Duy-Thanh/DroneShipping/SYM/CR1220/CR1220.step

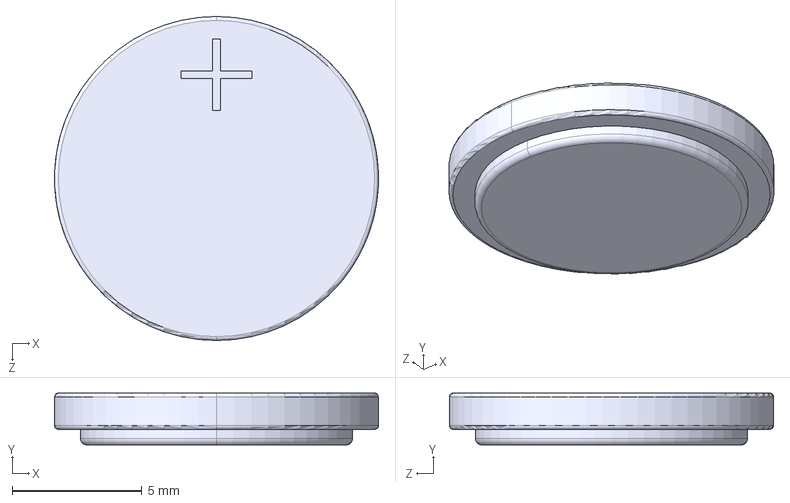
[picture p67: CAD file, 2025-03-07]
SYM/CR1220/CR1220.step
12.5 x 2.00 x 12.5 mm
