Duy-Thanh/DroneShipping/SYM/KiCad_Devices-master/KiCad_Devices-master/WSK1216/Footprint/WSK1216.STEP

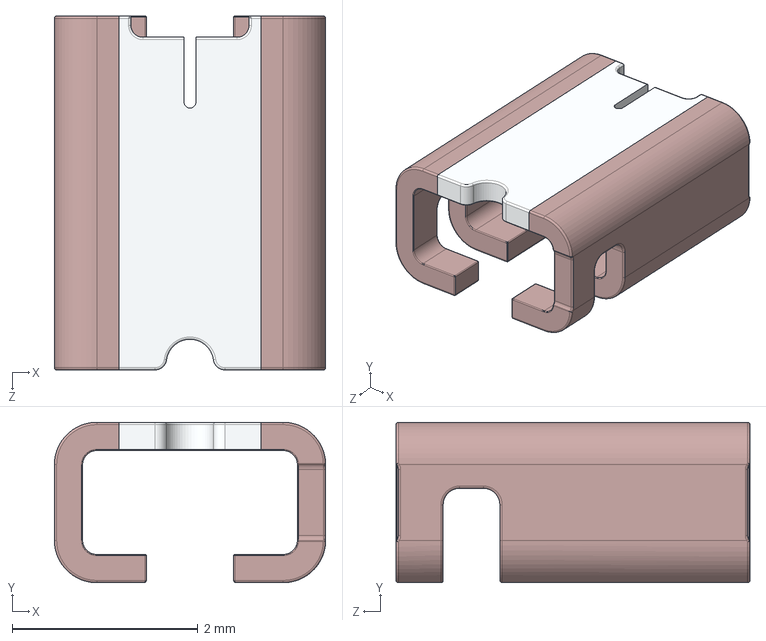
[picture p68: CAD file, 2025-03-07]
SYM/KiCad_Devices-master/KiCad_Devices-master/WSK1216/Footprint/WSK1216.STEP
2.92 x 1.73 x 3.81 mm
WSK1216-L5_element - Copy
WSK1216-L5_terminals - Copy
