Duy-Thanh/DroneShipping/SYM/SparkFun-KiCad-Libraries/Footprints/SparkFun-3D-models/Battery/XH414H-IV01E.STEP

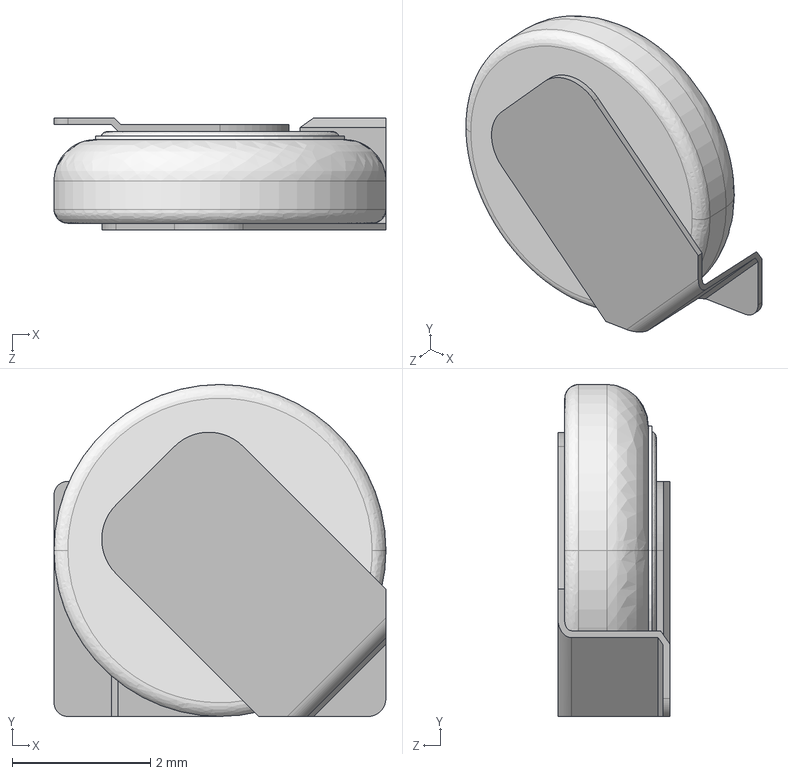
[picture p69: CAD file, 2025-03-07]
SYM/SparkFun-KiCad-Libraries/Footprints/SparkFun-3D-models/Battery/XH414H-IV01E.STEP
4.80 x 4.80 x 1.63 mm
isolator
cleme
Anode
Negative
Positive
