Duy-Thanh/DroneShipping/SYM/SparkFun-KiCad-Libraries/Footprints/SparkFun-3D-models/Capacitor/C_1206_3216Metric.step

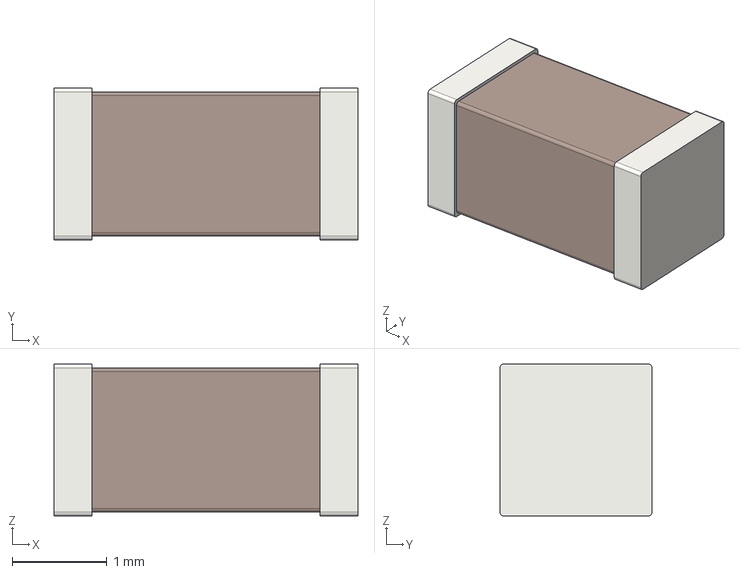
[picture p70: CAD file, 2025-03-07]
SYM/SparkFun-KiCad-Libraries/Footprints/SparkFun-3D-models/Capacitor/C_1206_3216Metric.step
3.20 x 1.60 x 1.60 mm
