Duy-Thanh/DroneShipping/SYM/SparkFun-KiCad-Libraries/Footprints/SparkFun-3D-models/Clock/Crystal_SMD_3.2x2.5mm.STEP

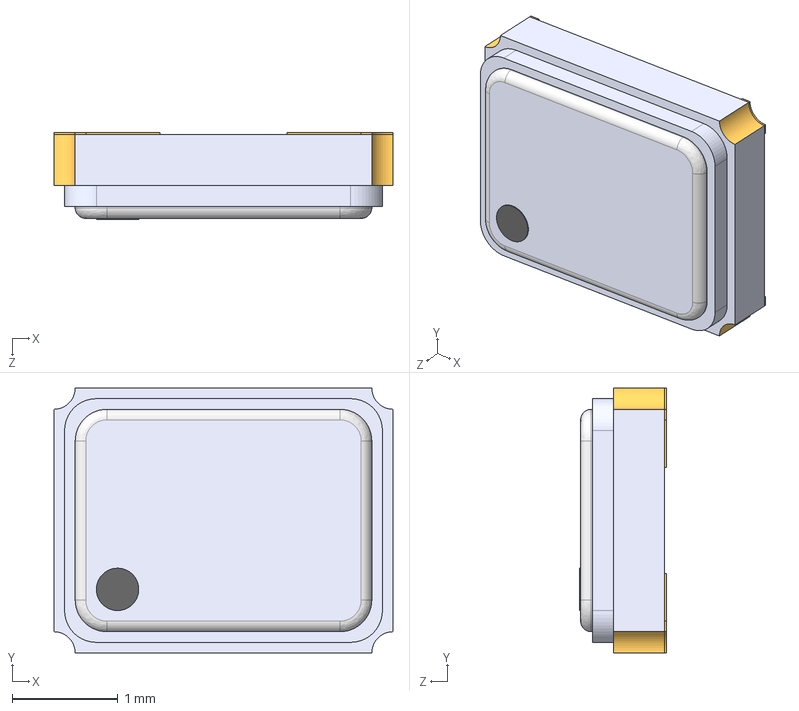
[picture p71: CAD file, 2025-03-07]
SYM/SparkFun-KiCad-Libraries/Footprints/SparkFun-3D-models/Clock/Crystal_SMD_3.2x2.5mm.STEP
3.20 x 2.50 x 0.82 mm
MetalFrame
Pin1Marker
Pin3
Pin1
Lid
Pin4
Pin2
Ceramic
