Duy-Thanh/DroneShipping/SYM/SparkFun-KiCad-Libraries/Footprints/SparkFun-3D-models/Coil/Inductor_7.3x6.6mm.stp

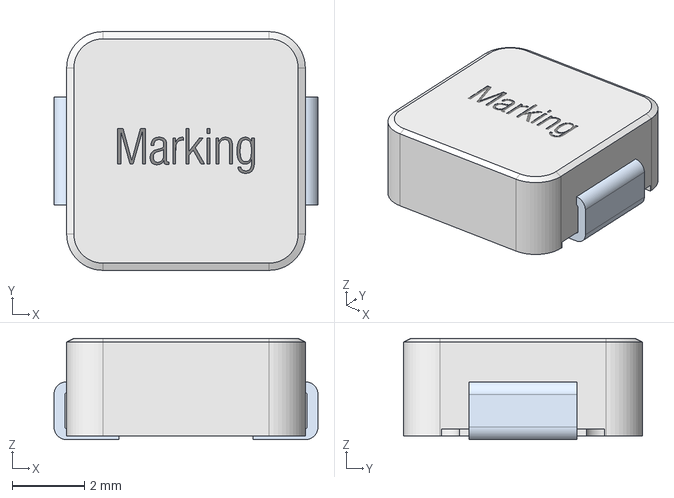
[picture p72: CAD file, 2025-03-07]
SYM/SparkFun-KiCad-Libraries/Footprints/SparkFun-3D-models/Coil/Inductor_7.3x6.6mm.stp
7.30 x 6.60 x 2.80 mm
