Duy-Thanh/DroneShipping/SYM/SparkFun-KiCad-Libraries/Footprints/SparkFun-3D-models/Connector/JST_SMD_1.25mm-6_Locking.step

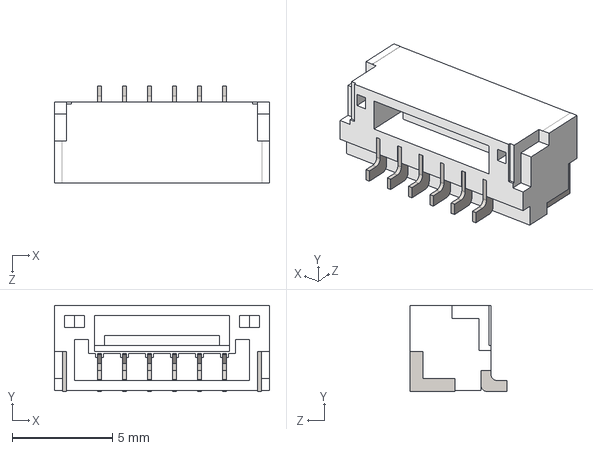
[picture p73: CAD file, 2025-03-07]
SYM/SparkFun-KiCad-Libraries/Footprints/SparkFun-3D-models/Connector/JST_SMD_1.25mm-6_Locking.step
10.8 x 4.30 x 4.85 mm
