Duy-Thanh/DroneShipping/SYM/SparkFun-KiCad-Libraries/Footprints/SparkFun-3D-models/Display/UG-2864KSWLG01.step

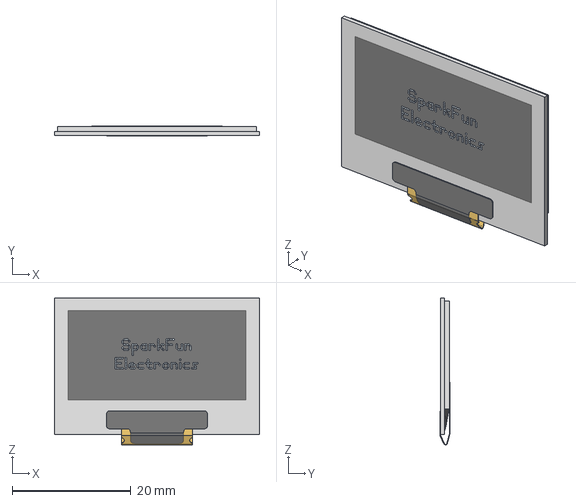
[picture p74: CAD file, 2025-03-07]
SYM/SparkFun-KiCad-Libraries/Footprints/SparkFun-3D-models/Display/UG-2864KSWLG01.step
34.5 x 1.75 x 24.7 mm
