Duy-Thanh/DroneShipping/SYM/SparkFun-KiCad-Libraries/Footprints/SparkFun-3D-models/Electromechanical/Buzzer_9mm_SMD.step

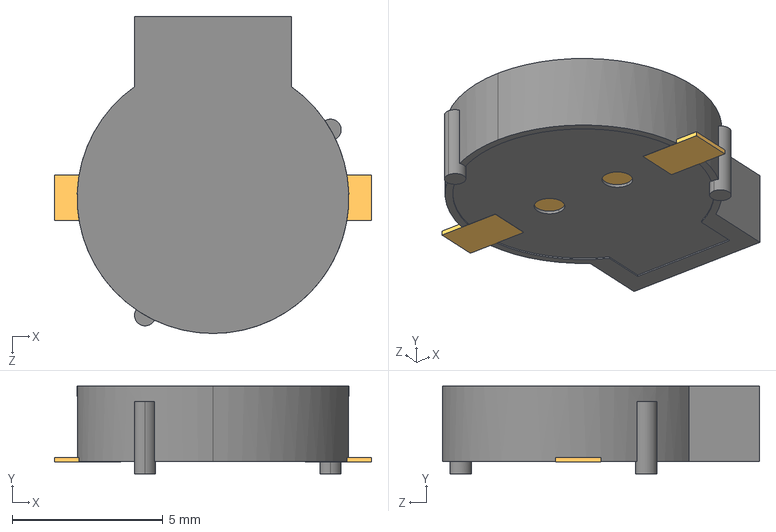
[picture p75: CAD file, 2025-03-07]
SYM/SparkFun-KiCad-Libraries/Footprints/SparkFun-3D-models/Electromechanical/Buzzer_9mm_SMD.step
10.5 x 2.90 x 10.5 mm
