Duy-Thanh/DroneShipping/SYM/SparkFun-KiCad-Libraries/Footprints/SparkFun-3D-models/Fuse/Fuse_1812_4532Metric.step

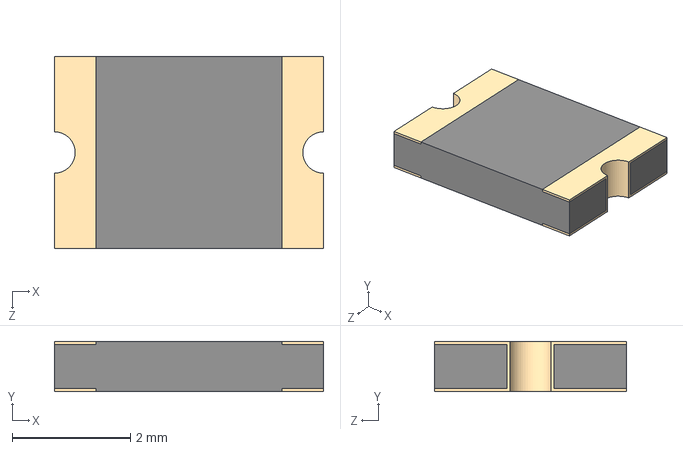
[picture p76: CAD file, 2025-03-07]
SYM/SparkFun-KiCad-Libraries/Footprints/SparkFun-3D-models/Fuse/Fuse_1812_4532Metric.step
4.55 x 0.85 x 3.24 mm
