Duy-Thanh/DroneShipping/SYM/SparkFun-KiCad-Libraries/Footprints/SparkFun-3D-models/GPS/NEO.STEP

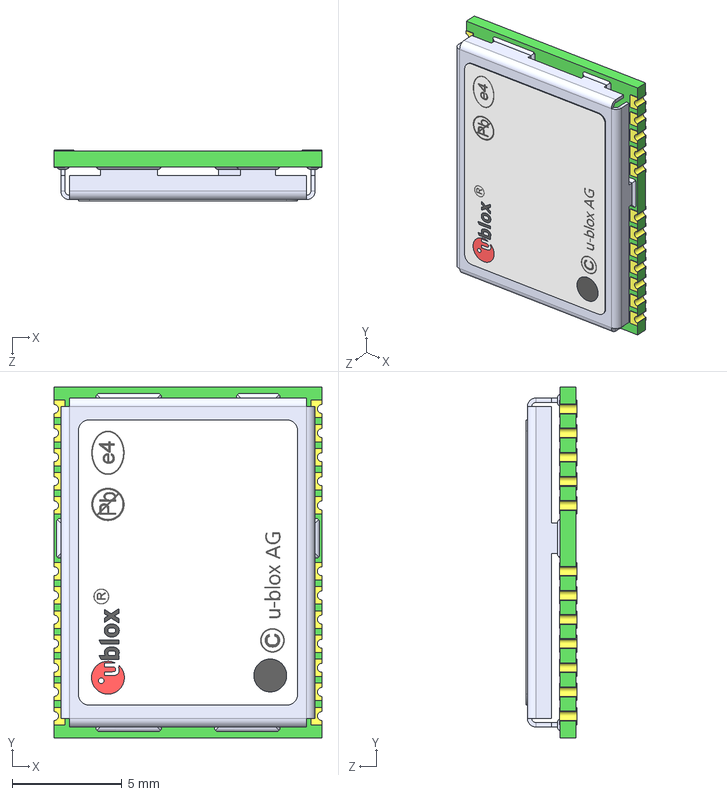
[picture p77: CAD file, 2025-03-07]
SYM/SparkFun-KiCad-Libraries/Footprints/SparkFun-3D-models/GPS/NEO.STEP
12.2 x 16.0 x 2.33 mm
NEO_PCB
Shield_NEO
u-blox_NEO_label
