Duy-Thanh/DroneShipping/SYM/SparkFun-KiCad-Libraries/Footprints/SparkFun-3D-models/LED/LED_1206_3216Metric_Castellated_White.step

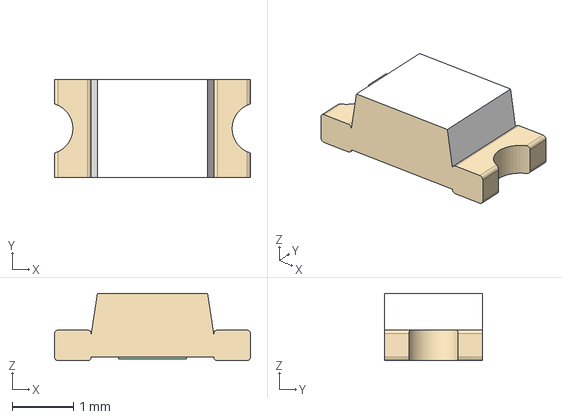
[picture p78: CAD file, 2025-03-07]
SYM/SparkFun-KiCad-Libraries/Footprints/SparkFun-3D-models/LED/LED_1206_3216Metric_Castellated_White.step
3.20 x 1.60 x 1.10 mm
