Duy-Thanh/DroneShipping/SYM/SparkFun-KiCad-Libraries/Footprints/SparkFun-3D-models/Resistor/R_0805_2012Metric.step

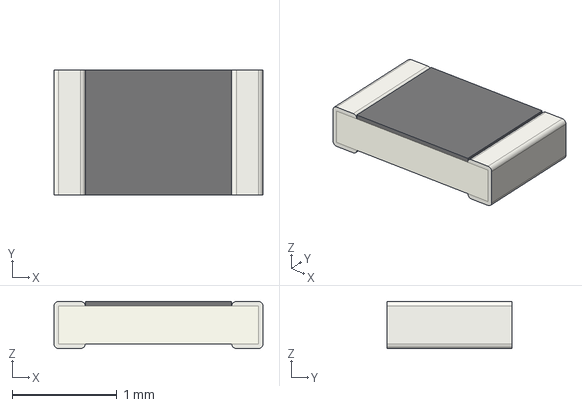
[picture p79: CAD file, 2025-03-07]
SYM/SparkFun-KiCad-Libraries/Footprints/SparkFun-3D-models/Resistor/R_0805_2012Metric.step
2.00 x 1.20 x 0.45 mm
