Duy-Thanh/DroneShipping/SYM/SparkFun-KiCad-Libraries/Footprints/SparkFun-3D-models/RF/ESP32-S3-MINI.step

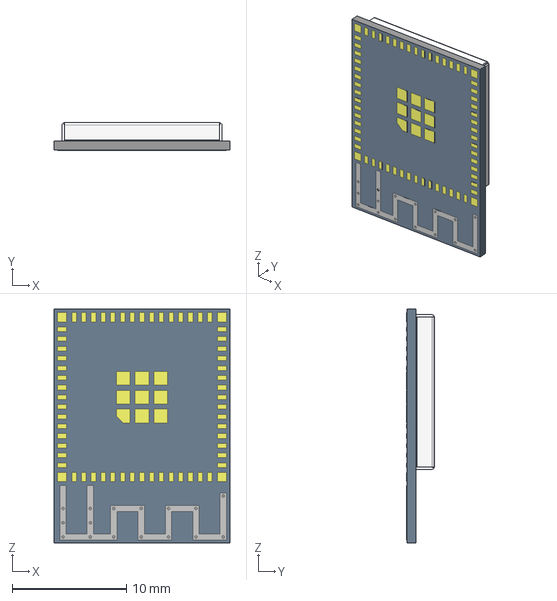
[picture p80: CAD file, 2025-03-07]
SYM/SparkFun-KiCad-Libraries/Footprints/SparkFun-3D-models/RF/ESP32-S3-MINI.step
15.4 x 2.42 x 20.5 mm
