Duy-Thanh/DroneShipping/SYM/SparkFun-KiCad-Libraries/Footprints/SparkFun-3D-models/Semiconductor-Nonstandard/Ag9200.step

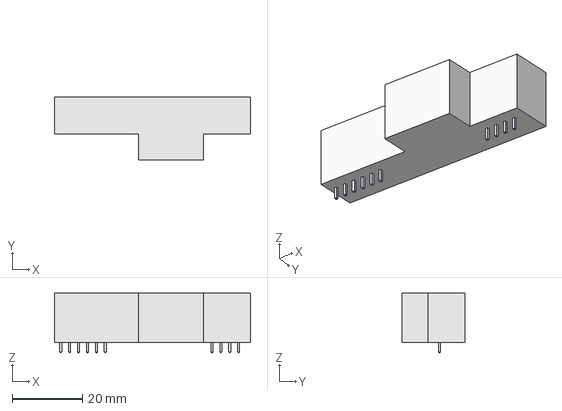
[picture p81: CAD file, 2025-03-07]
SYM/SparkFun-KiCad-Libraries/Footprints/SparkFun-3D-models/Semiconductor-Nonstandard/Ag9200.step
56.0 x 18.0 x 17.0 mm
