Duy-Thanh/DroneShipping/SYM/SparkFun-KiCad-Libraries/Footprints/SparkFun-3D-models/Sensor/SCD4x.step

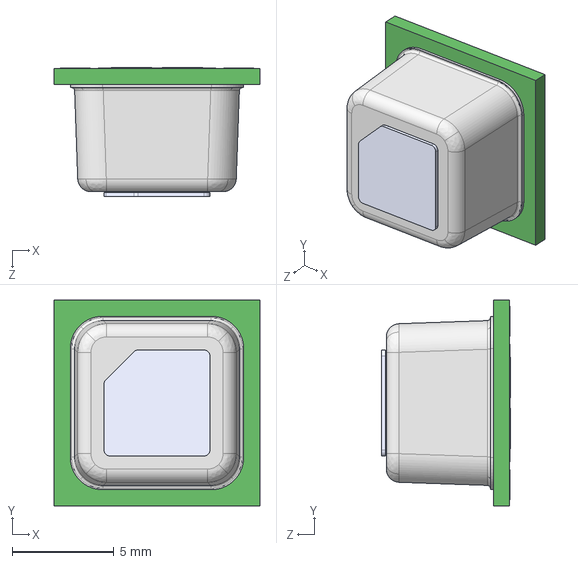
[picture p83: CAD file, 2025-03-07]
SYM/SparkFun-KiCad-Libraries/Footprints/SparkFun-3D-models/Sensor/SCD4x.step
10.1 x 10.1 x 6.31 mm
