Duy-Thanh/DroneShipping/SYM/SparkFun-KiCad-Libraries/Footprints/SparkFun-3D-models/Switch/Push_SMD_4.6x2.8mm_h2.5mm.step

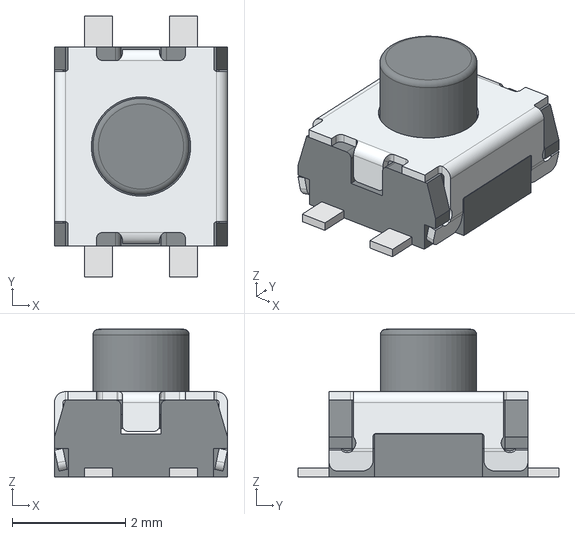
[picture p84: CAD file, 2025-03-07]
SYM/SparkFun-KiCad-Libraries/Footprints/SparkFun-3D-models/Switch/Push_SMD_4.6x2.8mm_h2.5mm.step
3.05 x 4.60 x 2.60 mm
