Duy-Thanh/DroneShipping/SYM/SparkFun-KiCad-Libraries/Footprints/SparkFun-3D-models/Capacitor/C_1210_3225Metric.step

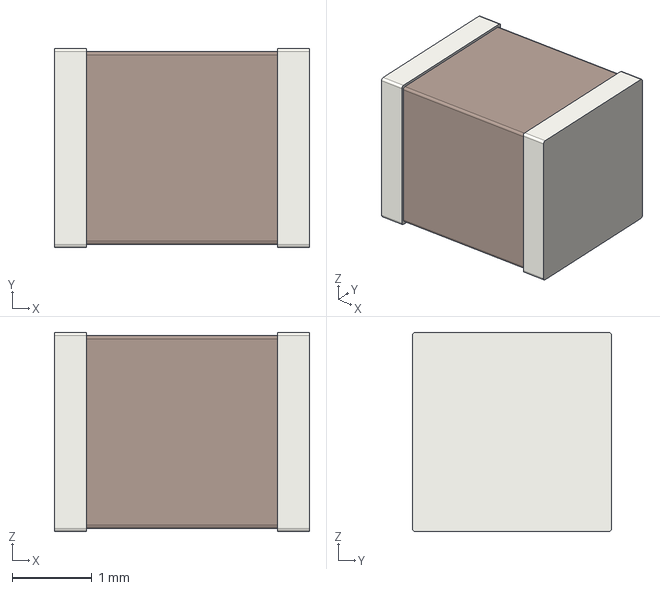
[picture p85: CAD file, 2025-03-07]
SYM/SparkFun-KiCad-Libraries/Footprints/SparkFun-3D-models/Capacitor/C_1210_3225Metric.step
3.20 x 2.50 x 2.50 mm
