Duy-Thanh/DroneShipping/SYM/SparkFun-KiCad-Libraries/Footprints/SparkFun-3D-models/Clock/Crystal_SMD_3.2x1.5mm.step

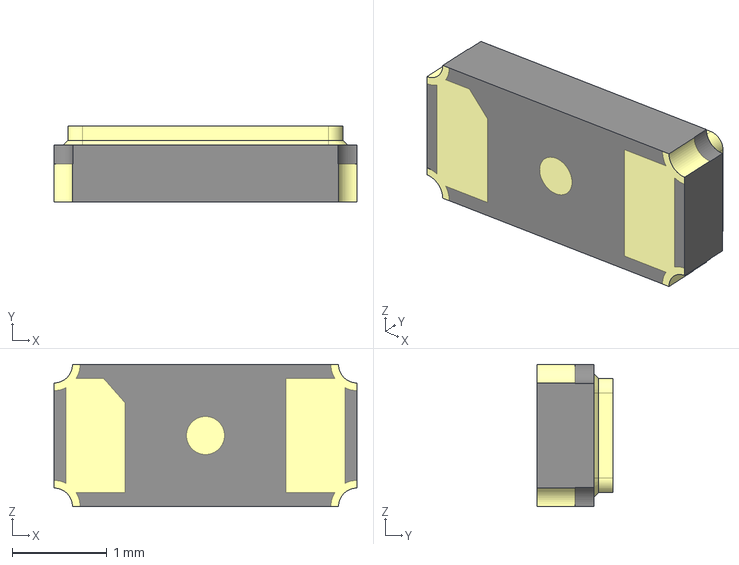
[picture p86: CAD file, 2025-03-07]
SYM/SparkFun-KiCad-Libraries/Footprints/SparkFun-3D-models/Clock/Crystal_SMD_3.2x1.5mm.step
3.20 x 0.801 x 1.50 mm
