Duy-Thanh/DroneShipping/SYM/SparkFun-KiCad-Libraries/Footprints/SparkFun-3D-models/Coil/Inductor_0806.step

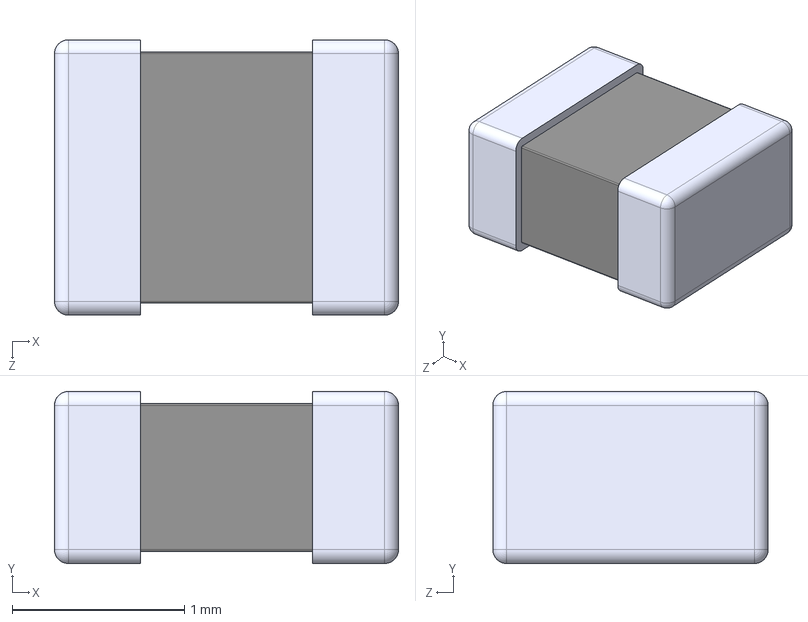
[picture p87: CAD file, 2025-03-07]
SYM/SparkFun-KiCad-Libraries/Footprints/SparkFun-3D-models/Coil/Inductor_0806.step
2.00 x 1.00 x 1.60 mm
