Duy-Thanh/DroneShipping/SYM/SparkFun-KiCad-Libraries/Footprints/SparkFun-3D-models/Connector/1x07_2.0mm_SMD_Pin1RightDown.step

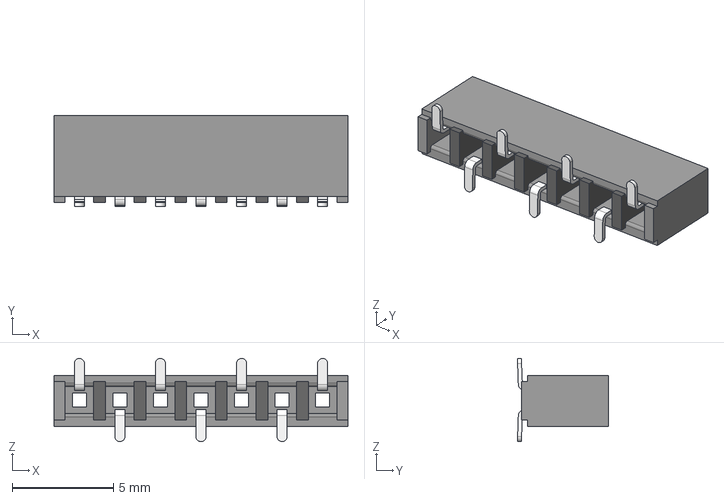
[picture p88: CAD file, 2025-03-07]
SYM/SparkFun-KiCad-Libraries/Footprints/SparkFun-3D-models/Connector/1x07_2.0mm_SMD_Pin1RightDown.step
14.5 x 4.50 x 4.10 mm
