Duy-Thanh/DroneShipping/SYM/SparkFun-KiCad-Libraries/Footprints/SparkFun-3D-models/Electromechanical/Relay_10.2x18.4mm.step

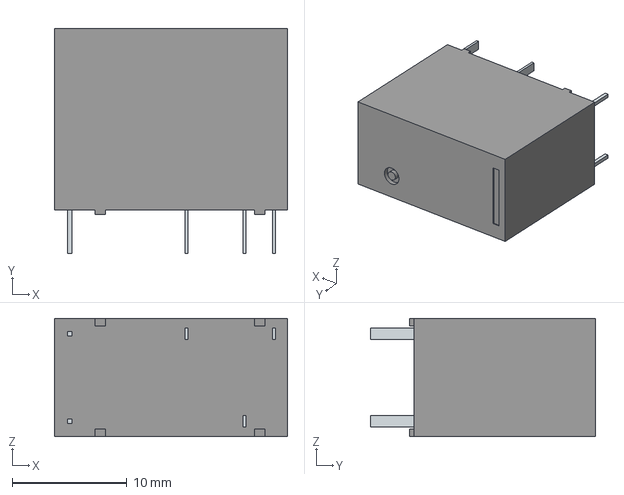
[picture p89: CAD file, 2025-03-07]
SYM/SparkFun-KiCad-Libraries/Footprints/SparkFun-3D-models/Electromechanical/Relay_10.2x18.4mm.step
20.3 x 19.6 x 10.3 mm
