Duy-Thanh/DroneShipping/SYM/SparkFun-KiCad-Libraries/Footprints/SparkFun-3D-models/Fuse/Fuse_1206_3216Metric.step

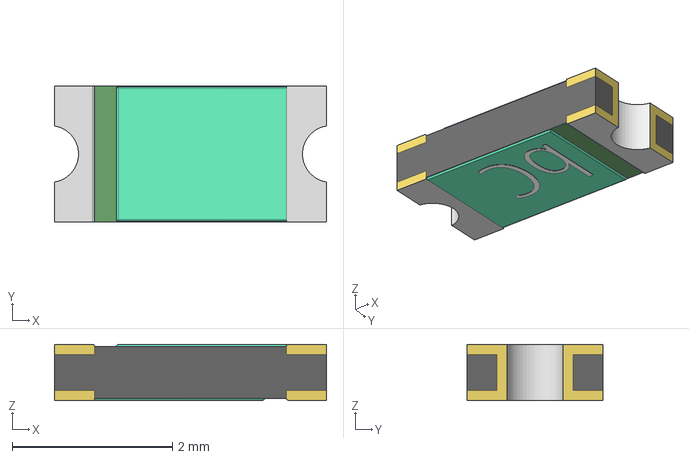
[picture p90: CAD file, 2025-03-07]
SYM/SparkFun-KiCad-Libraries/Footprints/SparkFun-3D-models/Fuse/Fuse_1206_3216Metric.step
3.40 x 1.70 x 0.704 mm
