Duy-Thanh/DroneShipping/SYM/SparkFun-KiCad-Libraries/Footprints/SparkFun-3D-models/GPS/LG290P.step

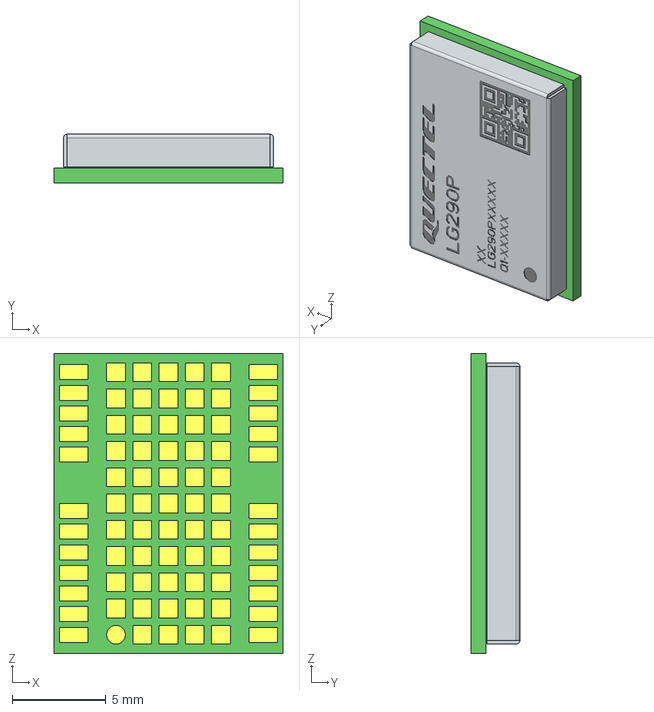
[picture p91: CAD file, 2025-03-07]
SYM/SparkFun-KiCad-Libraries/Footprints/SparkFun-3D-models/GPS/LG290P.step
12.2 x 2.60 x 16.0 mm
