Duy-Thanh/DroneShipping/SYM/SparkFun-KiCad-Libraries/Footprints/SparkFun-3D-models/LED/LED_0603_1608Metric_Yellow.step

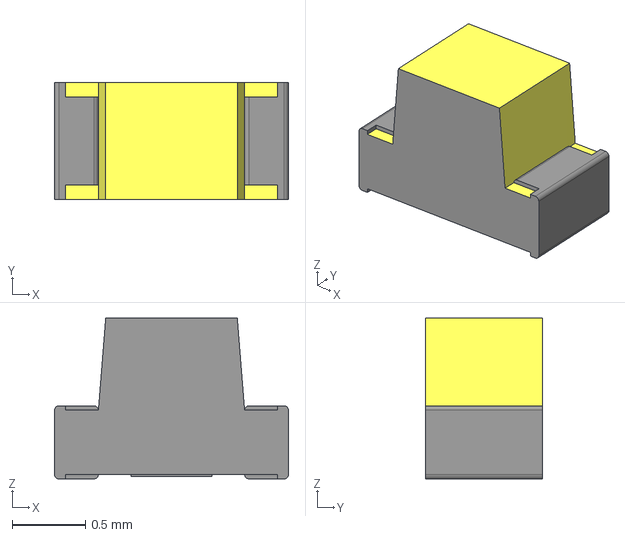
[picture p92: CAD file, 2025-03-07]
SYM/SparkFun-KiCad-Libraries/Footprints/SparkFun-3D-models/LED/LED_0603_1608Metric_Yellow.step
1.60 x 0.8 x 1.10 mm
