Duy-Thanh/DroneShipping/SYM/SparkFun-KiCad-Libraries/Footprints/SparkFun-3D-models/Resistor/R_1206_3216Metric.step

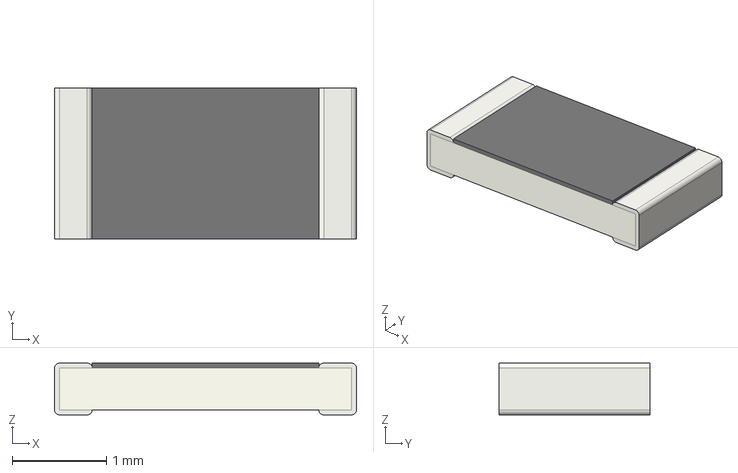
[picture p93: CAD file, 2025-03-07]
SYM/SparkFun-KiCad-Libraries/Footprints/SparkFun-3D-models/Resistor/R_1206_3216Metric.step
3.20 x 1.60 x 0.55 mm
