Duy-Thanh/DroneShipping/SYM/SparkFun-KiCad-Libraries/Footprints/SparkFun-3D-models/Semiconductor-Nonstandard/Ag9900M_MT.stp

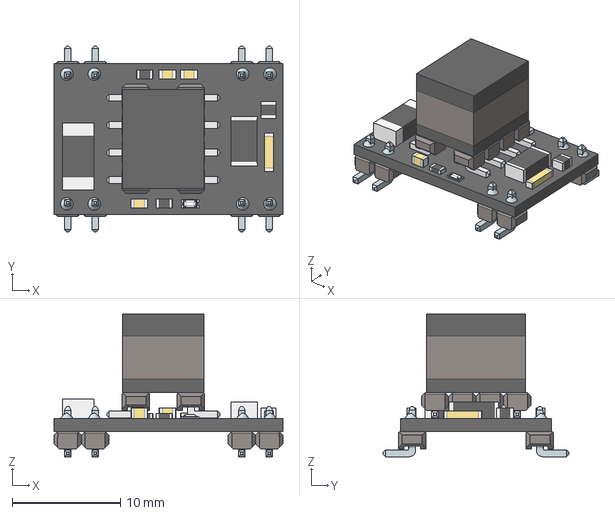
[picture p94: CAD file, 2025-03-07]
SYM/SparkFun-KiCad-Libraries/Footprints/SparkFun-3D-models/Semiconductor-Nonstandard/Ag9900M_MT.stp
21.2 x 17.2 x 13.2 mm
