Duy-Thanh/DroneShipping/SYM/SparkFun-KiCad-Libraries/Footprints/SparkFun-3D-models/Semiconductor-Standard/TSSOP-16_4.4x5mm_P0.65mm.step

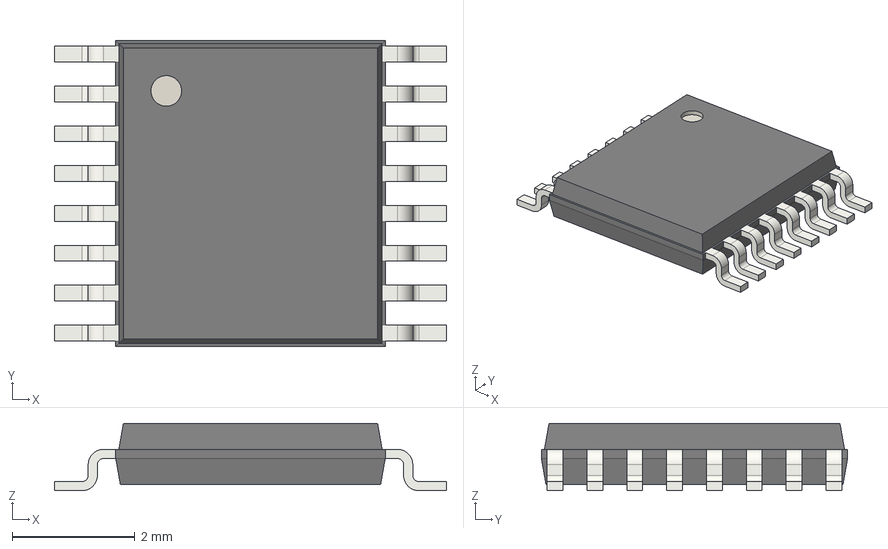
[picture p95: CAD file, 2025-03-07]
SYM/SparkFun-KiCad-Libraries/Footprints/SparkFun-3D-models/Semiconductor-Standard/TSSOP-16_4.4x5mm_P0.65mm.step
6.40 x 5.00 x 1.10 mm
