Duy-Thanh/DroneShipping/SYM/SparkFun-KiCad-Libraries/Footprints/SparkFun-3D-models/Sensor/ST_VL53L1x.step

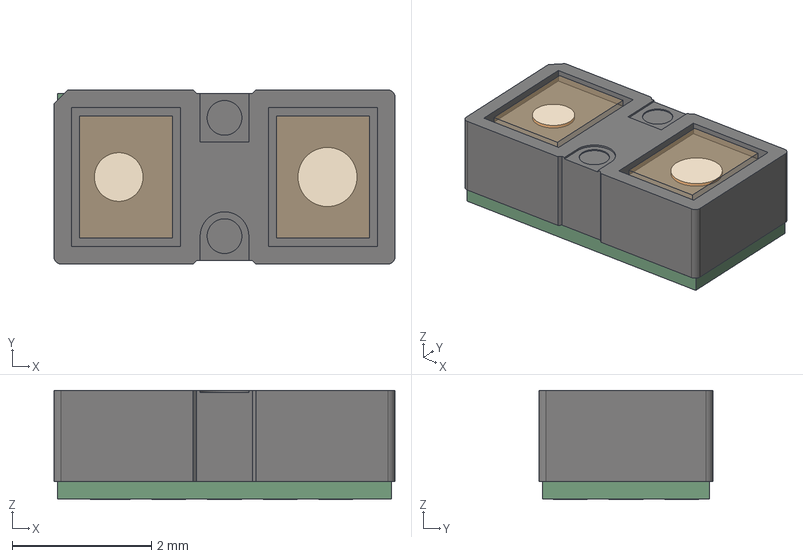
[picture p96: CAD file, 2025-03-07]
SYM/SparkFun-KiCad-Libraries/Footprints/SparkFun-3D-models/Sensor/ST_VL53L1x.step
4.90 x 2.50 x 1.57 mm
