Duy-Thanh/DroneShipping/SYM/SparkFun-KiCad-Libraries/Footprints/SparkFun-3D-models/Switch/Tactal Switch - THRU(12mmx12mm - Illuminated - Red.stp

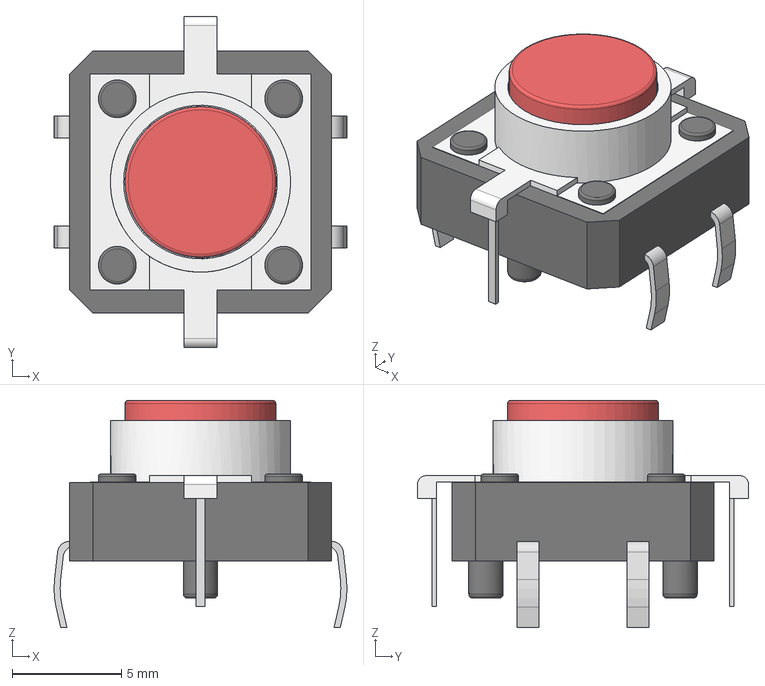
[picture p97: CAD file, 2025-03-07]
SYM/SparkFun-KiCad-Libraries/Footprints/SparkFun-3D-models/Switch/Tactal Switch - THRU(12mmx12mm - Illuminated - Red.stp
13.4 x 15.2 x 10.4 mm
