Duy-Thanh/DroneShipping/SYM/SparkFun-KiCad-Libraries/Footprints/SparkFun-3D-models/Capacitor/C_0402_1005Metric.step

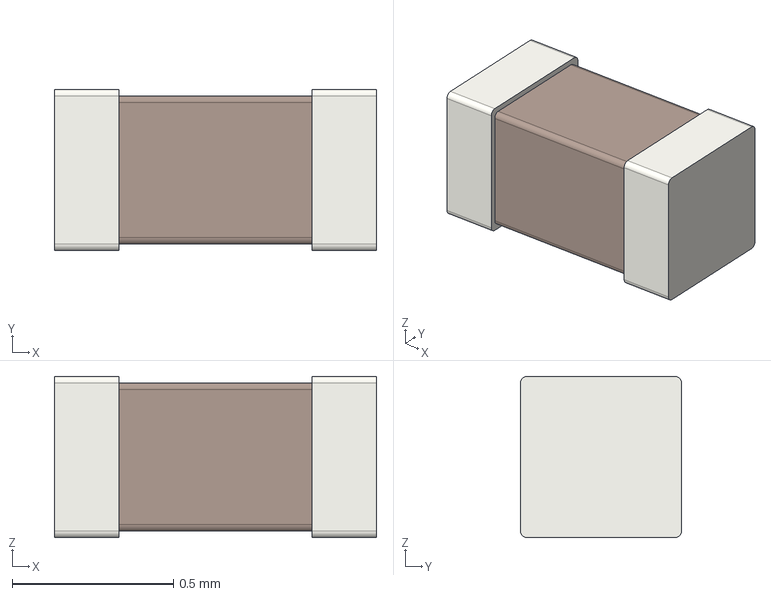
[picture p98: CAD file, 2025-03-07]
SYM/SparkFun-KiCad-Libraries/Footprints/SparkFun-3D-models/Capacitor/C_0402_1005Metric.step
1.00 x 0.5 x 0.5 mm
