Duy-Thanh/DroneShipping/SYM/SparkFun-KiCad-Libraries/Footprints/SparkFun-3D-models/Clock/Ceramic_5032_10pins.STEP

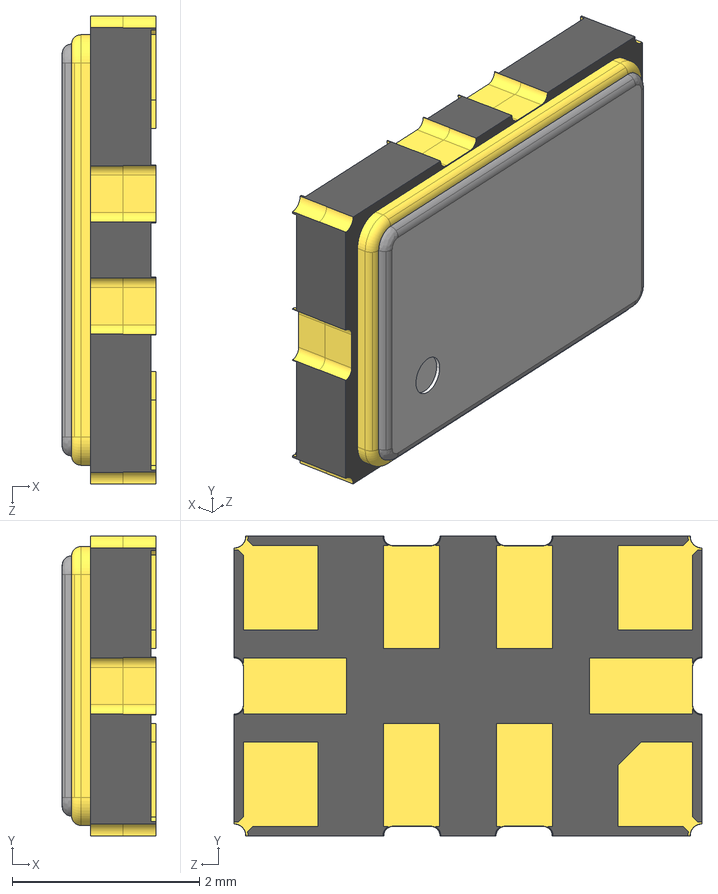
[picture p99: CAD file, 2025-03-07]
SYM/SparkFun-KiCad-Libraries/Footprints/SparkFun-3D-models/Clock/Ceramic_5032_10pins.STEP
1.00 x 3.20 x 5.00 mm
