Duy-Thanh/DroneShipping/SYM/SparkFun-KiCad-Libraries/Footprints/SparkFun-3D-models/Coil/CHIP_100M4T_WAL.step

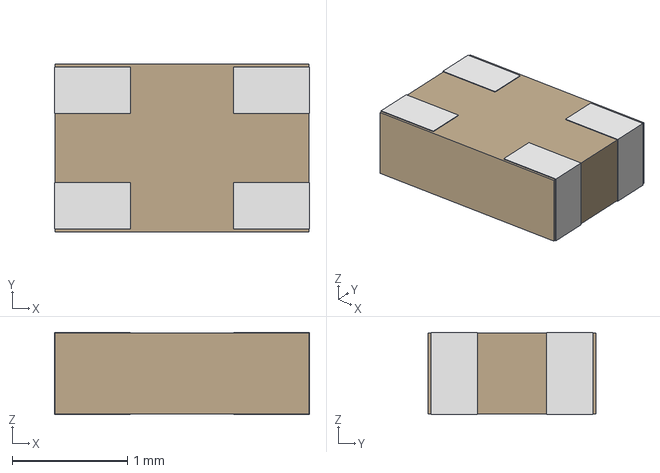
[picture p100: CAD file, 2025-03-07]
SYM/SparkFun-KiCad-Libraries/Footprints/SparkFun-3D-models/Coil/CHIP_100M4T_WAL.step
2.21 x 1.46 x 0.711 mm
