Duy-Thanh/DroneShipping/SYM/SparkFun-KiCad-Libraries/Footprints/SparkFun-3D-models/Connector/JST_SMD_1.0mm-5.STEP

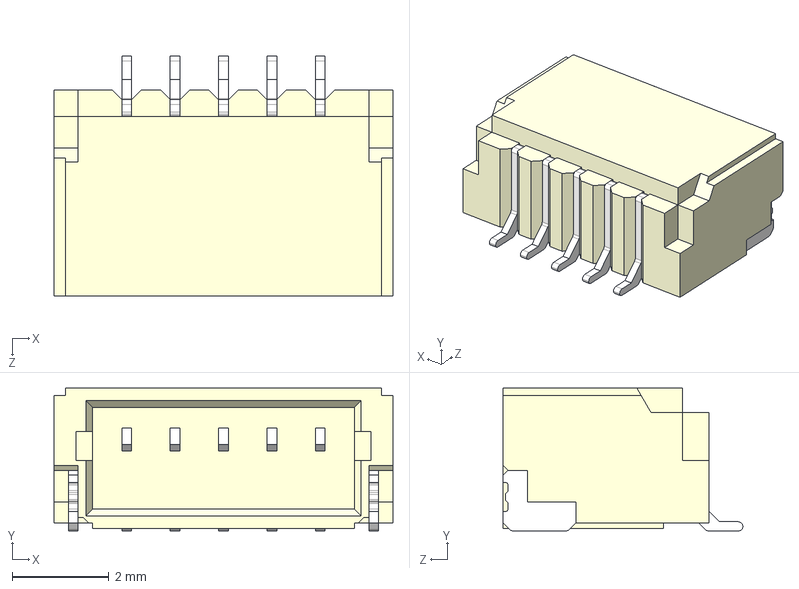
[picture p101: CAD file, 2025-03-07]
SYM/SparkFun-KiCad-Libraries/Footprints/SparkFun-3D-models/Connector/JST_SMD_1.0mm-5.STEP
7.00 x 2.95 x 4.95 mm
