Duy-Thanh/DroneShipping/SYM/SparkFun-KiCad-Libraries/Footprints/SparkFun-3D-models/Electromechanical/Relay_5.0x20.0mm.step

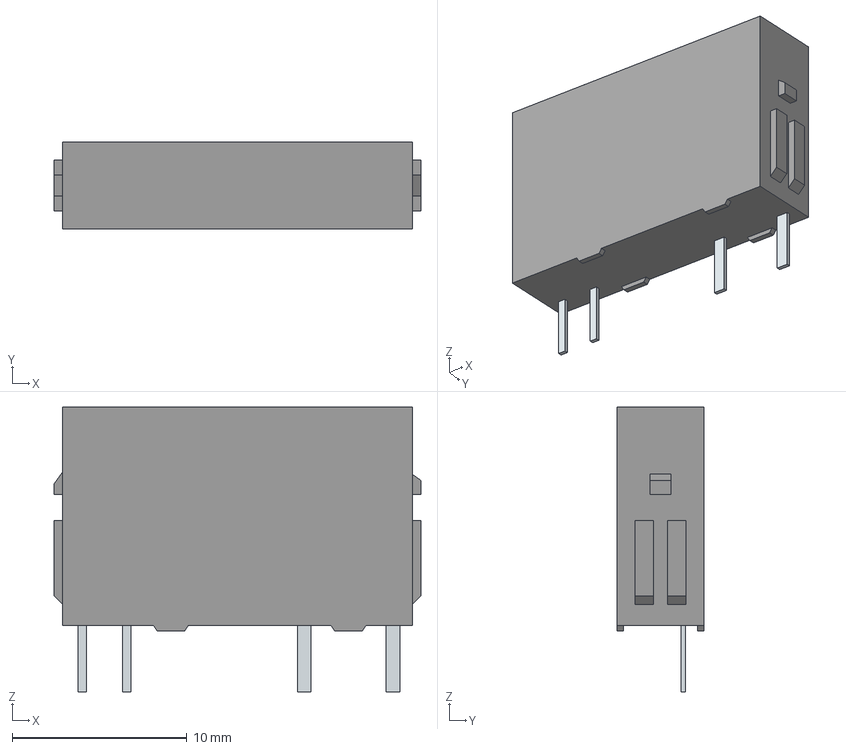
[picture p102: CAD file, 2025-03-07]
SYM/SparkFun-KiCad-Libraries/Footprints/SparkFun-3D-models/Electromechanical/Relay_5.0x20.0mm.step
21.0 x 5.00 x 16.3 mm
