Duy-Thanh/DroneShipping/SYM/SparkFun-KiCad-Libraries/Footprints/SparkFun-3D-models/Fuse/Fuse_0805_2012Metric.step

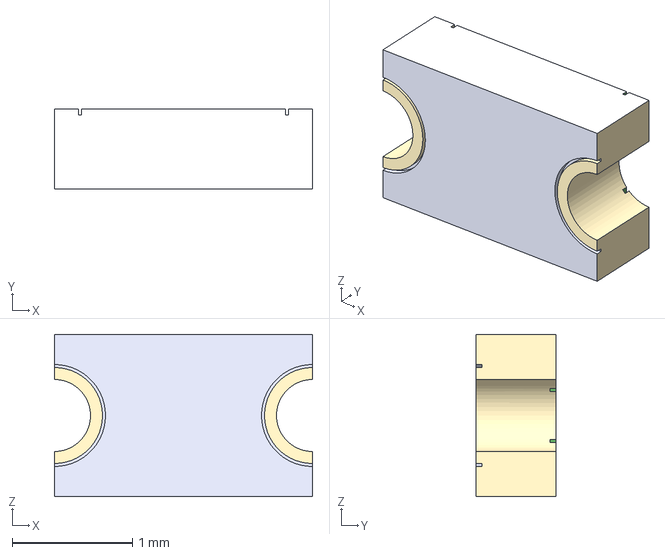
[picture p103: CAD file, 2025-03-07]
SYM/SparkFun-KiCad-Libraries/Footprints/SparkFun-3D-models/Fuse/Fuse_0805_2012Metric.step
2.15 x 0.665 x 1.35 mm
