Duy-Thanh/DroneShipping/SYM/SparkFun-KiCad-Libraries/Footprints/SparkFun-3D-models/GPS/mosaic-X5-Rev5.step

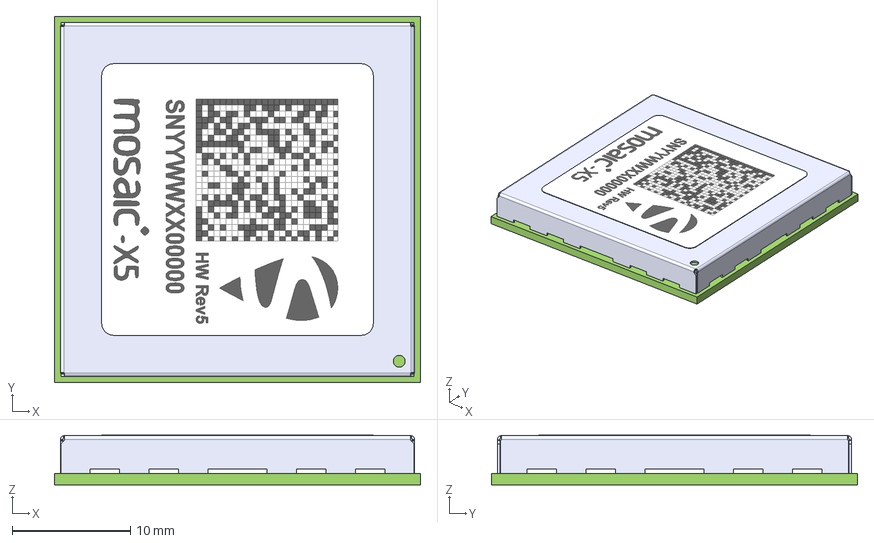
[picture p104: CAD file, 2025-03-07]
SYM/SparkFun-KiCad-Libraries/Footprints/SparkFun-3D-models/GPS/mosaic-X5-Rev5.step
31.0 x 31.0 x 4.21 mm
PAR-00001366
PAR-00000988(Default)
PAR-00001381
