Duy-Thanh/DroneShipping/SYM/SparkFun-KiCad-Libraries/Footprints/SparkFun-3D-models/Resistor/R_1210_3225Metric.step

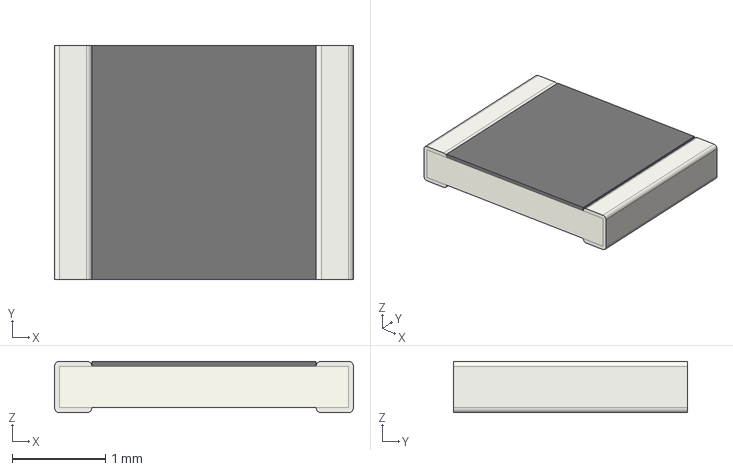
[picture p105: CAD file, 2025-03-07]
SYM/SparkFun-KiCad-Libraries/Footprints/SparkFun-3D-models/Resistor/R_1210_3225Metric.step
3.20 x 2.50 x 0.55 mm
