Duy-Thanh/DroneShipping/SYM/SparkFun-KiCad-Libraries/Footprints/SparkFun-3D-models/Semiconductor-Nonstandard/REC15E-SZ.step

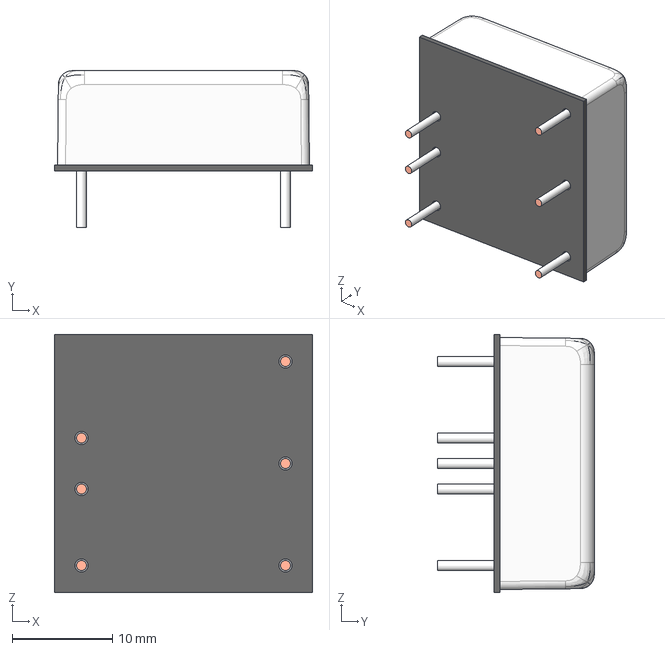
[picture p107: CAD file, 2025-03-07]
SYM/SparkFun-KiCad-Libraries/Footprints/SparkFun-3D-models/Semiconductor-Nonstandard/REC15E-SZ.step
25.7 x 15.6 x 25.7 mm
