Duy-Thanh/DroneShipping/SYM/SparkFun-KiCad-Libraries/Footprints/SparkFun-3D-models/Semiconductor-Standard/SOT-363_SC-70-6.step

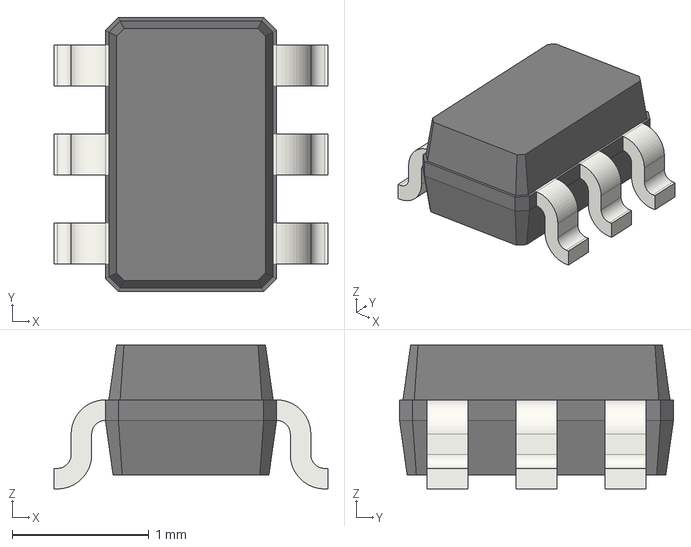
[picture p108: CAD file, 2025-03-07]
SYM/SparkFun-KiCad-Libraries/Footprints/SparkFun-3D-models/Semiconductor-Standard/SOT-363_SC-70-6.step
2.00 x 2.00 x 1.05 mm
