Duy-Thanh/DroneShipping/SYM/SparkFun-KiCad-Libraries/Footprints/SparkFun-3D-models/Switch/Push_SMD_6x3.5mm.step

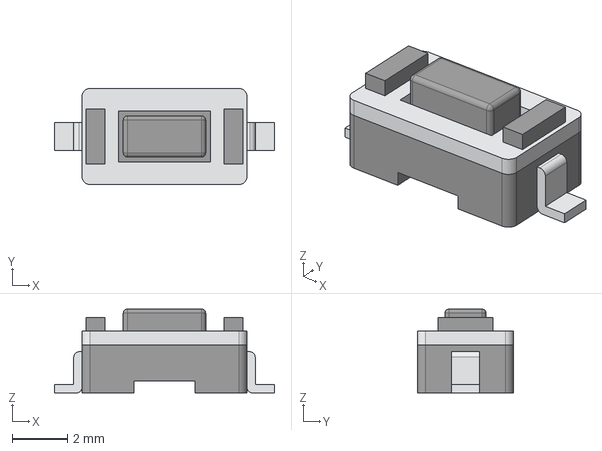
[picture p109: CAD file, 2025-03-07]
SYM/SparkFun-KiCad-Libraries/Footprints/SparkFun-3D-models/Switch/Push_SMD_6x3.5mm.step
8.00 x 3.50 x 3.05 mm
