Duy-Thanh/DroneShipping/SYM/SparkFun-KiCad-Libraries/Footprints/SparkFun-3D-models/Capacitor/C_0603_1608Metric.step

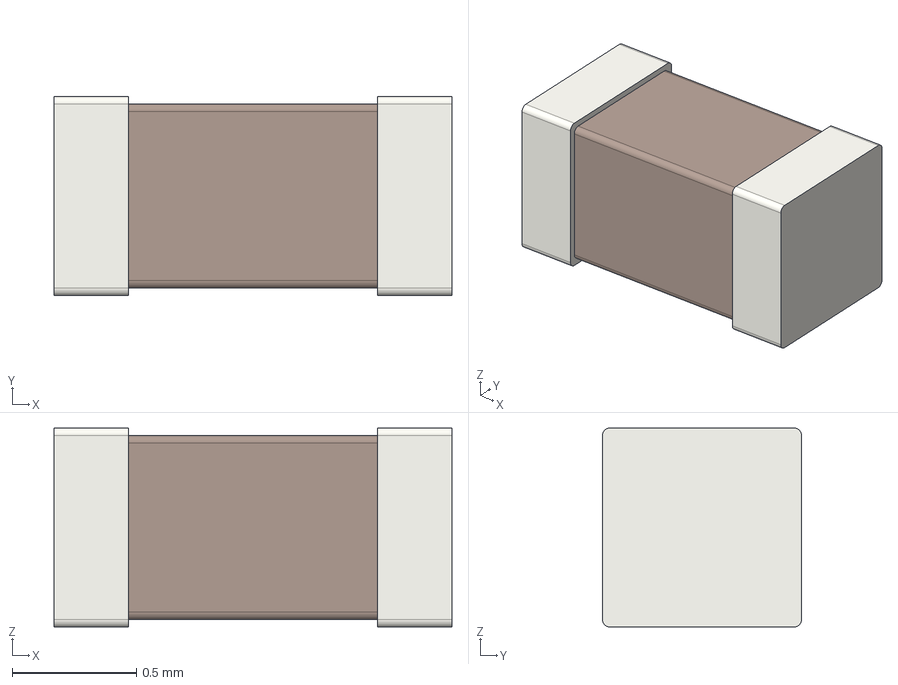
[picture p110: CAD file, 2025-03-07]
SYM/SparkFun-KiCad-Libraries/Footprints/SparkFun-3D-models/Capacitor/C_0603_1608Metric.step
1.60 x 0.8 x 0.8 mm
