Duy-Thanh/DroneShipping/SYM/SparkFun-KiCad-Libraries/Footprints/SparkFun-3D-models/Clock/Crystal_SMD_2.5x2.0mm.step

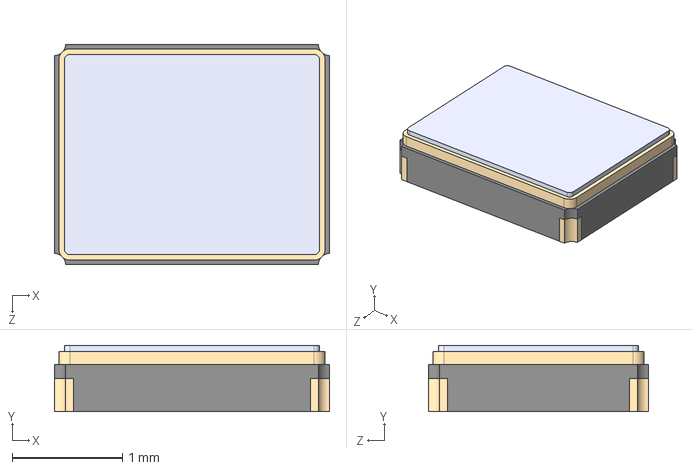
[picture p111: CAD file, 2025-03-07]
SYM/SparkFun-KiCad-Libraries/Footprints/SparkFun-3D-models/Clock/Crystal_SMD_2.5x2.0mm.step
2.50 x 0.6 x 2.00 mm
