Duy-Thanh/DroneShipping/SYM/SparkFun-KiCad-Libraries/Footprints/SparkFun-3D-models/Connector/PinHeader_1x04_P2.54mm_Vertical.step

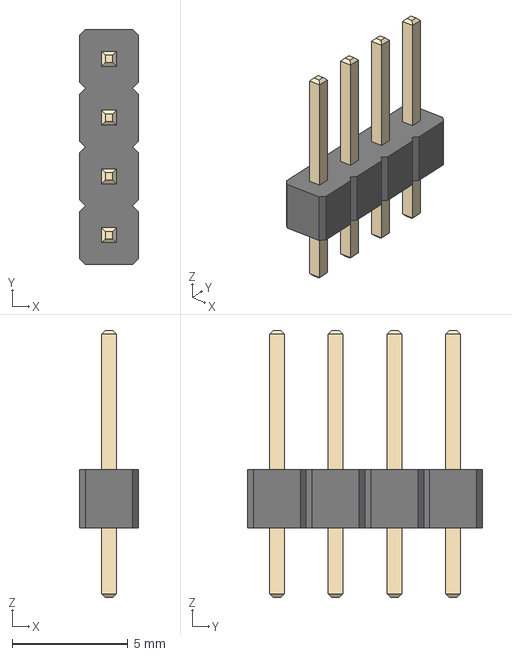
[picture p112: CAD file, 2025-03-07]
SYM/SparkFun-KiCad-Libraries/Footprints/SparkFun-3D-models/Connector/PinHeader_1x04_P2.54mm_Vertical.step
2.54 x 10.2 x 11.5 mm
