Duy-Thanh/DroneShipping/SYM/SparkFun-KiCad-Libraries/Footprints/SparkFun-3D-models/Electromechanical/Roller_Encoder.step

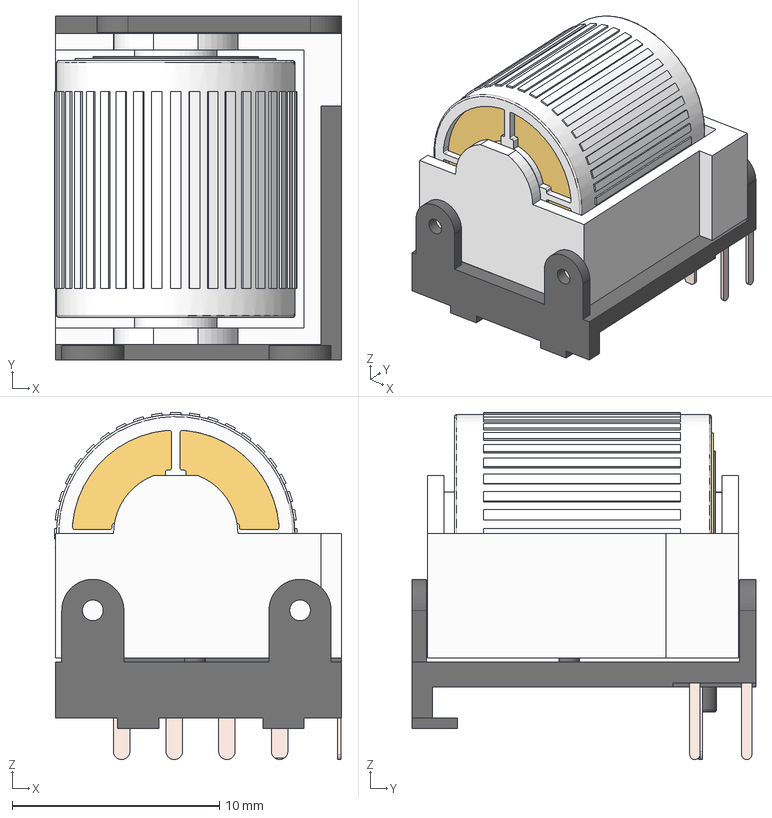
[picture p113: CAD file, 2025-03-07]
SYM/SparkFun-KiCad-Libraries/Footprints/SparkFun-3D-models/Electromechanical/Roller_Encoder.step
13.9 x 16.6 x 16.8 mm
Plastic
Barrel in
Cap
Barrel out
Leg (1)
housing
Leg (2)
Leg (3)
Plastic (1)
Leg
Leg (4)
Leg (5)
