Duy-Thanh/DroneShipping/SYM/SparkFun-KiCad-Libraries/Footprints/SparkFun-3D-models/Fuse/Fuse_1210_3225Metric.step

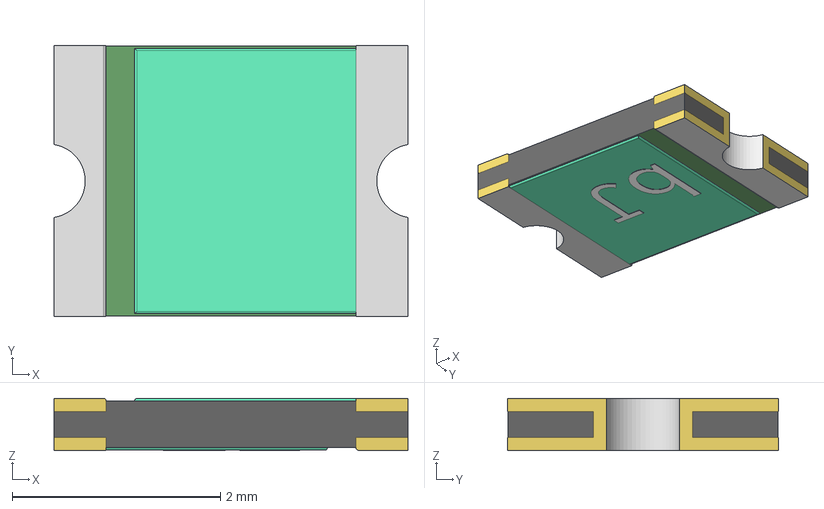
[picture p114: CAD file, 2025-03-07]
SYM/SparkFun-KiCad-Libraries/Footprints/SparkFun-3D-models/Fuse/Fuse_1210_3225Metric.step
3.40 x 2.60 x 0.504 mm
