Duy-Thanh/DroneShipping/SYM/SparkFun-KiCad-Libraries/Footprints/SparkFun-3D-models/GPS/zed-f9p.STEP

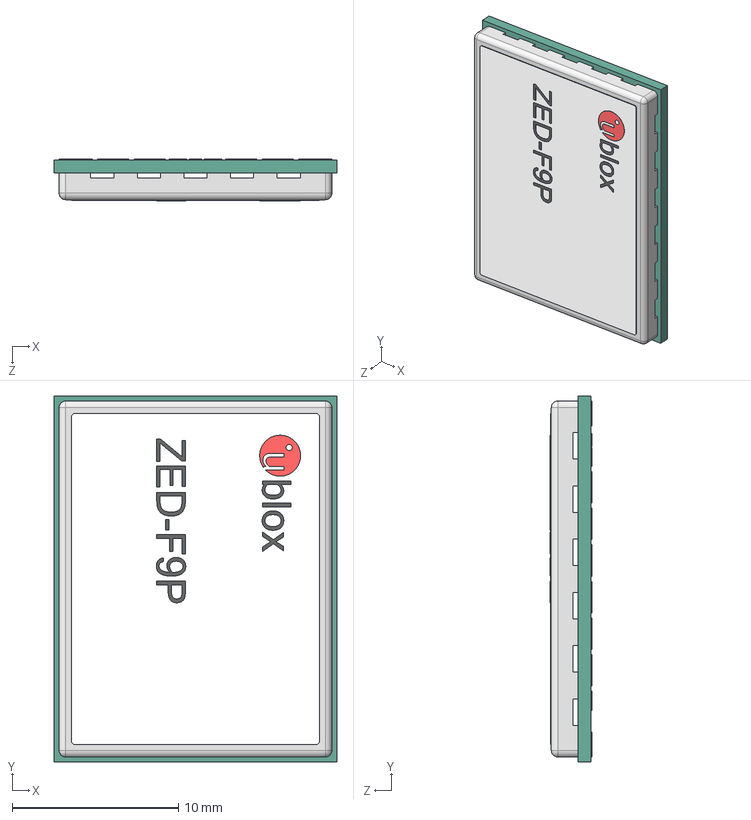
[picture p115: CAD file, 2025-03-07]
SYM/SparkFun-KiCad-Libraries/Footprints/SparkFun-3D-models/GPS/zed-f9p.STEP
17.0 x 22.0 x 2.50 mm
Imported
Imported_2
Imported_3
Imported_4
Imported_5
Imported_6
