Duy-Thanh/DroneShipping/SYM/SparkFun-KiCad-Libraries/Footprints/SparkFun-3D-models/Resistor/R_0603_1608Metric.step

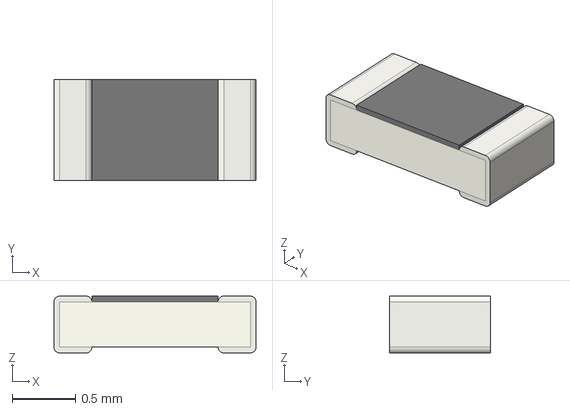
[picture p116: CAD file, 2025-03-07]
SYM/SparkFun-KiCad-Libraries/Footprints/SparkFun-3D-models/Resistor/R_0603_1608Metric.step
1.60 x 0.8 x 0.45 mm
