Duy-Thanh/DroneShipping/SYM/SparkFun-KiCad-Libraries/Footprints/SparkFun-3D-models/RF/RM2.STEP

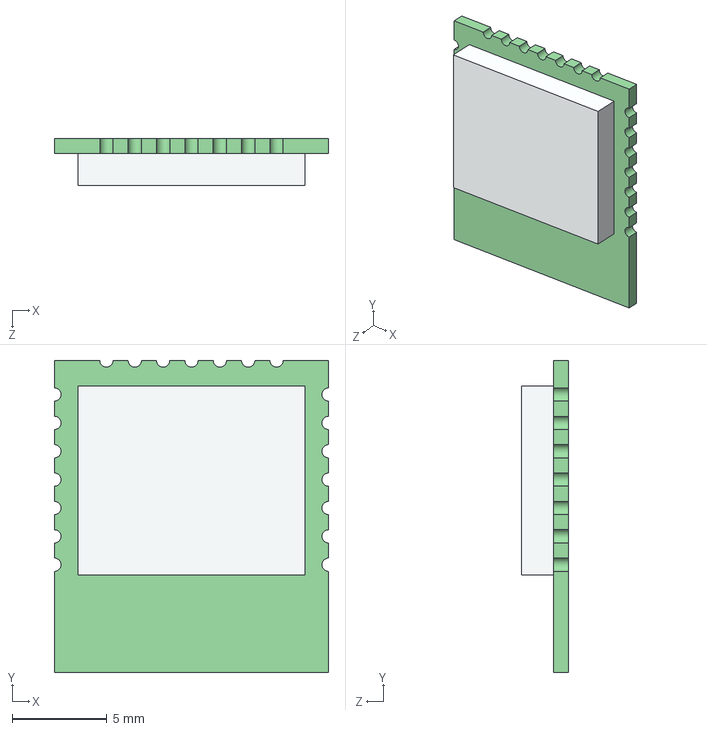
[picture p117: CAD file, 2025-03-07]
SYM/SparkFun-KiCad-Libraries/Footprints/SparkFun-3D-models/RF/RM2.STEP
14.5 x 16.5 x 2.50 mm
