Duy-Thanh/DroneShipping/SYM/SparkFun-KiCad-Libraries/Footprints/SparkFun-3D-models/Switch/Tactile_Switch_5.2x5.2mm_h2.5mm.step

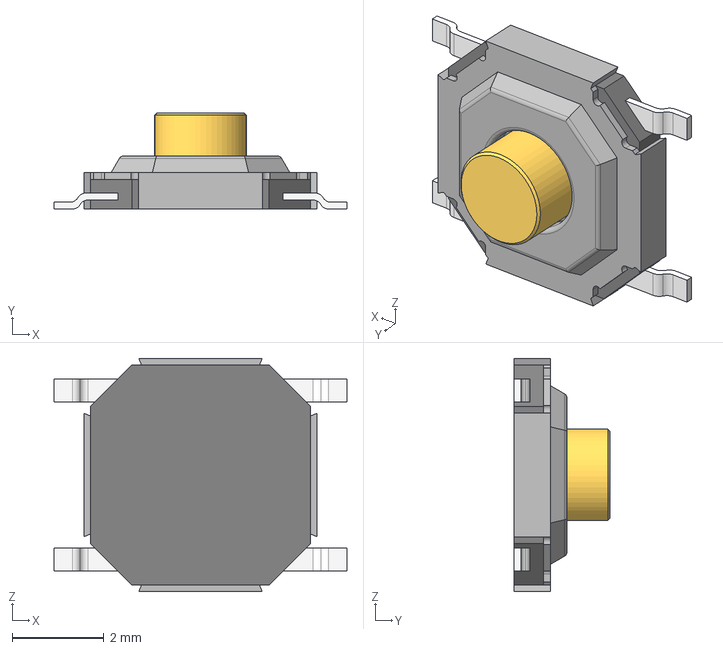
[picture p119: CAD file, 2025-03-07]
SYM/SparkFun-KiCad-Libraries/Footprints/SparkFun-3D-models/Switch/Tactile_Switch_5.2x5.2mm_h2.5mm.step
6.40 x 2.10 x 5.10 mm
