Duy-Thanh/DroneShipping/SYM/SparkFun-KiCad-Libraries/Footprints/SparkFun-3D-models/Capacitor/C_0805_2012Metric.step

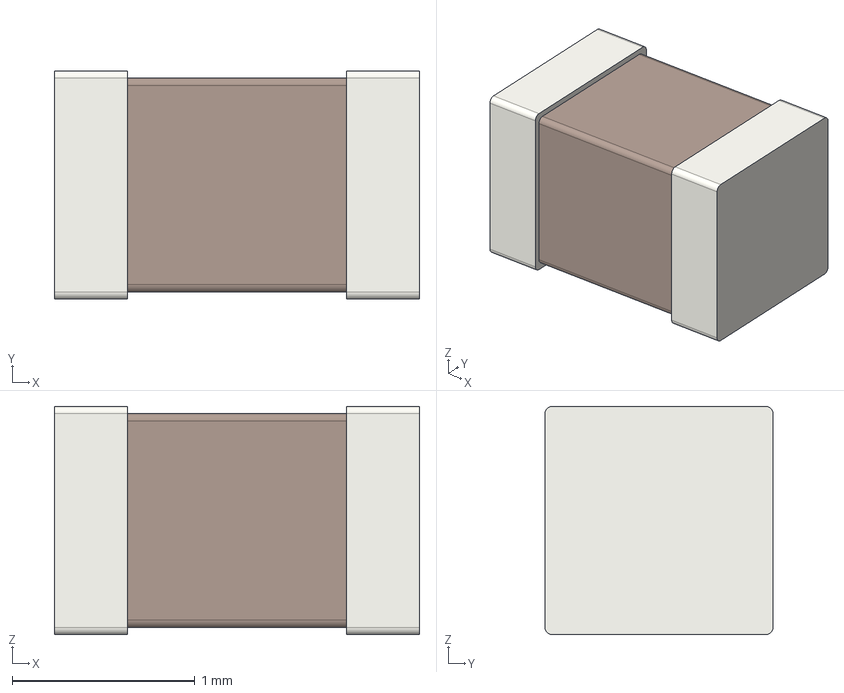
[picture p120: CAD file, 2025-03-07]
SYM/SparkFun-KiCad-Libraries/Footprints/SparkFun-3D-models/Capacitor/C_0805_2012Metric.step
2.00 x 1.25 x 1.25 mm
