Duy-Thanh/DroneShipping/SYM/SparkFun-KiCad-Libraries/Footprints/SparkFun-3D-models/Clock/Crystal_SMD_2.0x1.6mm.STEP

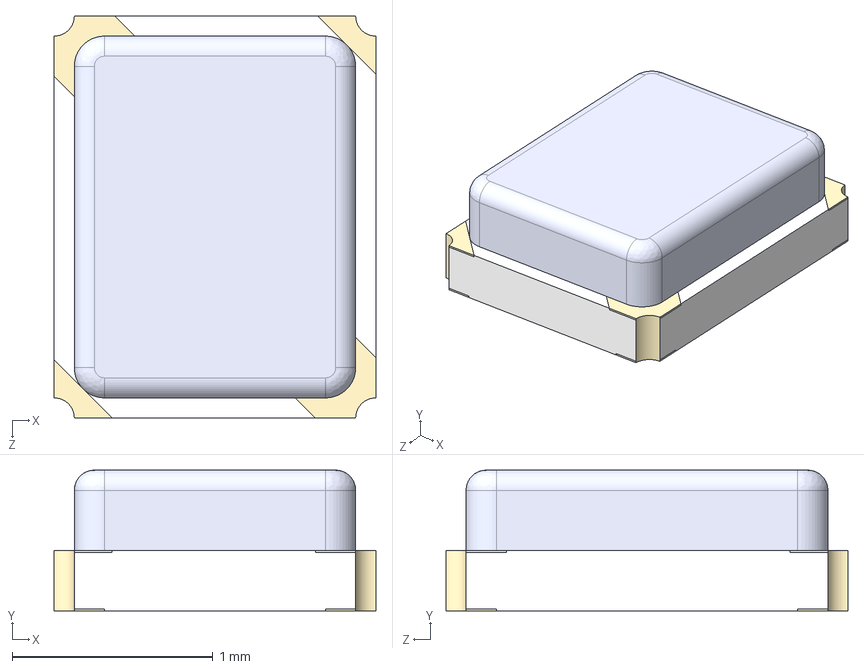
[picture p121: CAD file, 2025-03-07]
SYM/SparkFun-KiCad-Libraries/Footprints/SparkFun-3D-models/Clock/Crystal_SMD_2.0x1.6mm.STEP
1.60 x 0.7 x 2.00 mm
