Duy-Thanh/DroneShipping/SYM/SparkFun-KiCad-Libraries/Footprints/SparkFun-3D-models/Connector/2x10_2.0mm_Socket_SMD_Peg-1.1x0.8mm.stp

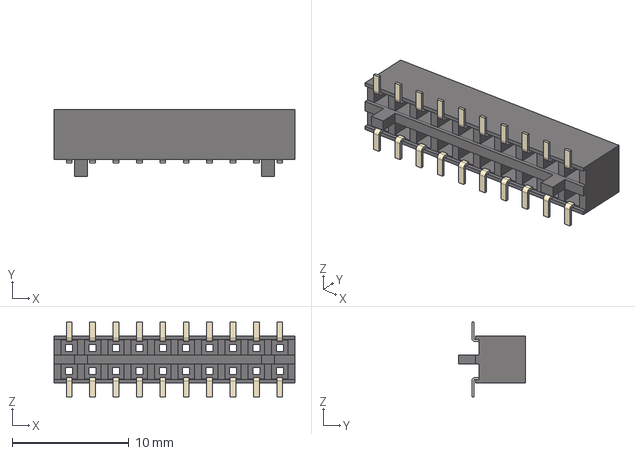
[picture p122: CAD file, 2025-03-07]
SYM/SparkFun-KiCad-Libraries/Footprints/SparkFun-3D-models/Connector/2x10_2.0mm_Socket_SMD_Peg-1.1x0.8mm.stp
20.6 x 5.75 x 6.40 mm
PIN x 20
