Duy-Thanh/DroneShipping/SYM/SparkFun-KiCad-Libraries/Footprints/SparkFun-3D-models/Electromechanical/Relay_7.5x12.5mm.step

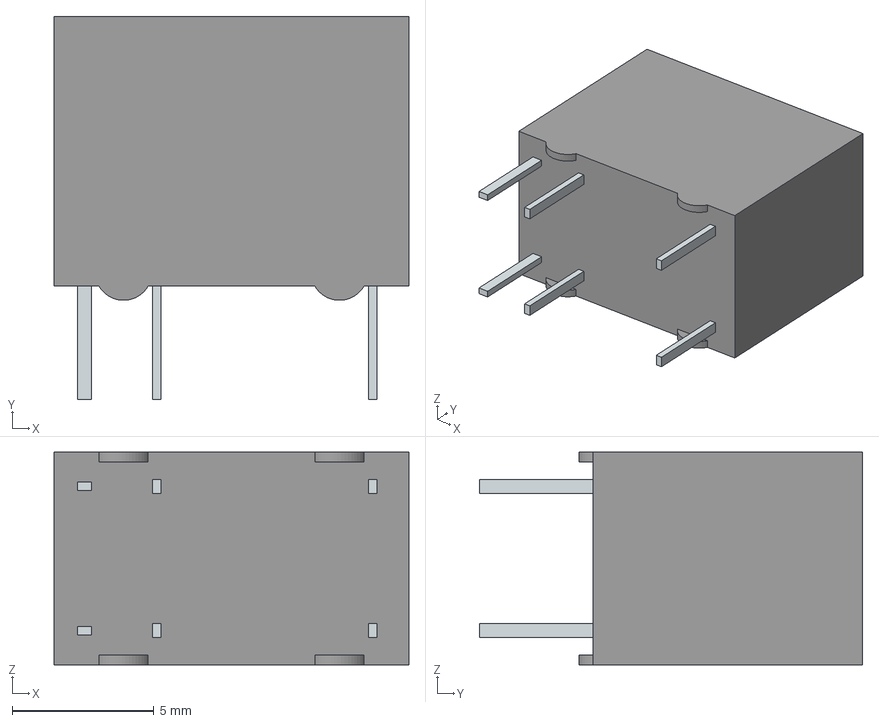
[picture p123: CAD file, 2025-03-07]
SYM/SparkFun-KiCad-Libraries/Footprints/SparkFun-3D-models/Electromechanical/Relay_7.5x12.5mm.step
12.5 x 13.5 x 7.50 mm
