Duy-Thanh/DroneShipping/SYM/SparkFun-KiCad-Libraries/Footprints/SparkFun-3D-models/GPS/UM980.stp

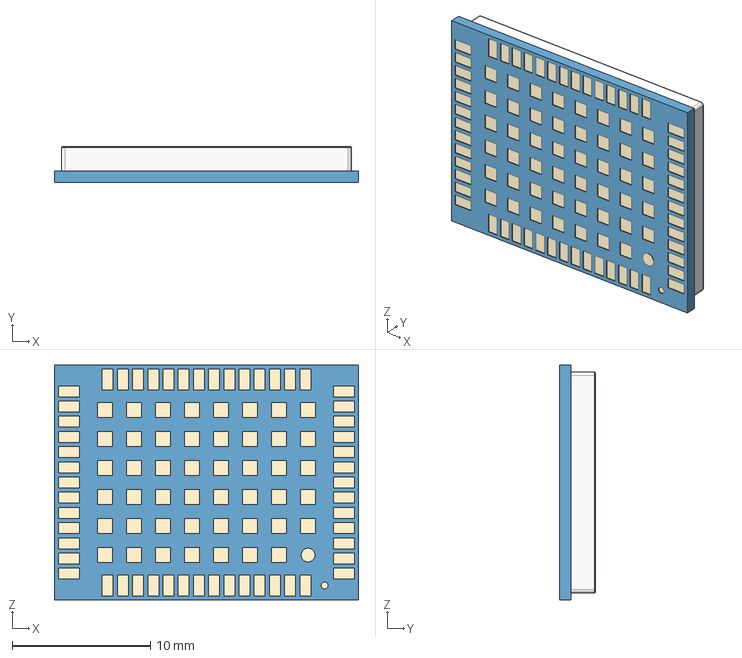
[picture p124: CAD file, 2025-03-07]
SYM/SparkFun-KiCad-Libraries/Footprints/SparkFun-3D-models/GPS/UM980.stp
22.0 x 2.62 x 17.0 mm
