Duy-Thanh/DroneShipping/SYM/SparkFun-KiCad-Libraries/Footprints/SparkFun-3D-models/Resistor/R_0201_0603Metric.step

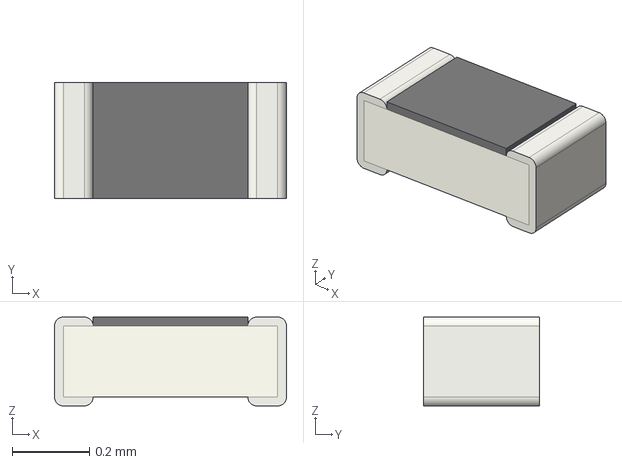
[picture p125: CAD file, 2025-03-07]
SYM/SparkFun-KiCad-Libraries/Footprints/SparkFun-3D-models/Resistor/R_0201_0603Metric.step
0.6 x 0.3 x 0.23 mm
