Duy-Thanh/DroneShipping/SYM/SparkFun-KiCad-Libraries/Footprints/SparkFun-3D-models/RF/ESP32-S3-WROOM-1.step

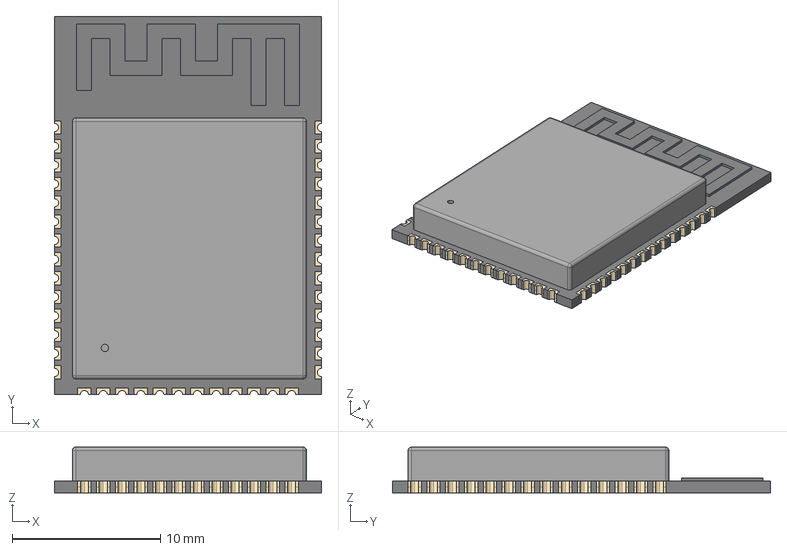
[picture p126: CAD file, 2025-03-07]
SYM/SparkFun-KiCad-Libraries/Footprints/SparkFun-3D-models/RF/ESP32-S3-WROOM-1.step
18.0 x 25.5 x 3.10 mm
