Duy-Thanh/DroneShipping/SYM/SparkFun-KiCad-Libraries/Footprints/SparkFun-3D-models/Switch/Slide_SPDT_PTH_11.6x4.0mm.step

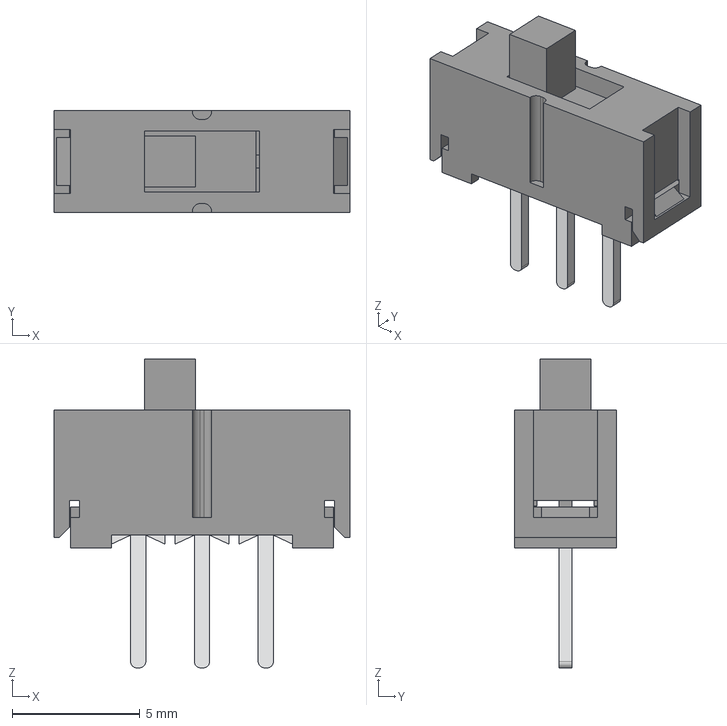
[picture p128: CAD file, 2025-03-07]
SYM/SparkFun-KiCad-Libraries/Footprints/SparkFun-3D-models/Switch/Slide_SPDT_PTH_11.6x4.0mm.step
11.6 x 4.00 x 12.1 mm
