Duy-Thanh/DroneShipping/SYM/SparkFun-KiCad-Libraries/Footprints/SparkFun-3D-models/Capacitor/CP_Elec_6.3x7.7.step

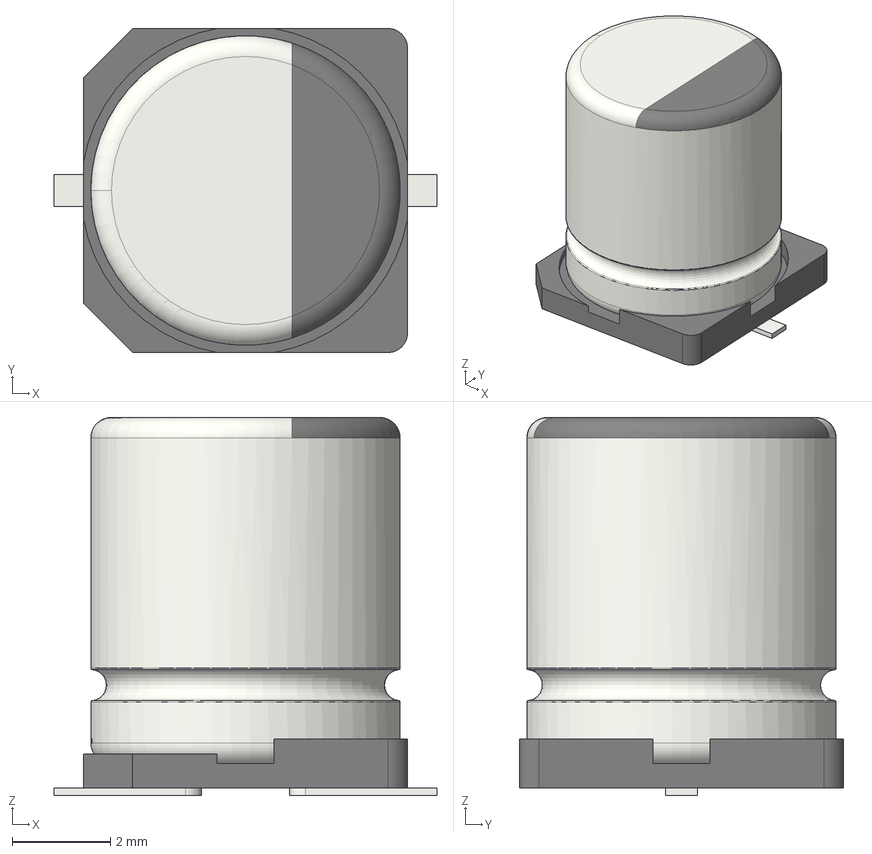
[picture p129: CAD file, 2025-03-07]
SYM/SparkFun-KiCad-Libraries/Footprints/SparkFun-3D-models/Capacitor/CP_Elec_6.3x7.7.step
7.80 x 6.60 x 7.70 mm
