Duy-Thanh/DroneShipping/SYM/SparkFun-KiCad-Libraries/Footprints/SparkFun-3D-models/Clock/STP3593_PTH_52x42mm.stp

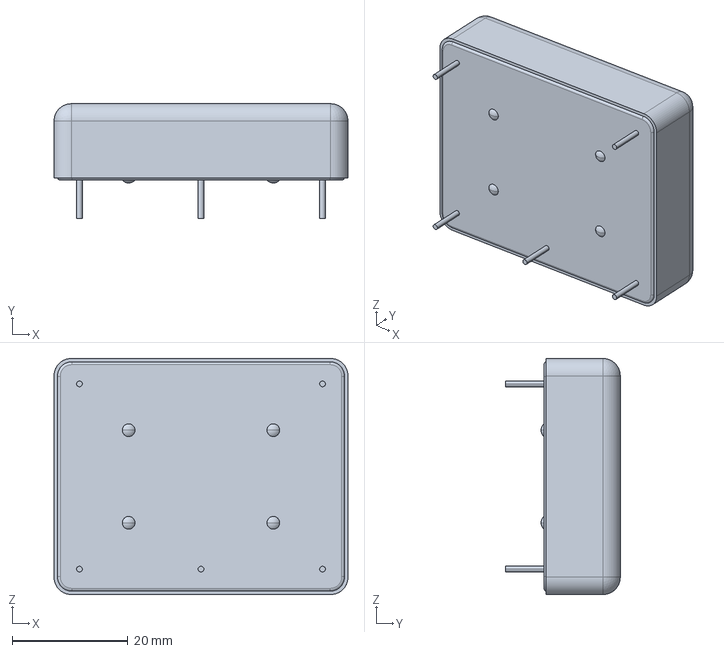
[picture p130: CAD file, 2025-03-07]
SYM/SparkFun-KiCad-Libraries/Footprints/SparkFun-3D-models/Clock/STP3593_PTH_52x42mm.stp
50.8 x 19.8 x 40.8 mm
