Duy-Thanh/DroneShipping/SYM/SparkFun-KiCad-Libraries/Footprints/SparkFun-3D-models/Connector/1x07_2.0mm.step

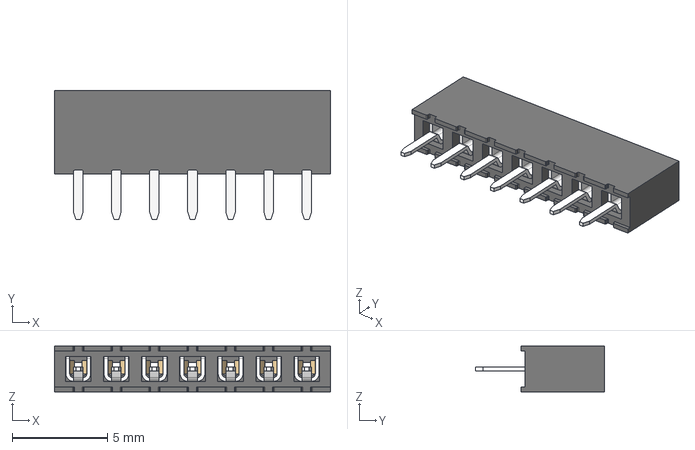
[picture p131: CAD file, 2025-03-07]
SYM/SparkFun-KiCad-Libraries/Footprints/SparkFun-3D-models/Connector/1x07_2.0mm.step
14.5 x 6.80 x 2.40 mm
M22-713_CONTACT x 7
M22-71310_MOULD
