Duy-Thanh/DroneShipping/SYM/SparkFun-KiCad-Libraries/Footprints/SparkFun-3D-models/Electromechanical/Relay_15.2x19.0mm.step

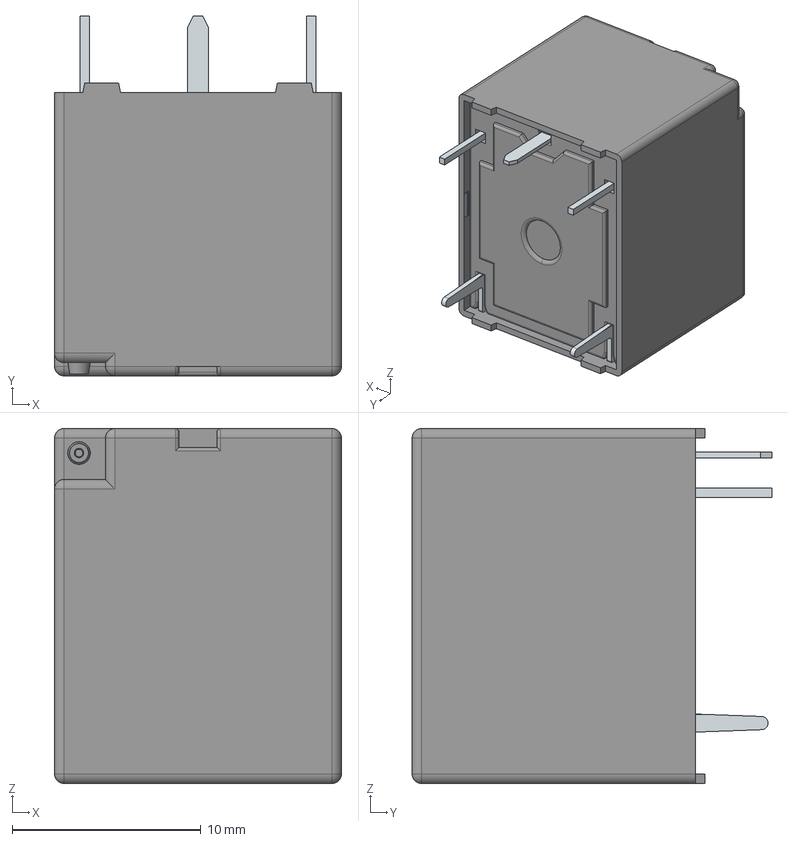
[picture p132: CAD file, 2025-03-07]
SYM/SparkFun-KiCad-Libraries/Footprints/SparkFun-3D-models/Electromechanical/Relay_15.2x19.0mm.step
15.2 x 19.1 x 18.8 mm
