Duy-Thanh/DroneShipping/SYM/SparkFun-KiCad-Libraries/Footprints/SparkFun-3D-models/LED/CBI_LED_Triple_3mm_PTH.step

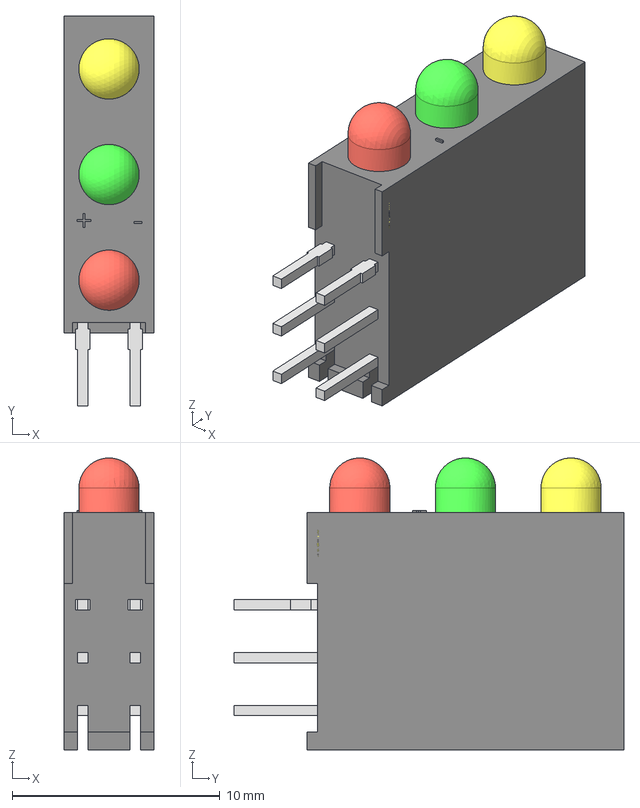
[picture p133: CAD file, 2025-03-07]
SYM/SparkFun-KiCad-Libraries/Footprints/SparkFun-3D-models/LED/CBI_LED_Triple_3mm_PTH.step
4.32 x 18.7 x 14.0 mm
