Duy-Thanh/DroneShipping/SYM/SparkFun-KiCad-Libraries/Footprints/SparkFun-3D-models/Semiconductor-Standard/QFN-16-1EP_3x3mm_P0.5mm_EP1.8x1.8mm.step

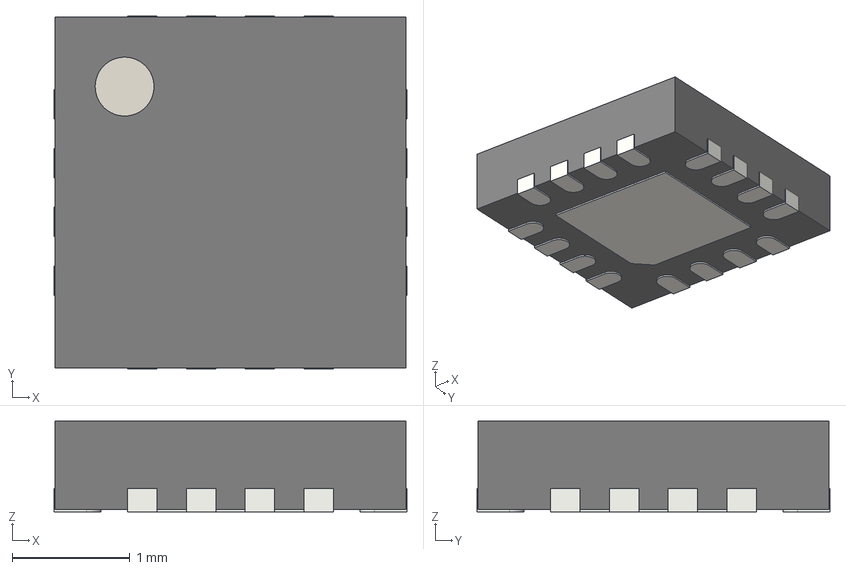
[picture p135: CAD file, 2025-03-07]
SYM/SparkFun-KiCad-Libraries/Footprints/SparkFun-3D-models/Semiconductor-Standard/QFN-16-1EP_3x3mm_P0.5mm_EP1.8x1.8mm.step
3.00 x 3.00 x 0.77 mm
