Duy-Thanh/DroneShipping/SYM/SparkFun-KiCad-Libraries/Footprints/SparkFun-3D-models/Electromechanical/Relay_15.2x19.0mm_2.step

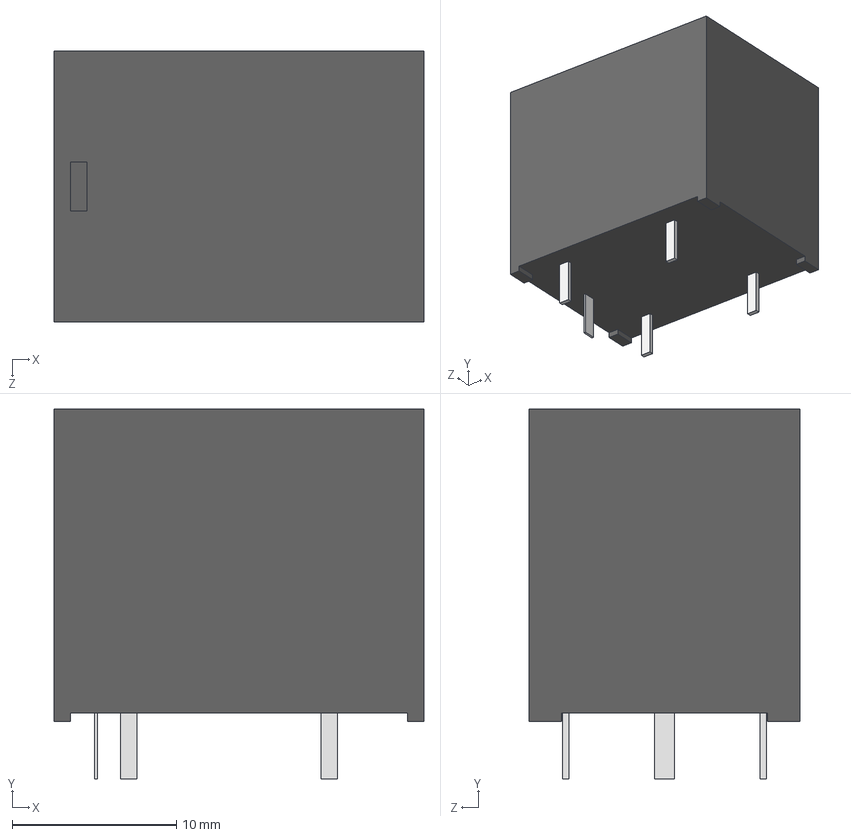
[picture p138: CAD file, 2025-03-07]
SYM/SparkFun-KiCad-Libraries/Footprints/SparkFun-3D-models/Electromechanical/Relay_15.2x19.0mm_2.step
22.5 x 22.5 x 16.5 mm
