Duy-Thanh/DroneShipping/SYM/SparkFun-KiCad-Libraries/Footprints/SparkFun-3D-models/Resistor/Trimpot_SMD_3.0x3.0mm.step

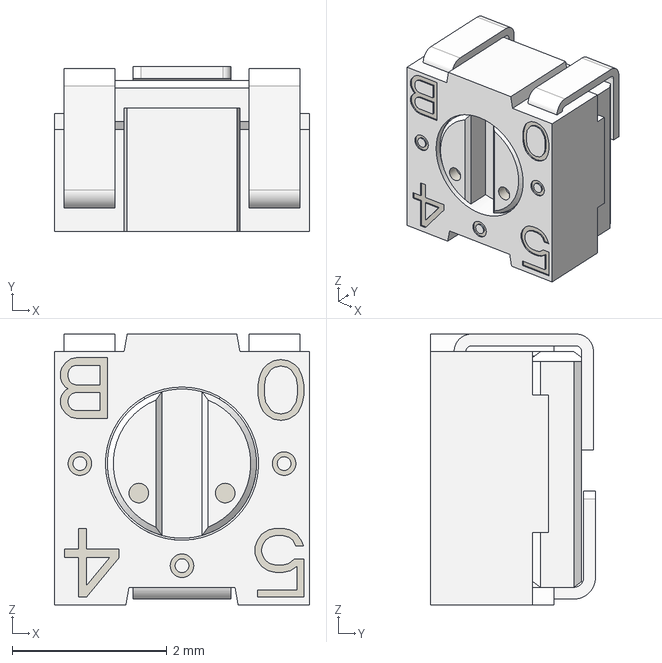
[picture p139: CAD file, 2025-03-07]
SYM/SparkFun-KiCad-Libraries/Footprints/SparkFun-3D-models/Resistor/Trimpot_SMD_3.0x3.0mm.step
3.30 x 2.13 x 3.51 mm
