Duy-Thanh/DroneShipping/SYM/SparkFun-KiCad-Libraries/Footprints/SparkFun-3D-models/Switch/Tactal Switch - SMD (12mmx12mmx8.5mm).step

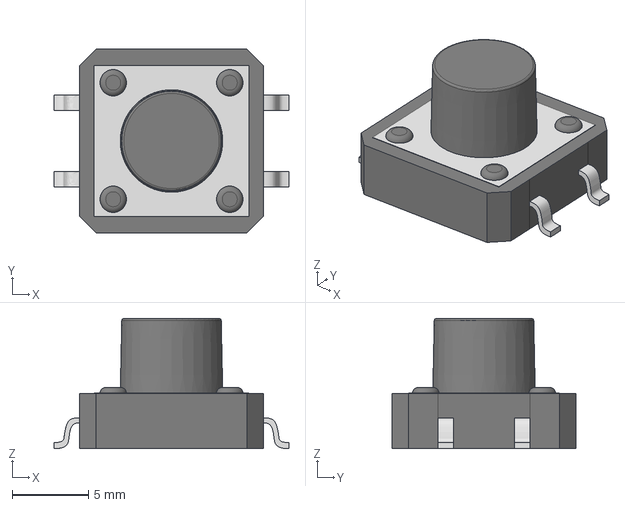
[picture p141: CAD file, 2025-03-07]
SYM/SparkFun-KiCad-Libraries/Footprints/SparkFun-3D-models/Switch/Tactal Switch - SMD (12mmx12mmx8.5mm).step
15.4 x 12.0 x 8.50 mm
