Duy-Thanh/DroneShipping/SYM/SparkFun-KiCad-Libraries/Footprints/SparkFun-3D-models/Capacitor/CP_EIA-3528-21_Kemet-B.step

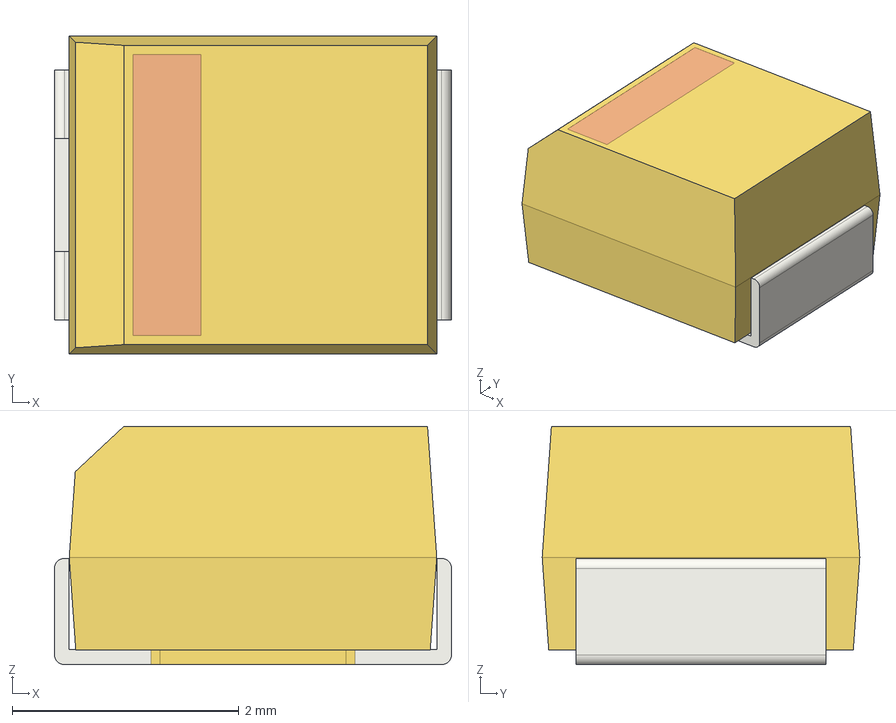
[picture p142: CAD file, 2025-03-07]
SYM/SparkFun-KiCad-Libraries/Footprints/SparkFun-3D-models/Capacitor/CP_EIA-3528-21_Kemet-B.step
3.50 x 2.80 x 2.10 mm
