Duy-Thanh/DroneShipping/SYM/SparkFun-KiCad-Libraries/Footprints/SparkFun-3D-models/LED/WS2812-2020.STEP

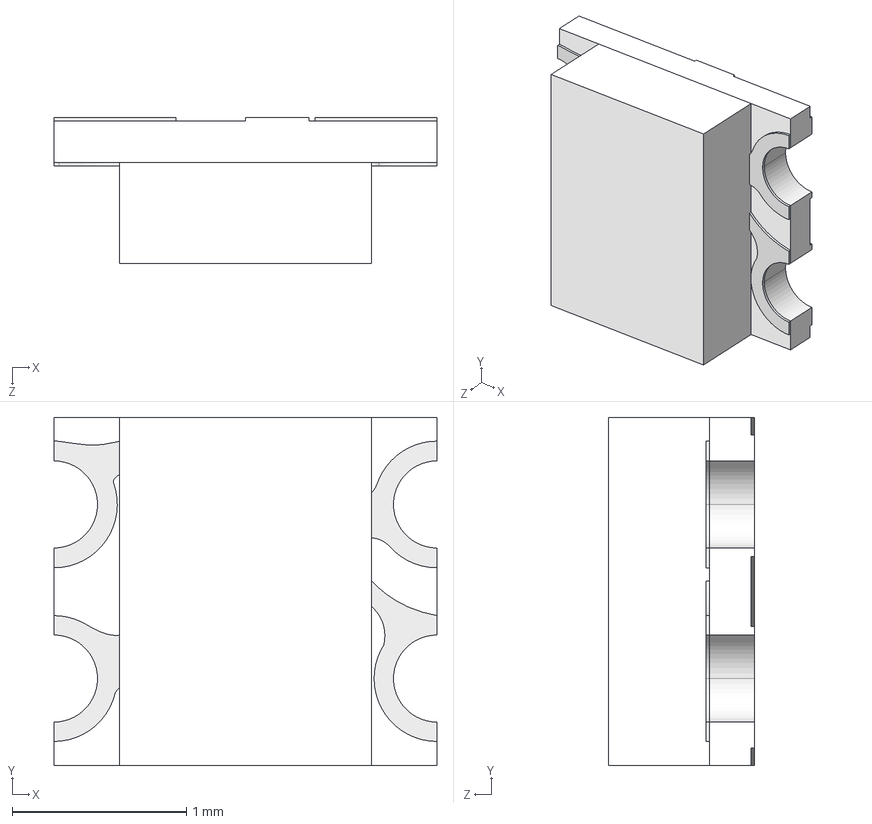
[picture p144: CAD file, 2025-03-07]
SYM/SparkFun-KiCad-Libraries/Footprints/SparkFun-3D-models/LED/WS2812-2020.STEP
2.20 x 2.00 x 0.84 mm
