Duy-Thanh/DroneShipping/SYM/SparkFun-KiCad-Libraries/Footprints/SparkFun-3D-models/Semiconductor-Standard/SOT-353_SC-70-5.step

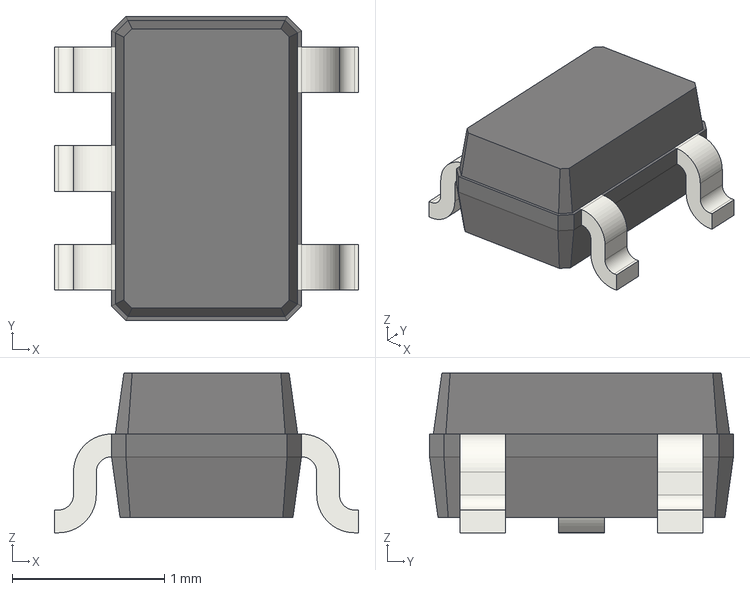
[picture p145: CAD file, 2025-03-07]
SYM/SparkFun-KiCad-Libraries/Footprints/SparkFun-3D-models/Semiconductor-Standard/SOT-353_SC-70-5.step
2.00 x 2.00 x 1.05 mm
