Duy-Thanh/DroneShipping/SYM/SparkFun-KiCad-Libraries/Footprints/SparkFun-3D-models/Switch/Navigation_SMD_9.9x9.9mm.step

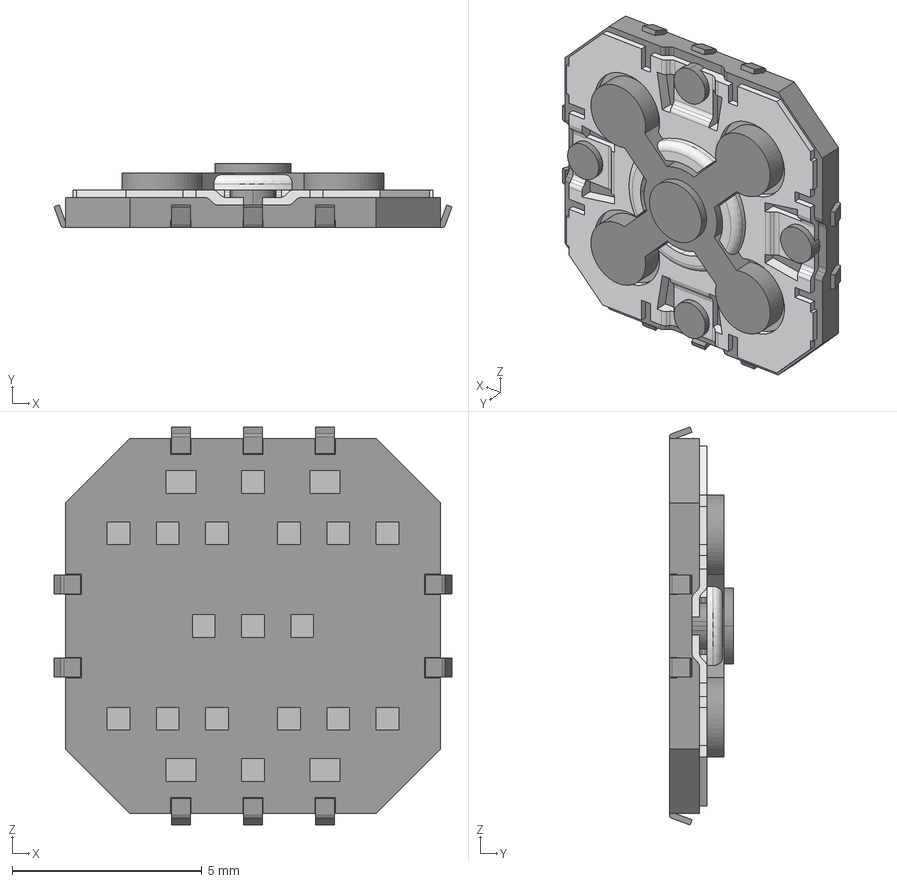
[picture p146: CAD file, 2025-03-07]
SYM/SparkFun-KiCad-Libraries/Footprints/SparkFun-3D-models/Switch/Navigation_SMD_9.9x9.9mm.step
10.5 x 1.70 x 10.5 mm
