Duy-Thanh/DroneShipping/SYM/SparkFun-KiCad-Libraries/Footprints/SparkFun-3D-models/Connector/JST_SMD_1.0mm-9.STEP

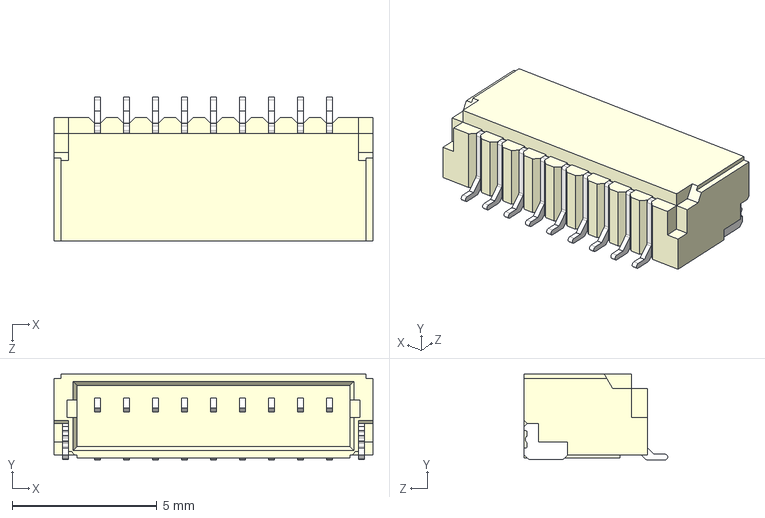
[picture p147: CAD file, 2025-03-07]
SYM/SparkFun-KiCad-Libraries/Footprints/SparkFun-3D-models/Connector/JST_SMD_1.0mm-9.STEP
11.0 x 2.96 x 4.95 mm
