Duy-Thanh/DroneShipping/SYM/SparkFun-KiCad-Libraries/Footprints/SparkFun-3D-models/LED/SparkFun_SMD_LED_Light_Pipe.step

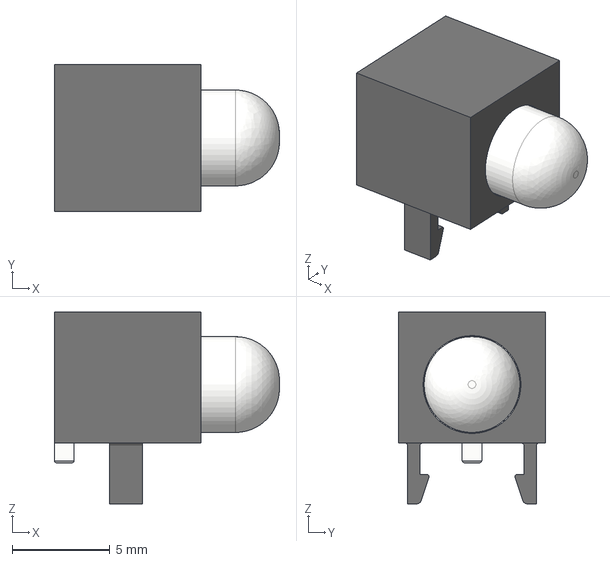
[picture p148: CAD file, 2025-03-07]
SYM/SparkFun-KiCad-Libraries/Footprints/SparkFun-3D-models/LED/SparkFun_SMD_LED_Light_Pipe.step
11.5 x 7.50 x 9.80 mm
