Duy-Thanh/DroneShipping/SYM/SparkFun-KiCad-Libraries/Footprints/SparkFun-3D-models/Switch/Push_SMD_4.2x3.2mm_h2.5mm.step

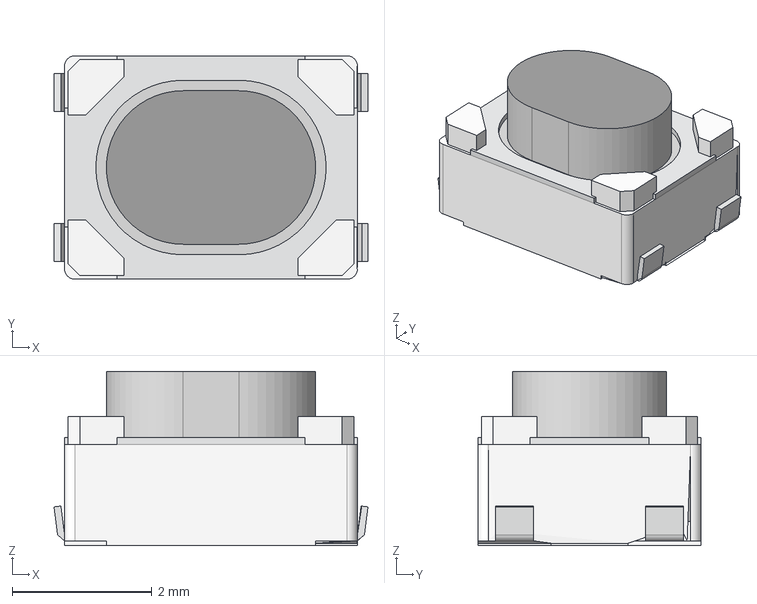
[picture p150: CAD file, 2025-03-07]
SYM/SparkFun-KiCad-Libraries/Footprints/SparkFun-3D-models/Switch/Push_SMD_4.2x3.2mm_h2.5mm.step
4.50 x 3.20 x 2.50 mm
