Duy-Thanh/DroneShipping/SYM/SparkFun-KiCad-Libraries/Footprints/SparkFun-3D-models/Connector/IDC-Header_2x05_P2.54mm_Vertical_SMD.step

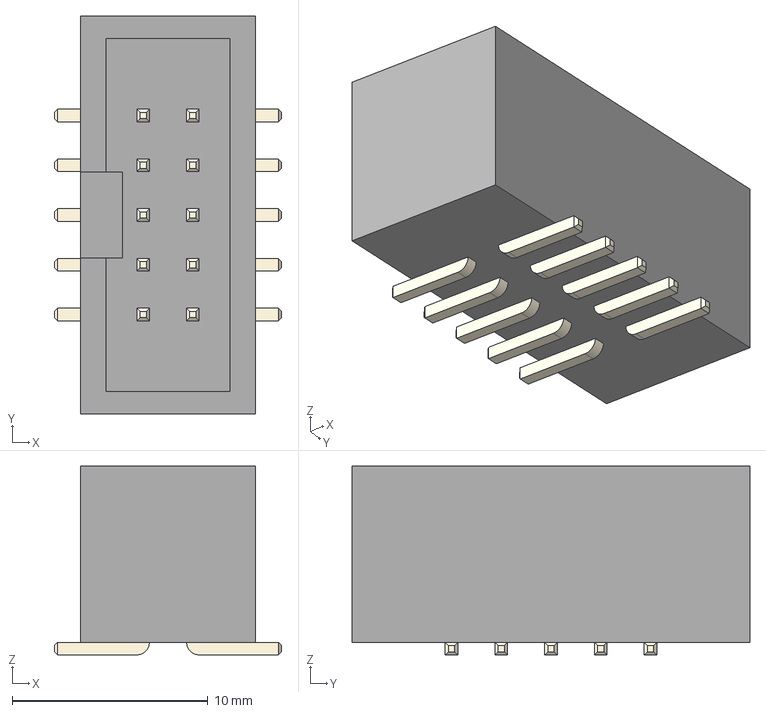
[picture p151: CAD file, 2025-03-07]
SYM/SparkFun-KiCad-Libraries/Footprints/SparkFun-3D-models/Connector/IDC-Header_2x05_P2.54mm_Vertical_SMD.step
11.6 x 20.3 x 9.64 mm
