Duy-Thanh/DroneShipping/SYM/SparkFun-KiCad-Libraries/Footprints/SparkFun-3D-models/Semiconductor-Standard/DFN-8-1EP_2x2mm_P0.5mm_EP1.05x1.75mm.step

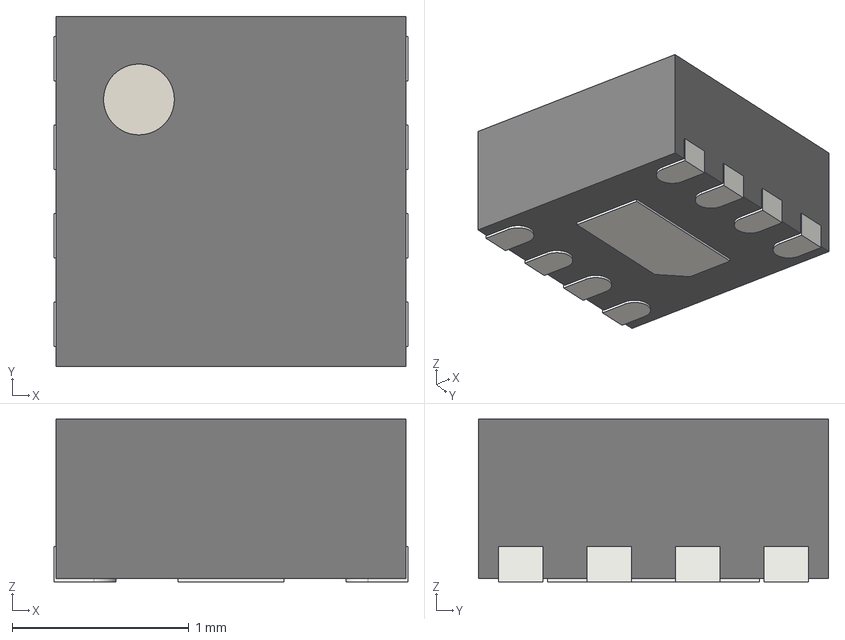
[picture p152: CAD file, 2025-03-07]
SYM/SparkFun-KiCad-Libraries/Footprints/SparkFun-3D-models/Semiconductor-Standard/DFN-8-1EP_2x2mm_P0.5mm_EP1.05x1.75mm.step
2.00 x 1.98 x 0.92 mm
