Duy-Thanh/DroneShipping/SYM/SparkFun-KiCad-Libraries/Footprints/SparkFun-3D-models/Switch/Tactile_Switch_5.2x5.2mm_h1.9mm.STEP

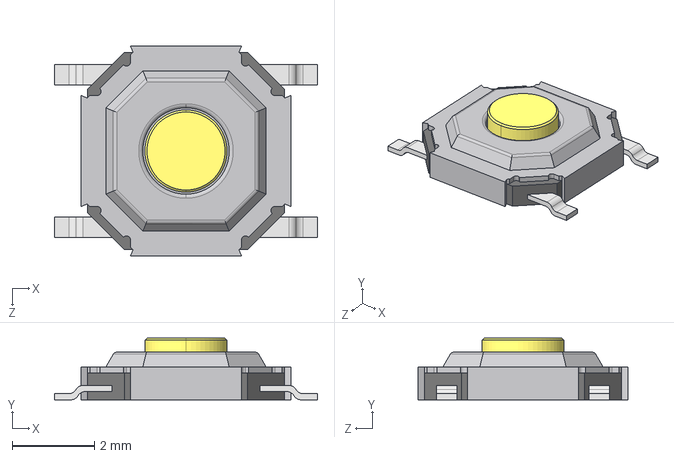
[picture p153: CAD file, 2025-03-07]
SYM/SparkFun-KiCad-Libraries/Footprints/SparkFun-3D-models/Switch/Tactile_Switch_5.2x5.2mm_h1.9mm.STEP
6.40 x 1.50 x 5.10 mm
