Duy-Thanh/DroneShipping/SYM/SparkFun-KiCad-Libraries/Footprints/SparkFun-3D-models/Connector/JST_SMD_1.0mm-6_Vertical.STEP

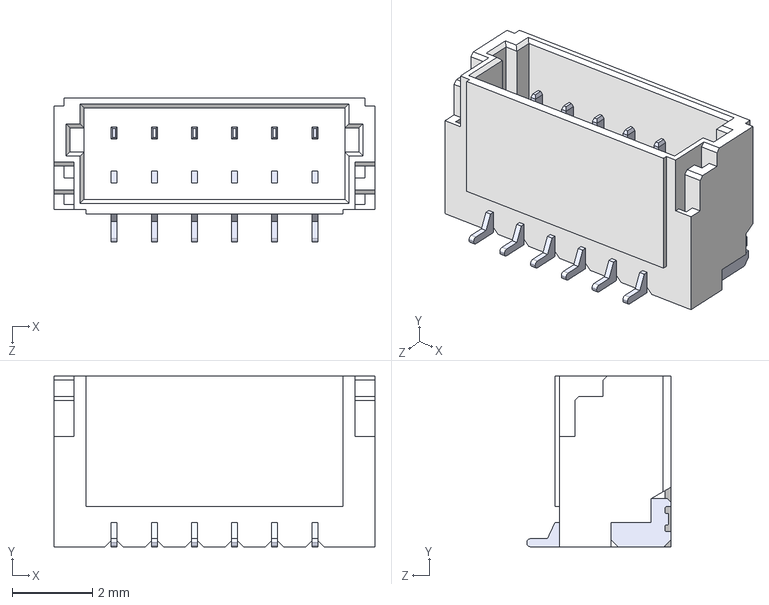
[picture p154: CAD file, 2025-03-07]
SYM/SparkFun-KiCad-Libraries/Footprints/SparkFun-3D-models/Connector/JST_SMD_1.0mm-6_Vertical.STEP
8.00 x 4.25 x 3.60 mm
