Duy-Thanh/DroneShipping/SYM/SparkFun-KiCad-Libraries/Footprints/SparkFun-3D-models/Switch/SW_Tactile_SPST_Angled_PTS645Vx39-2LFS.step

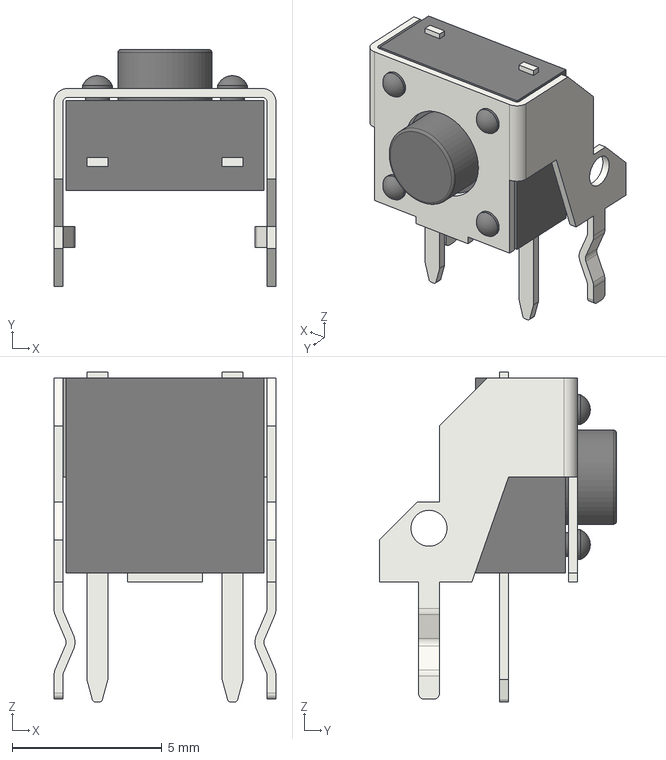
[picture p156: CAD file, 2025-03-07]
SYM/SparkFun-KiCad-Libraries/Footprints/SparkFun-3D-models/Switch/SW_Tactile_SPST_Angled_PTS645Vx39-2LFS.step
7.40 x 7.90 x 11.0 mm
