Duy-Thanh/DroneShipping/SYM/SparkFun-KiCad-Libraries/Footprints/SparkFun-3D-models/Semiconductor-Standard/PCBA-10_9x7mm.stp

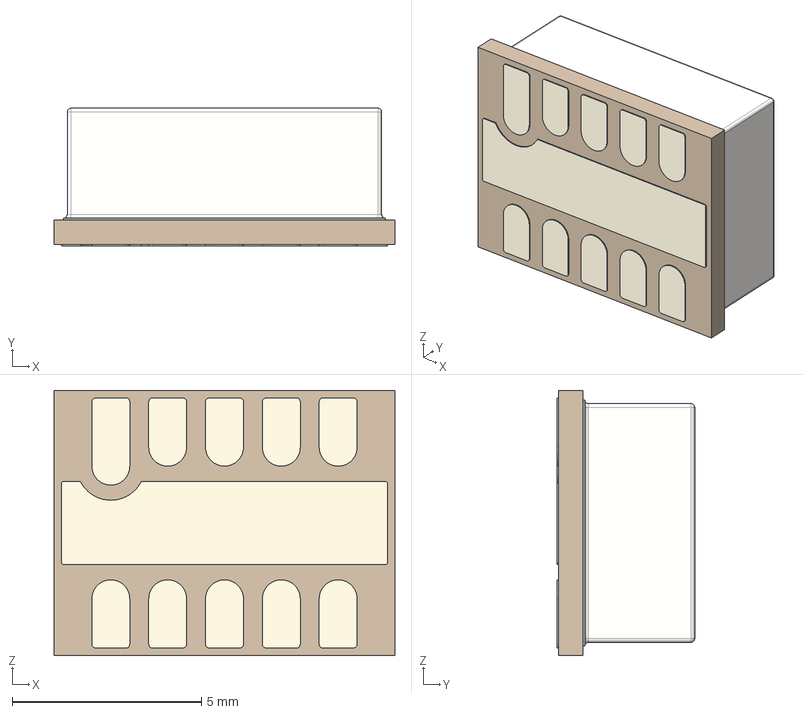
[picture p158: CAD file, 2025-03-07]
SYM/SparkFun-KiCad-Libraries/Footprints/SparkFun-3D-models/Semiconductor-Standard/PCBA-10_9x7mm.stp
9.00 x 3.63 x 7.00 mm
