Duy-Thanh/DroneShipping/SYM/SparkFun-KiCad-Libraries/Footprints/SparkFun-3D-models/Switch/SW_SP3T_PCM13.step

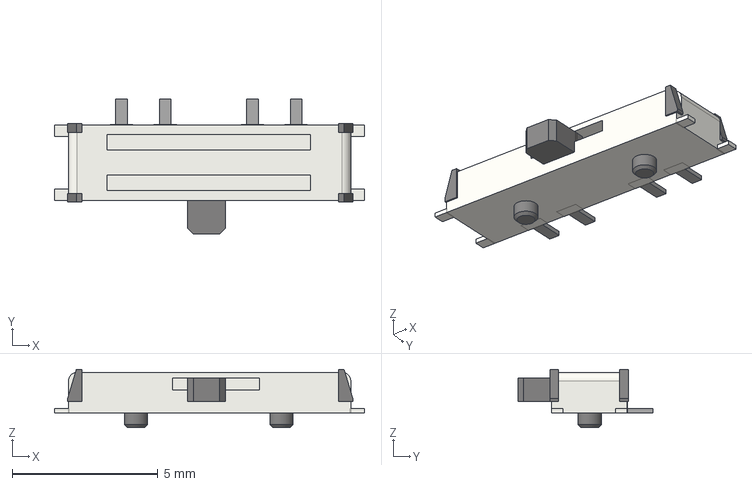
[picture p159: CAD file, 2025-03-07]
SYM/SparkFun-KiCad-Libraries/Footprints/SparkFun-3D-models/Switch/SW_SP3T_PCM13.step
10.6 x 4.65 x 2.00 mm
