Duy-Thanh/DroneShipping/SYM/SparkFun-KiCad-Libraries/Footprints/SparkFun-3D-models/Connector/1x08_SMD_Pin1RightDown.step

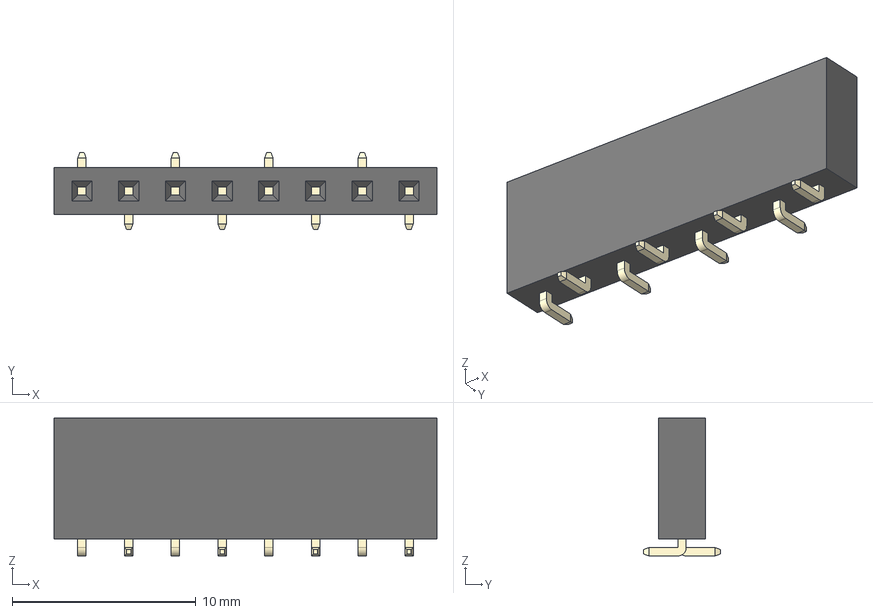
[picture p160: CAD file, 2025-03-07]
SYM/SparkFun-KiCad-Libraries/Footprints/SparkFun-3D-models/Connector/1x08_SMD_Pin1RightDown.step
20.8 x 4.20 x 7.50 mm
