Duy-Thanh/DroneShipping/SYM/SparkFun-KiCad-Libraries/Footprints/SparkFun-3D-models/LED/APA102-2020.step

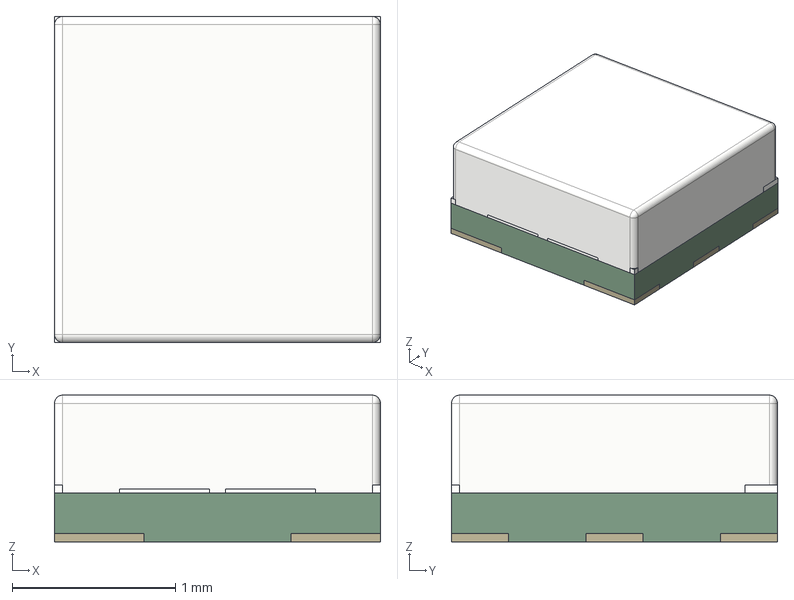
[picture p161: CAD file, 2025-03-07]
SYM/SparkFun-KiCad-Libraries/Footprints/SparkFun-3D-models/LED/APA102-2020.step
2.00 x 2.00 x 0.9 mm
PCB
POXY
UNMASKED PCB
PADS
DIE PADS
DIE PADS2
DIE RIM
DIE
DIODES
BOND WIRES
