Duy-Thanh/DroneShipping/SYM/SparkFun-KiCad-Libraries/Footprints/SparkFun-3D-models/Semiconductor-Standard/SO-16_3.9x9.9mm_P1.27mm.step

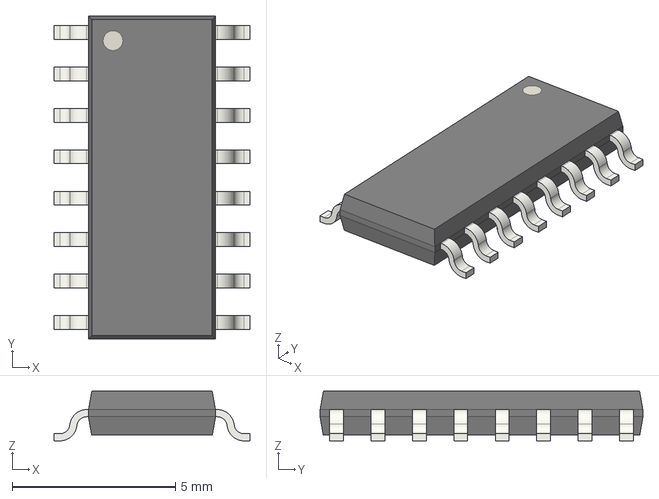
[picture p162: CAD file, 2025-03-07]
SYM/SparkFun-KiCad-Libraries/Footprints/SparkFun-3D-models/Semiconductor-Standard/SO-16_3.9x9.9mm_P1.27mm.step
6.00 x 9.90 x 1.52 mm
