Duy-Thanh/DroneShipping/SYM/SparkFun-KiCad-Libraries/Footprints/SparkFun-3D-models/Switch/Slide_DPDT_SMD_9.0x3.6mm.step

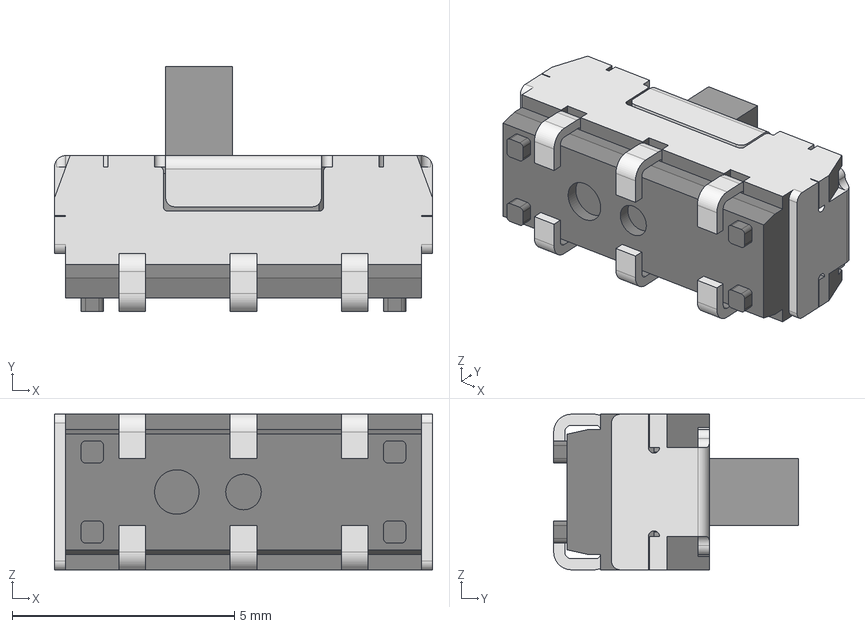
[picture p163: CAD file, 2025-03-07]
SYM/SparkFun-KiCad-Libraries/Footprints/SparkFun-3D-models/Switch/Slide_DPDT_SMD_9.0x3.6mm.step
8.50 x 5.50 x 3.50 mm
2Top setting_s
22A-01_c
