Duy-Thanh/DroneShipping/SYM/SparkFun-KiCad-Libraries/Footprints/SparkFun-3D-models/Semiconductor-Standard/QFN-80-1EP_10x10mm_P0.4mm_EP3.4x3.4mm.step

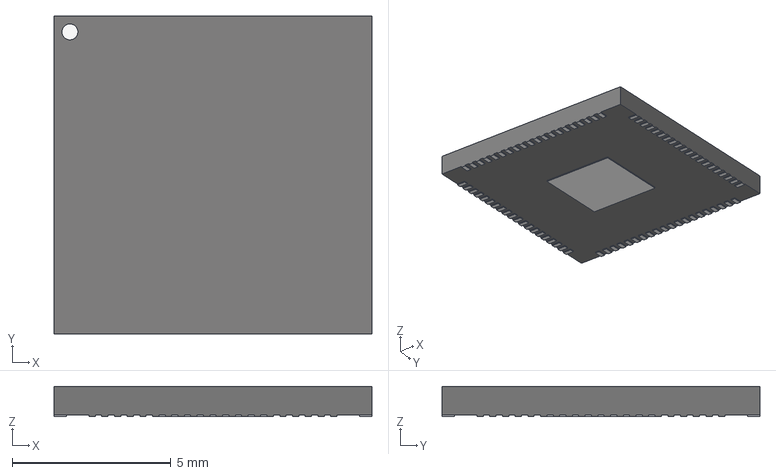
[picture p165: CAD file, 2025-03-07]
SYM/SparkFun-KiCad-Libraries/Footprints/SparkFun-3D-models/Semiconductor-Standard/QFN-80-1EP_10x10mm_P0.4mm_EP3.4x3.4mm.step
10.0 x 10.0 x 0.95 mm
