Duy-Thanh/DroneShipping/SYM/SparkFun-KiCad-Libraries/Footprints/SparkFun-3D-models/Switch/Push_SMD_4.6x2.8mm.step

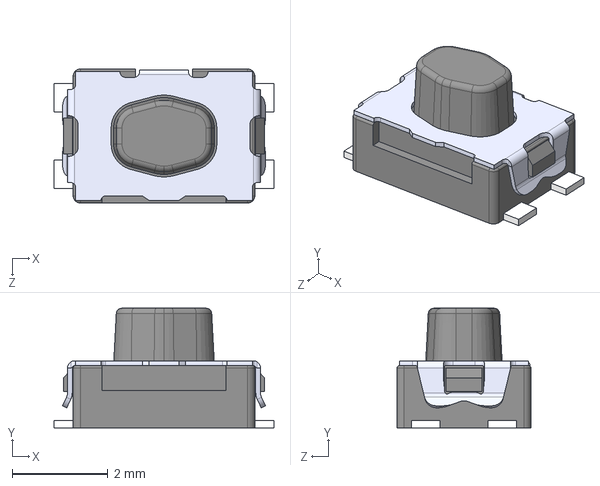
[picture p166: CAD file, 2025-03-07]
SYM/SparkFun-KiCad-Libraries/Footprints/SparkFun-3D-models/Switch/Push_SMD_4.6x2.8mm.step
4.60 x 2.50 x 2.80 mm
