Duy-Thanh/DroneShipping/SYM/SparkFun-KiCad-Libraries/Footprints/SparkFun-3D-models/Connector/JST_SM12B-SRSS-TB.step

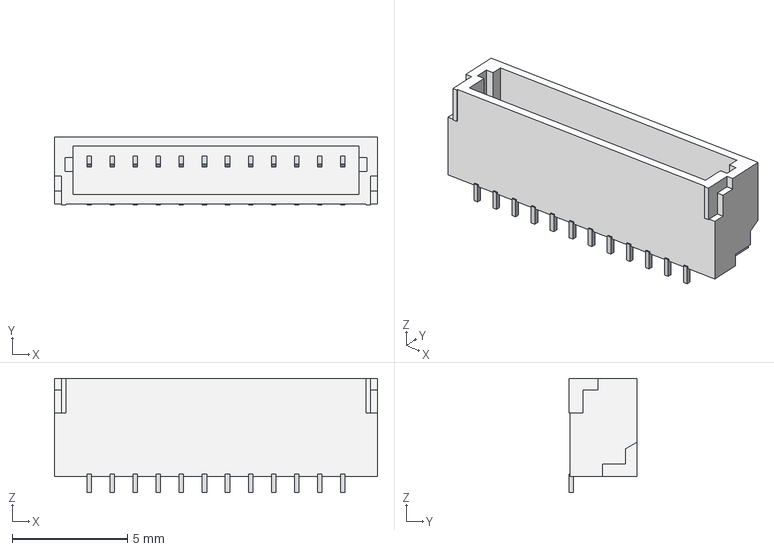
[picture p167: CAD file, 2025-03-07]
SYM/SparkFun-KiCad-Libraries/Footprints/SparkFun-3D-models/Connector/JST_SM12B-SRSS-TB.step
14.0 x 2.96 x 4.95 mm
