Duy-Thanh/DroneShipping/SYM/SparkFun-KiCad-Libraries/Footprints/SparkFun-3D-models/LED/APA104-1010.stp

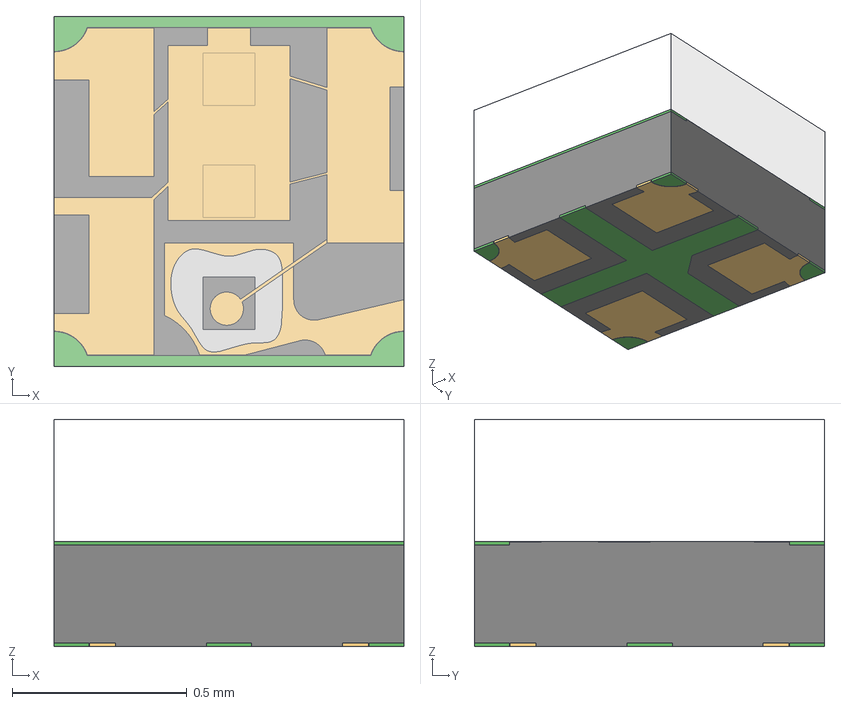
[picture p168: CAD file, 2025-03-07]
SYM/SparkFun-KiCad-Libraries/Footprints/SparkFun-3D-models/LED/APA104-1010.stp
1.00 x 1.00 x 0.65 mm
Pins
Resin
