Duy-Thanh/DroneShipping/SYM/SparkFun-KiCad-Libraries/Footprints/SparkFun-3D-models/Switch/Navigation_SMD_7.5x7.5mm.step

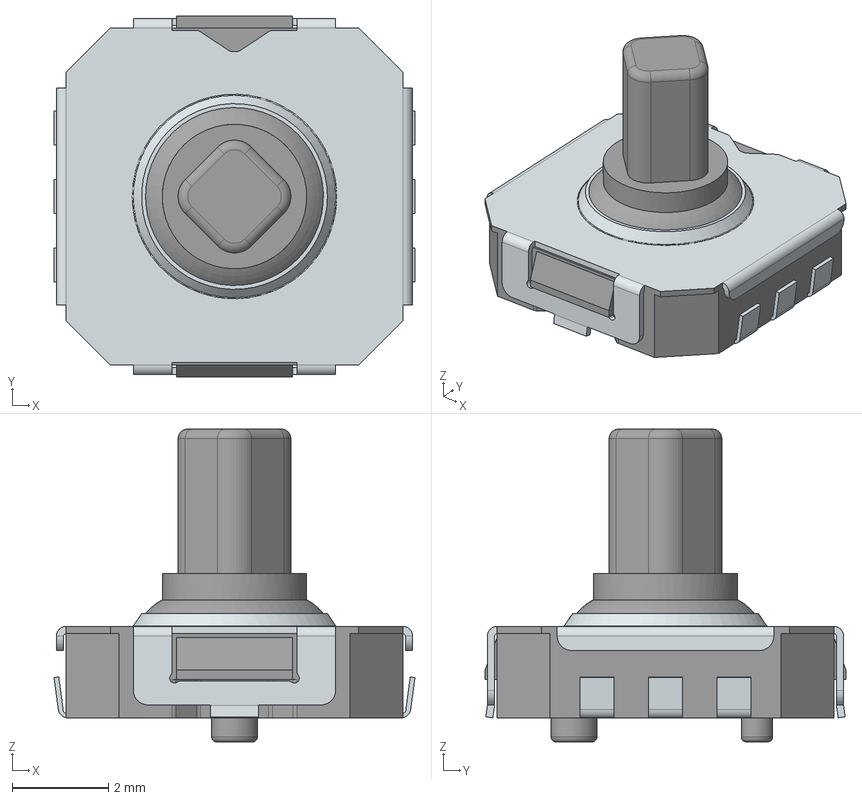
[picture p170: CAD file, 2025-03-07]
SYM/SparkFun-KiCad-Libraries/Footprints/SparkFun-3D-models/Switch/Navigation_SMD_7.5x7.5mm.step
7.50 x 7.50 x 6.50 mm
