Duy-Thanh/DroneShipping/SYM/SparkFun-KiCad-Libraries/Footprints/SparkFun-3D-models/Connector/FPC_0.5mm-24-BottomContact.step

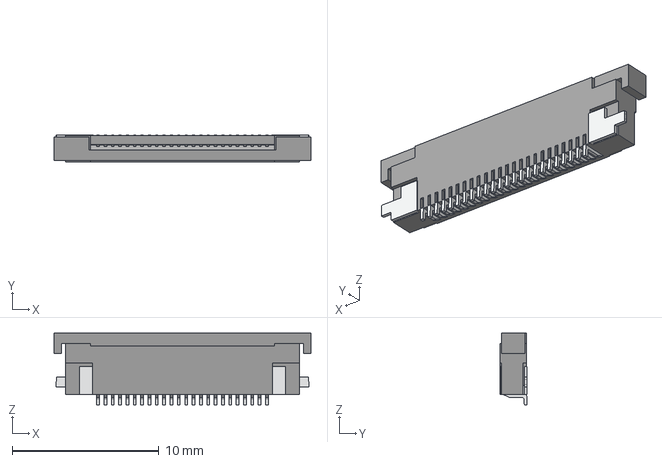
[picture p171: CAD file, 2025-03-07]
SYM/SparkFun-KiCad-Libraries/Footprints/SparkFun-3D-models/Connector/FPC_0.5mm-24-BottomContact.step
17.5 x 1.87 x 4.90 mm
