Duy-Thanh/DroneShipping/SYM/SparkFun-KiCad-Libraries/Footprints/SparkFun-3D-models/Semiconductor-Standard/SOT-583-3.stp

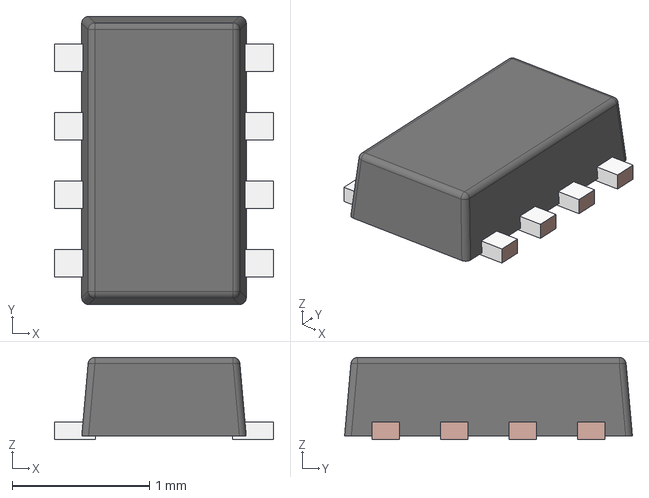
[picture p172: CAD file, 2025-03-07]
SYM/SparkFun-KiCad-Libraries/Footprints/SparkFun-3D-models/Semiconductor-Standard/SOT-583-3.stp
1.60 x 2.10 x 0.6 mm
FRAME-DRL0008A
BODY-SOT
