Duy-Thanh/DroneShipping/SYM/SparkFun-KiCad-Libraries/Footprints/SparkFun-3D-models/Switch/Slide_DPDT_SMD_7.2x3.5mm.step

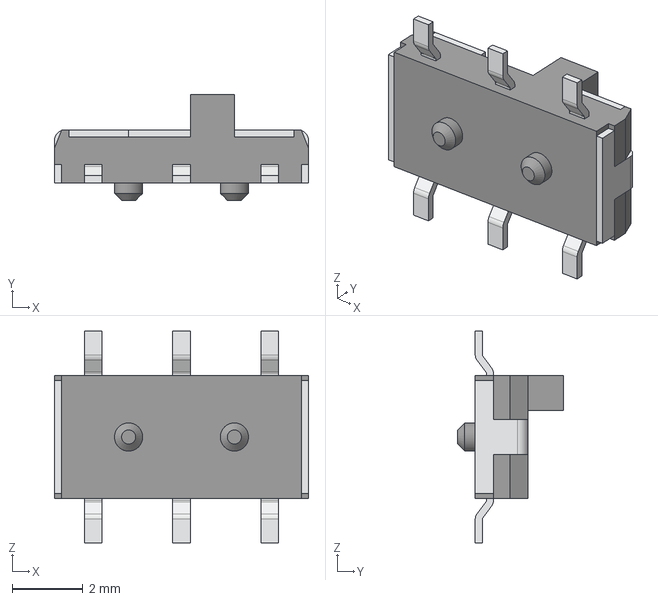
[picture p173: CAD file, 2025-03-07]
SYM/SparkFun-KiCad-Libraries/Footprints/SparkFun-3D-models/Switch/Slide_DPDT_SMD_7.2x3.5mm.step
7.20 x 3.00 x 6.00 mm
