Duy-Thanh/DroneShipping/SYM/SparkFun-KiCad-Libraries/Footprints/SparkFun-3D-models/Connector/Audio_Jack_3.5mm_TRRS_SMD_RA.step

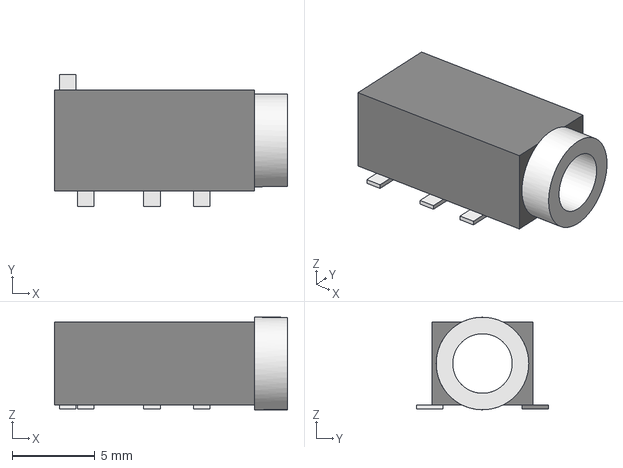
[picture p174: CAD file, 2025-03-07]
SYM/SparkFun-KiCad-Libraries/Footprints/SparkFun-3D-models/Connector/Audio_Jack_3.5mm_TRRS_SMD_RA.step
14.1 x 8.00 x 5.60 mm
