Duy-Thanh/DroneShipping/SYM/SparkFun-KiCad-Libraries/Footprints/SparkFun-3D-models/Semiconductor-Standard/DFN-8_3x3mm_P0.65mm.step

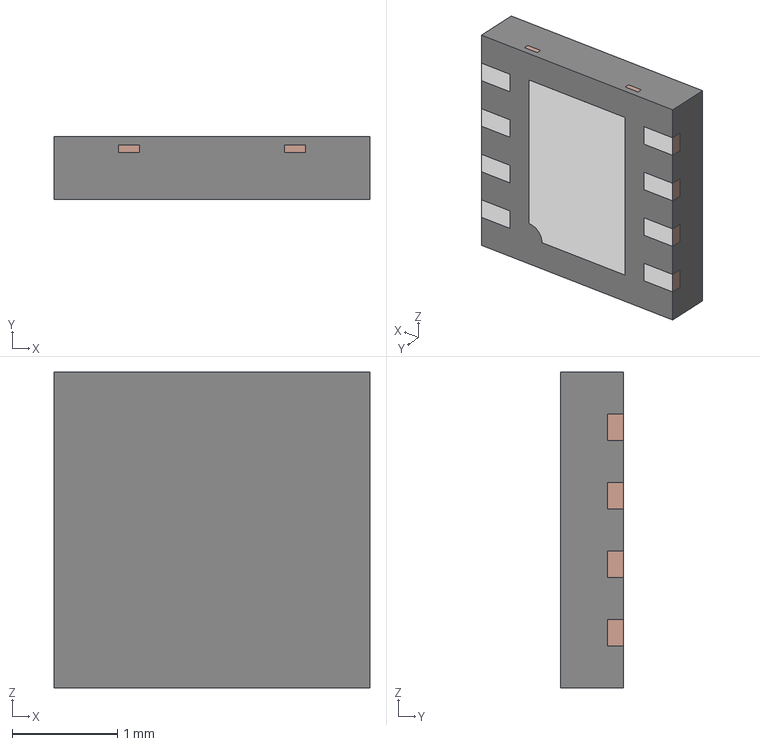
[picture p175: CAD file, 2025-03-07]
SYM/SparkFun-KiCad-Libraries/Footprints/SparkFun-3D-models/Semiconductor-Standard/DFN-8_3x3mm_P0.65mm.step
3.00 x 0.6 x 3.00 mm
LDF
CPD
