Duy-Thanh/DroneShipping/SYM/SparkFun-KiCad-Libraries/Footprints/SparkFun-3D-models/Connector/MagJack_PoE_RJ45.STEP

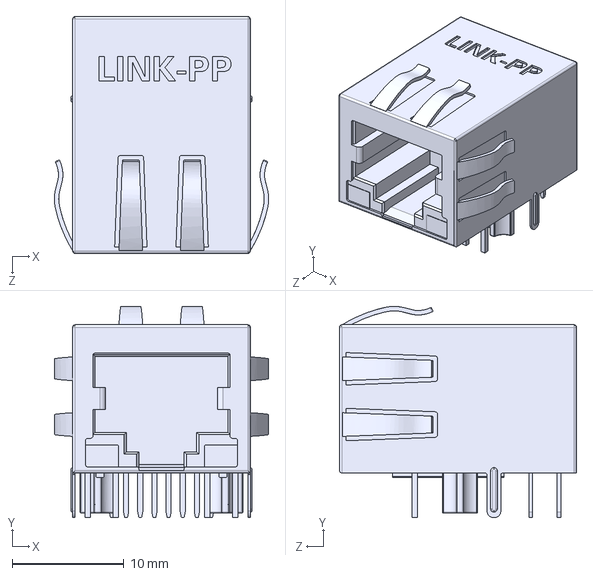
[picture p177: CAD file, 2025-03-07]
SYM/SparkFun-KiCad-Libraries/Footprints/SparkFun-3D-models/Connector/MagJack_PoE_RJ45.STEP
19.2 x 18.9 x 21.2 mm
