Duy-Thanh/DroneShipping/SYM/SparkFun-KiCad-Libraries/Footprints/SparkFun-3D-models/Switch/Push_SMD_6.2x6.2mm_h7.0mm.step

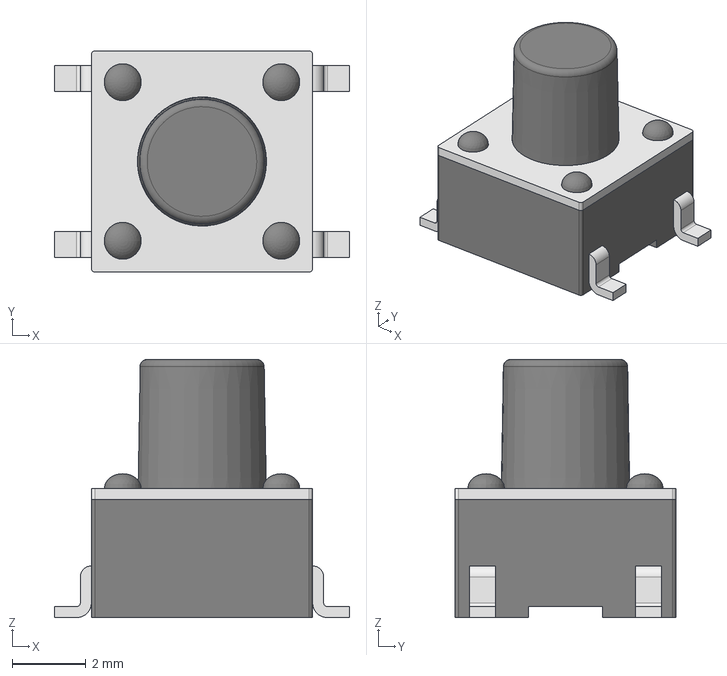
[picture p179: CAD file, 2025-03-07]
SYM/SparkFun-KiCad-Libraries/Footprints/SparkFun-3D-models/Switch/Push_SMD_6.2x6.2mm_h7.0mm.step
8.00 x 6.00 x 7.00 mm
