Duy-Thanh/DroneShipping/SYM/SparkFun-KiCad-Libraries/Footprints/SparkFun-3D-models/Semiconductor-Standard/QFN-60-1EP_7x7mm_P0.4mm_EP3.5x3.5mm.step

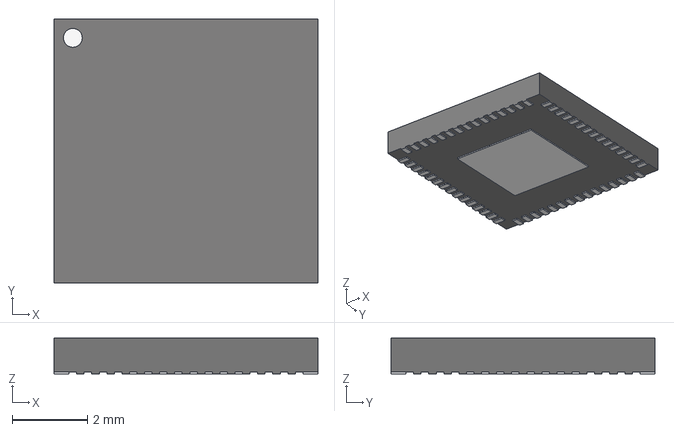
[picture p180: CAD file, 2025-03-07]
SYM/SparkFun-KiCad-Libraries/Footprints/SparkFun-3D-models/Semiconductor-Standard/QFN-60-1EP_7x7mm_P0.4mm_EP3.5x3.5mm.step
7.00 x 7.00 x 0.95 mm
