Duy-Thanh/DroneShipping/SYM/SparkFun-KiCad-Libraries/Footprints/SparkFun-3D-models/Connector/JST_SMD_1.0mm-8.STEP

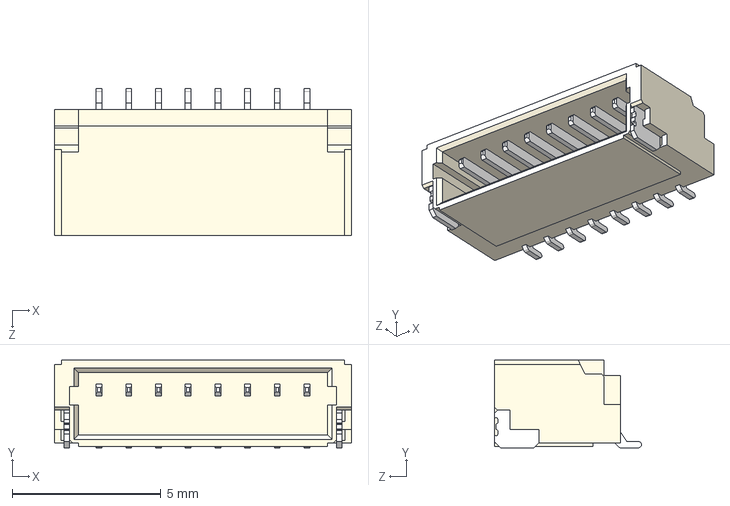
[picture p182: CAD file, 2025-03-07]
SYM/SparkFun-KiCad-Libraries/Footprints/SparkFun-3D-models/Connector/JST_SMD_1.0mm-8.STEP
10.00 x 2.95 x 4.95 mm
