Duy-Thanh/DroneShipping/SYM/SparkFun-KiCad-Libraries/Footprints/SparkFun-3D-models/Switch/Tactal Switch - THRU(12mmx12mmx8mm)-Black.stp

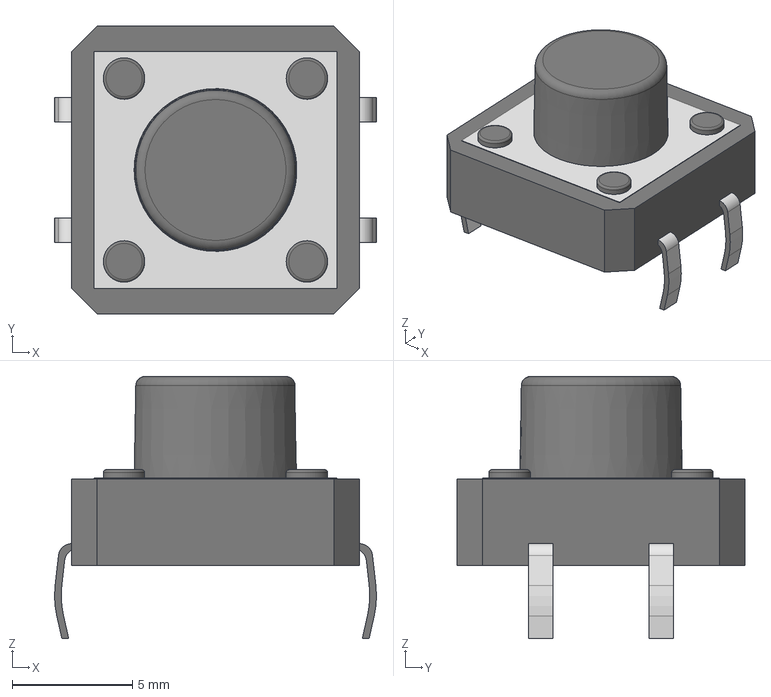
[picture p184: CAD file, 2025-03-07]
SYM/SparkFun-KiCad-Libraries/Footprints/SparkFun-3D-models/Switch/Tactal Switch - THRU(12mmx12mmx8mm)-Black.stp
13.4 x 12.0 x 10.9 mm
