Duy-Thanh/DroneShipping/SYM/SparkFun-KiCad-Libraries/Footprints/SparkFun-3D-models/Connector/Power_Jack_SMD.step

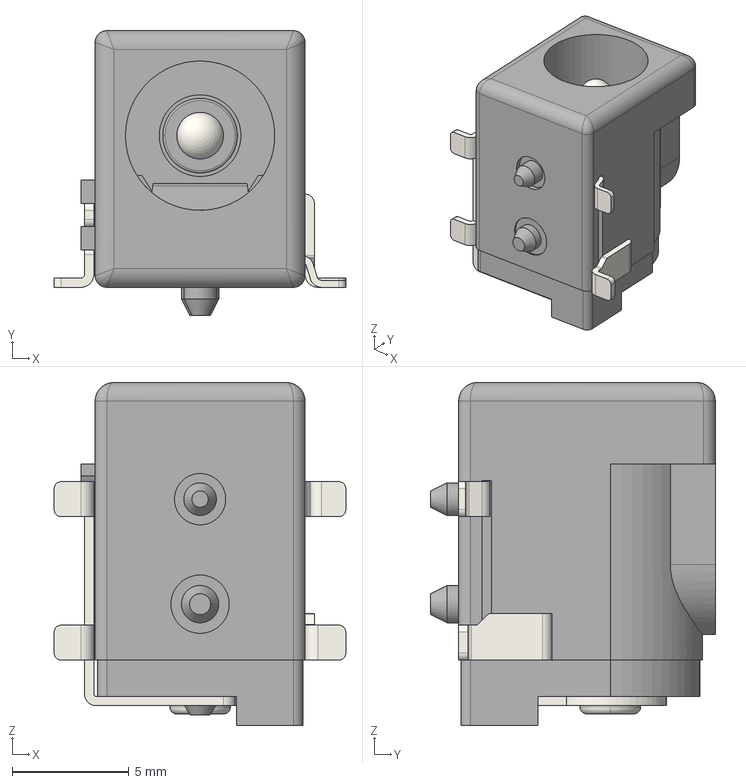
[picture p185: CAD file, 2025-03-07]
SYM/SparkFun-KiCad-Libraries/Footprints/SparkFun-3D-models/Connector/Power_Jack_SMD.step
12.5 x 12.2 x 14.7 mm
