Duy-Thanh/DroneShipping/SYM/SparkFun-KiCad-Libraries/Footprints/SparkFun-3D-models/Semiconductor-Standard/SO-8_3.9x4.9mm_P1.27mm.step

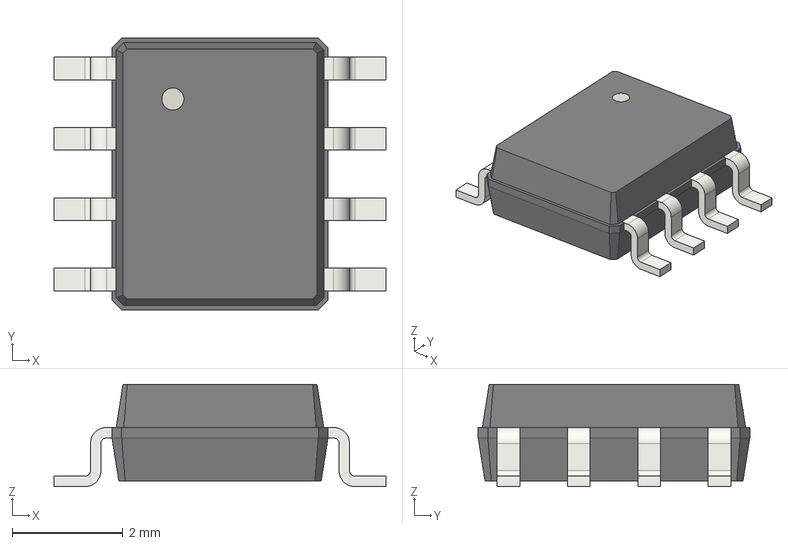
[picture p186: CAD file, 2025-03-07]
SYM/SparkFun-KiCad-Libraries/Footprints/SparkFun-3D-models/Semiconductor-Standard/SO-8_3.9x4.9mm_P1.27mm.step
6.00 x 4.91 x 1.85 mm
729b06ae-9266-11ed-9e62-a0cec80452fd_part
729b0bae-9266-11ed-9e62-a0cec80452fd_part
729b0e92-9266-11ed-9e62-a0cec80452fd_part
729b1108-9266-11ed-9e62-a0cec80452fd_part
