Duy-Thanh/DroneShipping/SYM/SparkFun-KiCad-Libraries/Footprints/SparkFun-3D-models/Switch/Push_SMD_4.6x2.8mm_h1.9mm-Oval.step

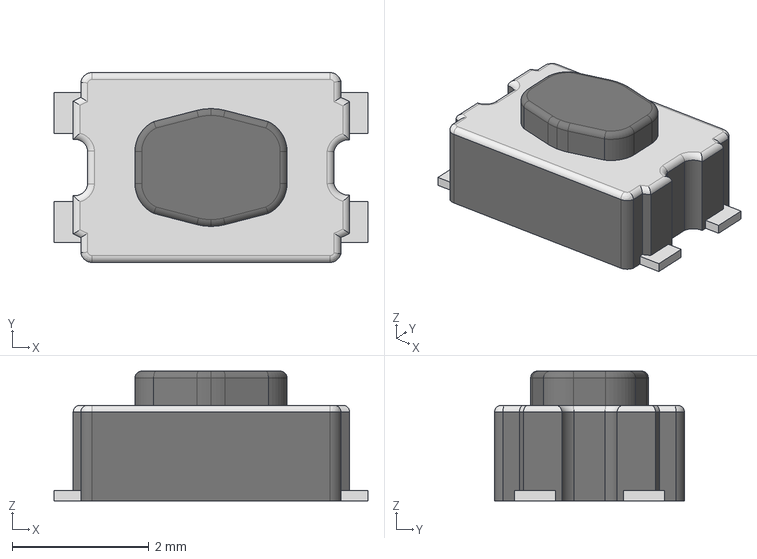
[picture p187: CAD file, 2025-03-07]
SYM/SparkFun-KiCad-Libraries/Footprints/SparkFun-3D-models/Switch/Push_SMD_4.6x2.8mm_h1.9mm-Oval.step
4.60 x 2.78 x 1.90 mm
