Duy-Thanh/DroneShipping/SYM/SparkFun-KiCad-Libraries/Footprints/SparkFun-3D-models/Connector/Qwiic-Horizontal.STEP

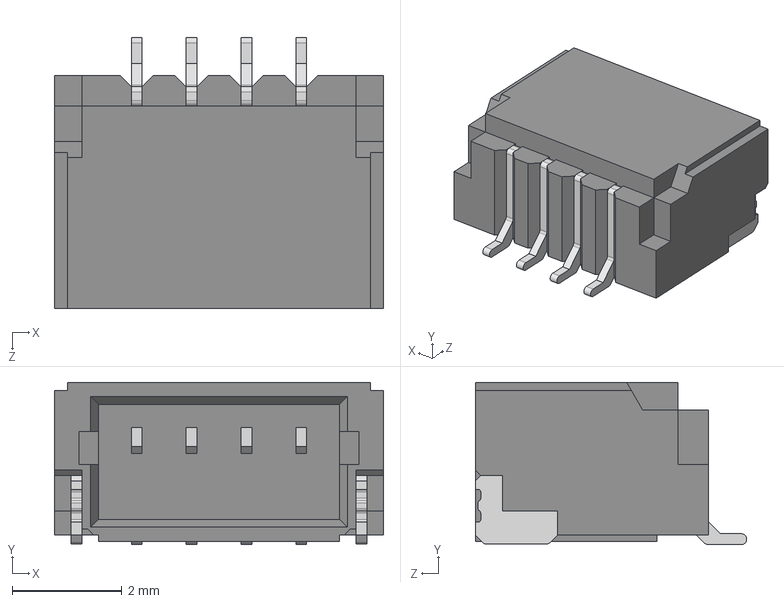
[picture p188: CAD file, 2025-03-07]
SYM/SparkFun-KiCad-Libraries/Footprints/SparkFun-3D-models/Connector/Qwiic-Horizontal.STEP
6.00 x 2.96 x 4.95 mm
