Duy-Thanh/DroneShipping/SYM/SparkFun-KiCad-Libraries/Footprints/SparkFun-3D-models/Switch/SW_SPDT_PCM12.step

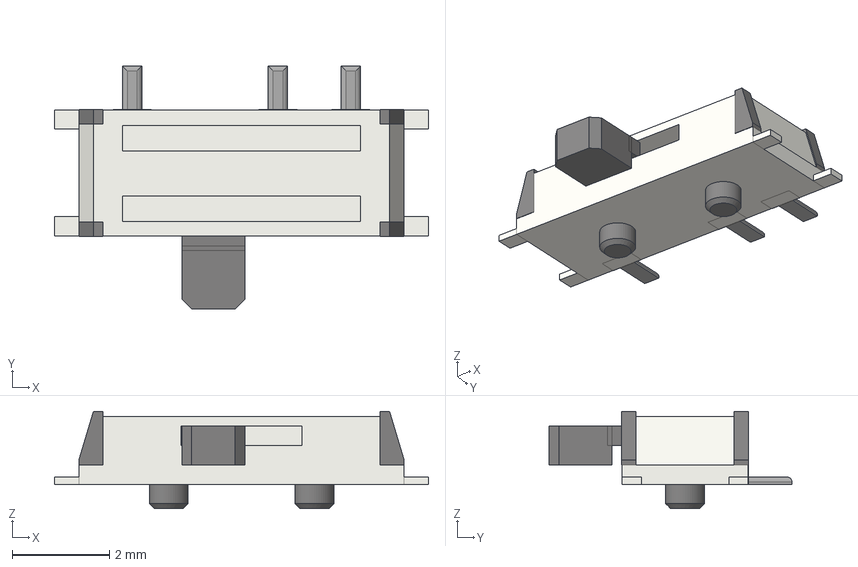
[picture p190: CAD file, 2025-03-07]
SYM/SparkFun-KiCad-Libraries/Footprints/SparkFun-3D-models/Switch/SW_SPDT_PCM12.step
7.70 x 5.00 x 2.00 mm
