Duy-Thanh/DroneShipping/SYM/SparkFun-KiCad-Libraries/Footprints/SparkFun-3D-models/Semiconductor-Standard/QFN-24_4x4mm_P0.5mm.step

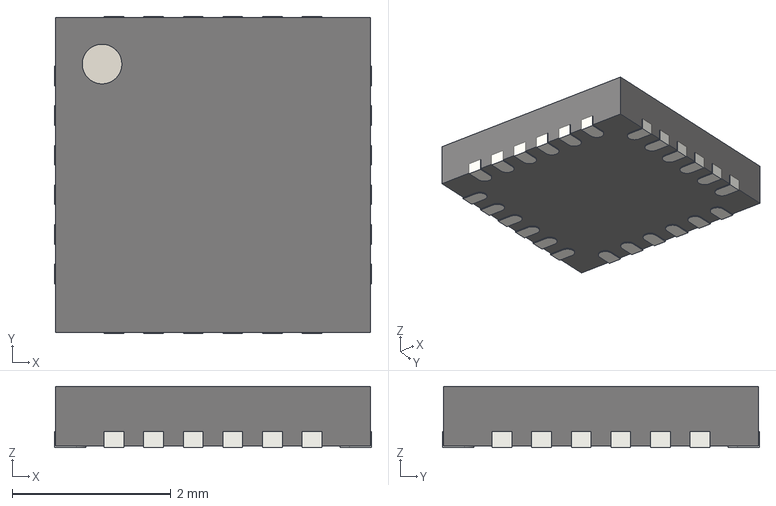
[picture p192: CAD file, 2025-03-07]
SYM/SparkFun-KiCad-Libraries/Footprints/SparkFun-3D-models/Semiconductor-Standard/QFN-24_4x4mm_P0.5mm.step
4.00 x 4.00 x 0.77 mm
