Duy-Thanh/DroneShipping/SYM/SparkFun-KiCad-Libraries/Footprints/SparkFun-3D-models/Switch/Push_SMD_RA_5x3mm.step

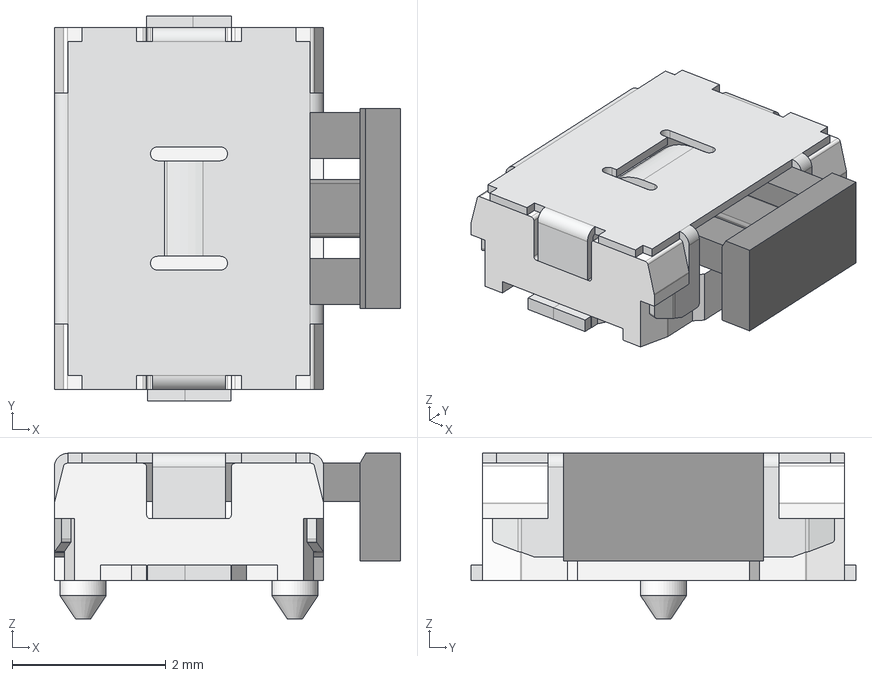
[picture p193: CAD file, 2025-03-07]
SYM/SparkFun-KiCad-Libraries/Footprints/SparkFun-3D-models/Switch/Push_SMD_RA_5x3mm.step
4.50 x 5.00 x 2.15 mm
pins x 4
frame
stem
cover
