Duy-Thanh/DroneShipping/SYM/SparkFun-KiCad-Libraries/Footprints/SparkFun-3D-models/Connector/FPC_0.5mm-12.stp

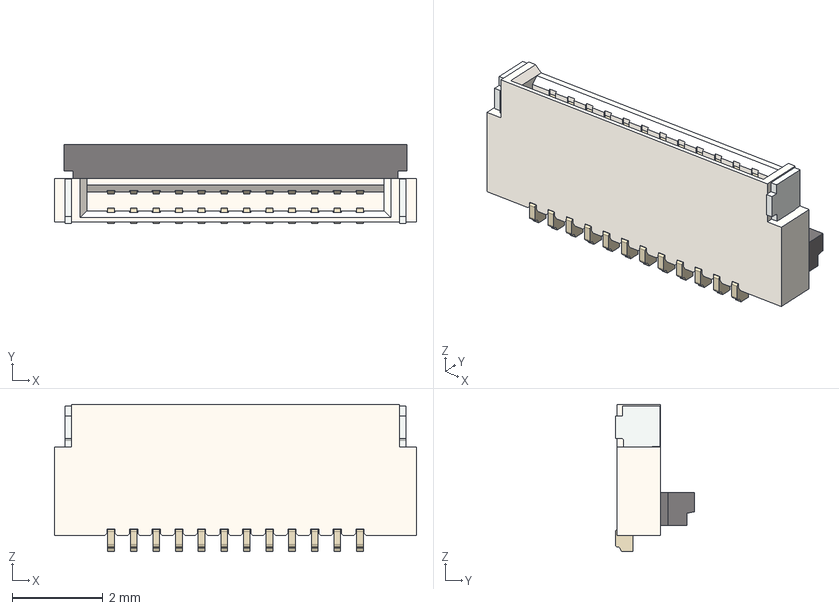
[picture p194: CAD file, 2025-03-07]
SYM/SparkFun-KiCad-Libraries/Footprints/SparkFun-3D-models/Connector/FPC_0.5mm-12.stp
8.00 x 1.75 x 3.25 mm
FFC2B28-12-G_D
FFC2B28-12-G_H
FFC2B28-G_P x 12
FFC2B28-12-G_C
FFC2B28_SP x 2
