Duy-Thanh/DroneShipping/SYM/SparkFun-KiCad-Libraries/Footprints/SparkFun-3D-models/Semiconductor-Standard/WSON-8-1EP_6x5mm_P1.27mm_EP3.4x4.3mm.step

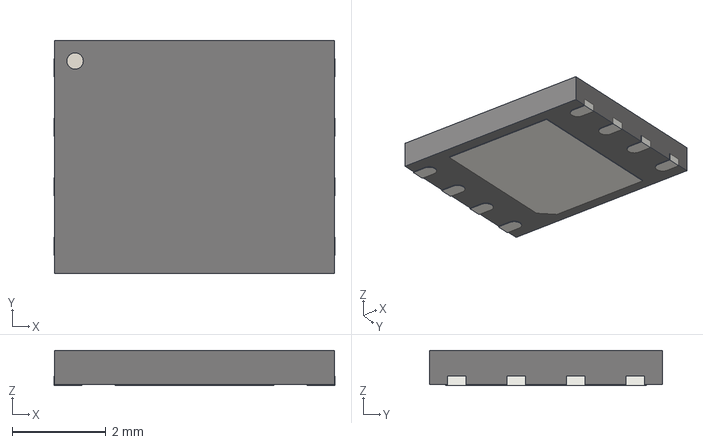
[picture p195: CAD file, 2025-03-07]
SYM/SparkFun-KiCad-Libraries/Footprints/SparkFun-3D-models/Semiconductor-Standard/WSON-8-1EP_6x5mm_P1.27mm_EP3.4x4.3mm.step
6.00 x 4.98 x 0.75 mm
