Duy-Thanh/DroneShipping/SYM/SparkFun-KiCad-Libraries/Footprints/SparkFun-3D-models/Connector/microSD_Friction_Fit.step

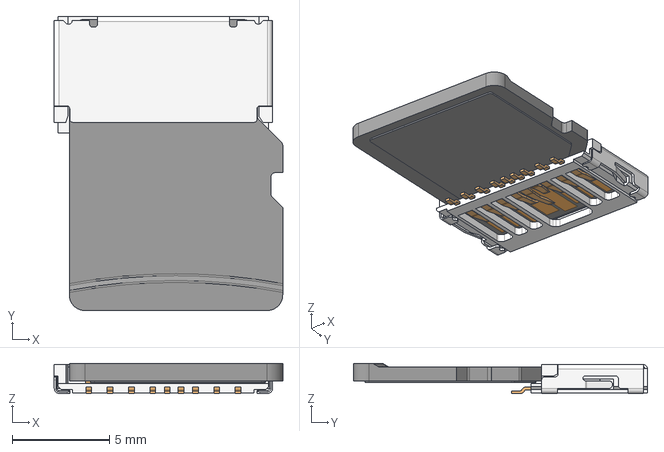
[picture p198: CAD file, 2025-03-07]
SYM/SparkFun-KiCad-Libraries/Footprints/SparkFun-3D-models/Connector/microSD_Friction_Fit.step
11.8 x 15.1 x 1.56 mm
