Duy-Thanh/DroneShipping/SYM/SparkFun-KiCad-Libraries/Footprints/SparkFun-3D-models/Semiconductor-Standard/MSOP-10_3x3mm_P0.5mm.step

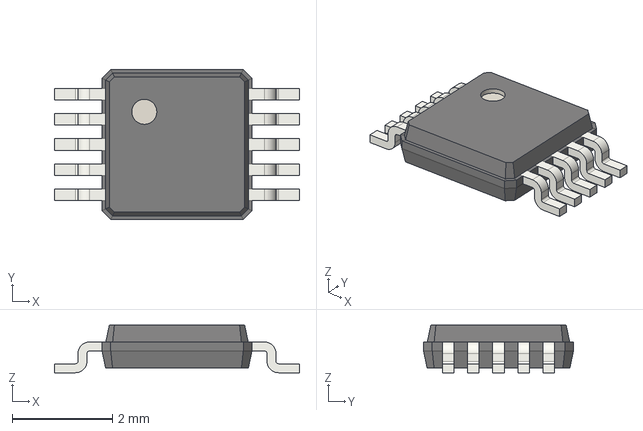
[picture p199: CAD file, 2025-03-07]
SYM/SparkFun-KiCad-Libraries/Footprints/SparkFun-3D-models/Semiconductor-Standard/MSOP-10_3x3mm_P0.5mm.step
4.90 x 3.00 x 0.95 mm
