Duy-Thanh/DroneShipping/SYM/SparkFun-KiCad-Libraries/Footprints/SparkFun-3D-models/Semiconductor-Standard/SO-16W_7.5x10.3mm_P1.27mm.step

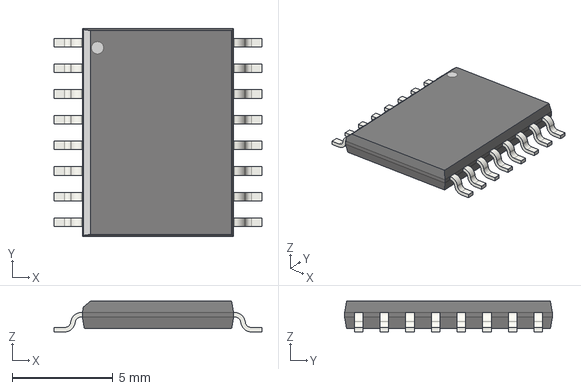
[picture p201: CAD file, 2025-03-07]
SYM/SparkFun-KiCad-Libraries/Footprints/SparkFun-3D-models/Semiconductor-Standard/SO-16W_7.5x10.3mm_P1.27mm.step
10.3 x 10.3 x 1.52 mm
