Duy-Thanh/DroneShipping/(list of files, cad)

Other CAD files:
SYM/SparkFun-KiCad-Libraries/Footprints/SparkFun-3D-models/RF/ESP32-MINI.step
SYM/SparkFun-KiCad-Libraries/Footprints/SparkFun-3D-models/LED/LED_0603_1608Metric_White.step
SYM/SparkFun-KiCad-Libraries/Footprints/SparkFun-3D-models/LED/LED_1206_3216Metric_Castellated_Orange.step
SYM/SparkFun-KiCad-Libraries/Footprints/SparkFun-3D-models/LED/LED_1206_3216Metric_Castellated_Yellow.step
SYM/SparkFun-KiCad-Libraries/Footprints/SparkFun-3D-models/LED/LED_0603_1608Metric_Blue.STEP
SYM/SparkFun-KiCad-Libraries/Footprints/SparkFun-3D-models/Capacitor/CP_EIA-3528-21_Vishay-B.step
SYM/SparkFun-KiCad-Libraries/Footprints/SparkFun-3D-models/LED/LED_1206_3216Metric_Castellated_Blue.step
SYM/SparkFun-KiCad-Libraries/Footprints/SparkFun-3D-models/LED/LED_1206_3216Metric_Castellated_Green.step
SYM/SparkFun-KiCad-Libraries/Footprints/SparkFun-3D-models/LED/LED_0603_1608Metric_Red.STEP
SYM/SparkFun-KiCad-Libraries/Footprints/SparkFun-3D-models/LED/LED_1206_3216Metric_Castellated_Red.step
SYM/SparkFun-KiCad-Libraries/Footprints/SparkFun-3D-models/LED/LED_1206_3216Metric_Castellated_Pink.step
SYM/SparkFun-KiCad-Libraries/Footprints/SparkFun-3D-models/LED/LED_0603_1608Metric_Green.STEP
SYM/SparkFun-KiCad-Libraries/Footprints/SparkFun-3D-models/LED/LED_0603_1608Metric_Orange.step
SYM/SparkFun-KiCad-Libraries/Footprints/SparkFun-3D-models/Connector/1x04_RA_SMD.step
SYM/SparkFun-KiCad-Libraries/Footprints/SparkFun-3D-models/Connector/1x05_2.0mm.step
SYM/SparkFun-KiCad-Libraries/Footprints/SparkFun-3D-models/Connector/1x05_2.0mm_SMD_Pin1RightDown.step
SYM/SparkFun-KiCad-Libraries/Footprints/SparkFun-3D-models/Connector/1x06_SMD_Pin1RightDown.step
SYM/SparkFun-KiCad-Libraries/Footprints/SparkFun-3D-models/Connector/1x10_SMD_Pin1RightDown.step
SYM/SparkFun-KiCad-Libraries/Footprints/SparkFun-3D-models/Connector/1x20_2.54mm_SMD_Pin1RightUp.step
SYM/SparkFun-KiCad-Libraries/Footprints/SparkFun-3D-models/Connector/2x05_P1.27mm_SMD_Unshrouded.step
SYM/SparkFun-KiCad-Libraries/Footprints/SparkFun-3D-models/Connector/2x10_2.0mm_Header_SMD_Peg-1.0mm.stp
SYM/SparkFun-KiCad-Libraries/Footprints/SparkFun-3D-models/Connector/FPC_0.5mm-22-Vertical.STEP
SYM/SparkFun-KiCad-Libraries/Footprints/SparkFun-3D-models/Connector/IDC-Header_2x20_P2.54mm_Vertical.step
SYM/SparkFun-KiCad-Libraries/Footprints/SparkFun-3D-models/Connector/JST_PTH-2.step
SYM/SparkFun-KiCad-Libraries/Footprints/SparkFun-3D-models/Connector/JST_SM14B-SRSS-TB.STEP
SYM/SparkFun-KiCad-Libraries/Footprints/SparkFun-3D-models/Connector/JST_SMD_1.0mm-3.STEP
SYM/SparkFun-KiCad-Libraries/Footprints/SparkFun-3D-models/Connector/JST_SMD_1.0mm-4.STEP
SYM/SparkFun-KiCad-Libraries/Footprints/SparkFun-3D-models/Connector/JST_SMD_1.0mm-6.STEP
SYM/SparkFun-KiCad-Libraries/Footprints/SparkFun-3D-models/Connector/JST_SMD_1.25mm-3_Locking.STEP
SYM/SparkFun-KiCad-Libraries/Footprints/SparkFun-3D-models/Connector/JST_SMD_1.25mm-4_Locking.step
SYM/SparkFun-KiCad-Libraries/Footprints/SparkFun-3D-models/Connector/JST_SMD_1.25mm-5_Locking.STEP
SYM/SparkFun-KiCad-Libraries/Footprints/SparkFun-3D-models/Connector/JST_SMD_1.25mm-7_Locking.STEP
SYM/SparkFun-KiCad-Libraries/Footprints/SparkFun-3D-models/Connector/PinHeader_1x06_P2.54mm_Horizontal_SMD_Right.step
SYM/SparkFun-KiCad-Libraries/Footprints/SparkFun-3D-models/Connector/PinHeader_1x10_P2.54mm_Vertical.step
SYM/SparkFun-KiCad-Libraries/Footprints/SparkFun-3D-models/Connector/PinSocket_1x08_P2.54mm_Vertical_SMD_Pin1Right.step
SYM/SparkFun-KiCad-Libraries/Footprints/SparkFun-3D-models/Connector/Power_Jack_PTH.step
SYM/SparkFun-KiCad-Libraries/Footprints/SparkFun-3D-models/Connector/Qwiic-Horizontal-White.STEP
SYM/SparkFun-KiCad-Libraries/Footprints/SparkFun-3D-models/Connector/Qwiic-Vertical.step
SYM/SparkFun-KiCad-Libraries/Footprints/SparkFun-3D-models/Connector/RP-SMA-Edge.step
SYM/SparkFun-KiCad-Libraries/Footprints/SparkFun-3D-models/Connector/Raspberry_Pi_Passthrough_Header.step
SYM/SparkFun-KiCad-Libraries/Footprints/SparkFun-3D-models/Connector/SMA-Edge.step
SYM/SparkFun-KiCad-Libraries/Footprints/SparkFun-3D-models/Connector/Screw_Cage_3.5mm-10.step
SYM/SparkFun-KiCad-Libraries/Footprints/SparkFun-3D-models/Connector/Screw_Terminal_3.5mm_2P_Black.step
SYM/SparkFun-KiCad-Libraries/Footprints/SparkFun-3D-models/Connector/Screw_Terminal_3.5mm_2P_Blue.step
SYM/SparkFun-KiCad-Libraries/Footprints/SparkFun-3D-models/Connector/Screw_Terminal_3.5mm_3P_Black.step
SYM/SparkFun-KiCad-Libraries/Footprints/SparkFun-3D-models/Connector/Screw_Terminal_3.5mm_3P_Blue.step
SYM/SparkFun-KiCad-Libraries/Footprints/SparkFun-3D-models/Connector/microSD_External_Pin.step
SYM/SparkFun-KiCad-Libraries/Footprints/SparkFun-3D-models/Hardware/Nut_4-40.step
SYM/SparkFun-KiCad-Libraries/Footprints/SparkFun-3D-models/Hardware/Nut_M3.step
SYM/SparkFun-KiCad-Libraries/Footprints/SparkFun-3D-models/Hardware/Screw_4-40.step
SYM/SparkFun-KiCad-Libraries/Footprints/SparkFun-3D-models/Hardware/Screw_M3.step
SYM/SparkFun-KiCad-Libraries/Footprints/SparkFun-3D-models/Semiconductor-Standard/D_SOD-323.step
SYM/SparkFun-KiCad-Libraries/Footprints/SparkFun-3D-models/Semiconductor-Standard/VSSOP-8_2.3x2mm_P0.5mm.step
