Duy-Thanh/DroneShipping/SPICE/STM32F103C8Tx/tests/clock_reset_test.txt

 time           time           time           v(hse)         time           v(sysclk)      time           v(pll_clk)     time           v(hclk)        time           v(pclk1)       time           v(pclk2)       time           v(nrst)        time           v(por_n)       time           v(sys_rst)    
 1.0000000e-10  1.0000000e-10  1.0000000e-10  3.3000000e-02  1.0000000e-10  3.3000000e-02  1.0000000e-10  3.3000000e-02  1.0000000e-10  3.3000000e-02  1.0000000e-10  3.3000000e-02  1.0000000e-10  3.3000000e-02  1.0000000e-10  3.3000000e+00  1.0000000e-10  0.0000000e+00  1.0000000e-10  0.0000000e+00 
 2.0000000e-10  2.0000000e-10  2.0000000e-10  6.6000000e-02  2.0000000e-10  6.6000000e-02  2.0000000e-10  6.6000000e-02  2.0000000e-10  6.6000000e-02  2.0000000e-10  6.6000000e-02  2.0000000e-10  6.6000000e-02  2.0000000e-10  3.3000000e+00  2.0000000e-10  0.0000000e+00  2.0000000e-10  0.0000000e+00 
 4.0000000e-10  4.0000000e-10  4.0000000e-10  1.3200000e-01  4.0000000e-10  1.3200000e-01  4.0000000e-10  1.3200000e-01  4.0000000e-10  1.3200000e-01  4.0000000e-10  1.3200000e-01  4.0000000e-10  1.3200000e-01  4.0000000e-10  3.3000000e+00  4.0000000e-10  0.0000000e+00  4.0000000e-10  0.0000000e+00 
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
