Duy-Thanh/DroneShipping/SPICE/STM32F103C8Tx/tests/debug.txt

                 * stm32f103 power system test - debug version
                 Transient Analysis  Fri Mar  7 17:48:33  2025
--------------------------------------------------------------------------------
Index   time            v(vdd)          v(vdd_int)      v(vok)          
--------------------------------------------------------------------------------
0	1.0000000e-09	3.3000000e-04	7.0197830e-08	0.0000000e+00	
1	1.0840119e-09	3.5772393e-04	7.6590732e-08	0.0000000e+00	
2	1.2520357e-09	4.1317180e-04	9.0367413e-08	0.0000000e+00	
3	1.5880834e-09	5.2406752e-04	1.2386583e-07	0.0000000e+00	
4	2.2601787e-09	7.4585898e-04	2.1464074e-07	0.0000000e+00	
5	3.6043694e-09	1.1894419e-03	4.9128589e-07	0.0000000e+00	
6	6.2927506e-09	2.0766077e-03	1.4248216e-06	0.0000000e+00	
7	1.1669513e-08	3.8509394e-03	4.8117875e-06	0.0000000e+00	
8	2.2423038e-08	7.3996026e-03	1.7656614e-05	0.0000000e+00	
9	4.3930089e-08	1.4496929e-02	6.7560553e-05	0.0000000e+00	
10	8.6944189e-08	2.8691582e-02	2.6367407e-04	0.0000000e+00	
11	1.0000000e-07	3.3000000e-02	3.4850822e-04	0.0000000e+00	
12	1.0860282e-07	3.5838931e-02	4.1335074e-04	0.0000000e+00	
13	1.2580846e-07	4.1516792e-02	5.5317254e-04	0.0000000e+00	
14	1.6021974e-07	5.2872514e-02	8.9341483e-04	0.0000000e+00	
15	2.2904230e-07	7.5583959e-02	1.8140919e-03	0.0000000e+00	
16	3.2904230e-07	1.0858396e-01	3.7145095e-03	0.0000000e+00	
17	4.2904230e-07	1.4158396e-01	6.2696548e-03	0.0000000e+00	
18	5.2904230e-07	1.7458396e-01	9.4657438e-03	0.0000000e+00	
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
1015	9.8519021e-05	3.3000000e+00	
1016	9.8619021e-05	3.3000000e+00	
1017	9.8719021e-05	3.3000000e+00	
1018	9.8819021e-05	3.3000000e+00	
1019	9.8919021e-05	3.3000000e+00	
1020	9.9019021e-05	3.3000000e+00	
1021	9.9119021e-05	3.3000000e+00	
1022	9.9219021e-05	3.3000000e+00	
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
