Duy-Thanh/DroneShipping/(commit log)

2025-03-07 Simplified Power Supply for STM32 MCU
2025-03-07 Power Supply for STM32 MCU
2025-03-07 Clock and Reset STM32 MCU
