Duy-Thanh/DroneShipping/(notices)

Notices in the files:
SYM/SparkFun-KiCad-Libraries/Footprints/SparkFun-3D-models/Semiconductor-Standard/QFN-16-1EP_3x3mm_P0.5mm_EP1.8x1.8mm.step:
Copyright (C) 2017, kicad StepUp
This program is free software: you can redistribute it and/or modify
it under the terms of the GNU General Public License as published by
the Free Software Foundation, either version 3 of the License, or
any later version.
itself might be covered by the GNU General Public License.
SYM/SparkFun-KiCad-Libraries/Footprints/SparkFun-3D-models/Semiconductor-Standard/QFN-32-1EP_5x5mm_P0.5mm_EP3.3x3.3mm.step:
Copyright (C) 2019, kicad StepUp
This work is licensed under the [Creative Commons CC-BY-SA 4.0 License](https://creativecommons.org/licenses/by-sa/4.0/legalcode),
with the following exception:
To the extent that the creation of electronic designs that use 'Licensed Material' can be considered to be 'Adapted Material',
You are free to use the library data in your own projects without the obligation to share your project files under this or any other license agreement.
SYM/SparkFun-KiCad-Libraries/Footprints/SparkFun-3D-models/Semiconductor-Standard/SO-16_3.9x9.9mm_P1.27mm.step:
Copyright (C) 2024, KiCAD
This work is licensed under the
[Creative Commons CC-BY-SA 4.0 License](https://creativecommons.org/licenses/by-sa/4.0/legalcode),
project files under this or any other license agreement. However, if you wish to distribute
SYM/SparkFun-KiCad-Libraries/Footprints/SparkFun-3D-models/Resistor/R_0603_1608Metric.step:
Copyright (C) 2018, kicad StepUp
SYM/SparkFun-KiCad-Libraries/Footprints/SparkFun-3D-models/Semiconductor-Standard/SO-8_3.9x4.9mm_P1.27mm.step:
Copyright (C) 2023, KiCAD
SYM/SparkFun-KiCad-Libraries/Footprints/SparkFun-3D-models/Connector/IDC-Header_2x05_P2.54mm_Vertical_SMD.step:
Copyright (C) 2022, kicad StepUp
SYM/SparkFun-KiCad-Libraries/Footprints/SparkFun-3D-models/Semiconductor-Standard/SO-14_3.9x8.65mm_P1.27mm.step:
Copyright (C) 2022, KiCAD
SYM/SparkFun-KiCad-Libraries/Footprints/SparkFun-3D-models/Connector/FPC_0.5mm-12.stp:
author */ ('License CC BY-ND 4.0'),
